Mejez6603/Jolly-Helmet/ESP32 Project/FLOWCHART_BOX3/BOX3_Flow_TFT.pdf

# JOLLY HELMET · BOX 3

# Customer screen flow: what the TFT shows, step by step

### Source: BOX 3 STEP corrected.txt (Box Cycle Designer export) file saved 2026-11-03 00:04 · 36 steps · preset “NEW FLOW”

Pictures are drawn from the screen data in that file (numbers on them are examples).

start / end screen | screen the customer sees | the machine is running | side screen (question or notice) | fault | arrow text = what moves the screen on | 1 | side screen shown at the bottom

Notes
Steps named CL … (Cleaning) and DR … (Drying) are two copies of the same screens in the Designer; the chart shows each picture once. All 48 connections in this chart were checked against the file: they all exist.
The time on the pictures, the progress bar, the coin count and the status line are examples; on the unit they count live.

Every step in the file is drawn.
SAFETY PAUSE (a door opens during a run) is built into the box and is not a step in this file, so it is not drawn.
Removed from the old flow: ratings, time picker, mist choice, free retry and the refill screens (the Refilling Station fills the containers by itself, the box only reads the level).

### START SCREEN

Resting screen. Any touch starts.
TAPS

### CHECKING MAIN CONTAINER

Please wait, 2 seconds. The level of the main container comes from the Refilling Station. Machine: everything off · 2 s fixed
CHECKING C

### WELCOME

Tap → SELECT MODE. If the Refilling Station is silent (15 s) or the container is EMPTY / LOW → the dry-only screen.
WELCOME

### SELECT MODE

The customer picks CLEANING or DRYING. Buttons: CLEANING / DRYING
SELECT MODE

### SELECT MODE · DRY ONLY

CLEANING is greyed out (the container is EMPTY or LOW, or the Refilling Station is not heard). Only DRYING can be pressed. Buttons: DRYING
SELECT DRY ONLY

### INSERT COIN 1

### 15 coins = 5 min. More coins add time, up

to 90 coins (30 min). CANCEL → ① Machine: coin slot ON
CL INSERT COIN / DR INSERT COIN

### OPEN THE DOOR

The door stays unlocked until it is opened. Machine: door lock released
CL OPEN A / DR OPEN A

### PLACE THE HELMET 3

Waits for the helmet. Door closed with no helmet → notice ③.
CL SENSORS A / DR SENSORS A

### CLOSE THE DOOR 3

Door closed + helmet inside → the run starts. No helmet → notice ③.
CL CLOSE DOOR A / DR CLOSE DOOR A

### CLEANING (UV + MIST) 2

Extra coins add time.
Machine: coin slot ON · 3 humidifiers (mist)
- UV 1 + UV 2 · time bought with the coins
CLEANING BAL

### DRYING AFTER CLEANING

Starts by itself when the cleaning time is up. Also reached by CANCEL → CONFIRM ②. Machine: UV 1 + UV 2 · heater (OFF for the last 30 s) · 3:00 min fixed
CL HEATING

### PLEASE WAIT

Short transition before the drying starts.
START HEATING

### DRYING (UV + HEAT) 2

Extra coins add time.
Machine: coin slot ON · UV 1 + UV 2 · heater · time bought with the coins
DR HEATING

### COOLING DOWN

Passive cool-down before the door unlocks. Machine: everything off · 1:00 min fixed
DR COOLDOWN

### OPEN THE DOOR

The door lock is released. Machine: door lock released
CL OPEN B / DR OPEN B

### TAKE THE HELMET 4

Waits until the helmet is out. Door closed with the helmet still inside → notice ④.
CL SENSORS B / DR SENSORS B

### CLOSE THE DOOR 4

Door closed + helmet out → Thank you.
CL CLOSE DOOR B / DR CLOSE DOOR B

### THANK YOU

Then back to the start screen. Machine: everything off · 5 s fixed
CL FINISH / DR FINISH

### ① CANCEL? (COIN STAGE)

Shown by the CANCEL button on INSERT COIN.
YES → back to the start screen
NO → back to the previous screen
CL CANCEL / DR CANCEL

### ② CANCEL? (DURING THE RUN)

Shown by the CANCEL button while cleaning or drying.
CONFIRM → Drying after cleaning
RESUME → back to the previous screen
CL ABORT / DR ABORT

### ③ NO HELMET DETECTED

Shown 2 s, then back to OPEN THE DOOR. after 2 s → Open the door
CL HELMET NOTICE A / DR HELMET NOTICE A

### ④ HELMET STILL INSIDE

Shown 2 s, then back to OPEN THE DOOR. after 2 s → Open the door
CL HELMET NOTICE B / DR HELMET NOTICE B

### MAINTENANCE

Technician only: switched on from the LocalServer page.
MAINTENANCE

### OUT OF ORDER

Shown when the sensor board (helmet, enclosure door) or the relay board stops answering: the box cannot run UV safely and takes no coins.
OUT OF ORDER

### CONTAINER EMPTY OR LOW?

The box offers DRYING only.

### The Refilling Station fills the container by itself: one valve at a

time, EMPTY boxes first, then LOW.

### Nobody has to do anything; the next customer gets CLEANING again as soon as the container reads MID or

more.

### If the station cannot fill it, the owner sees an alert on the Online web

page and the LocalServer.

IF CLEANING WAS CHOSEN | IF DRYING WAS CHOSEN

## SIDE SCREENS (numbers ① ② ③ ④ in the chart above)

tap | after 2 s

tap, container
MID or more

tap, but the container is
EMPTY or LOW, or the
Refilling Station is silent

CLEANING or DRYING button
(DRYING button only, in dry-only)
enough coins | door opened | helmet inside

CLEANING chosen:
door closed + helmet inside

DRYING chosen:
door closed + helmet inside
time is up | automatic | time is up

time is up
time is up
door opened | helmet taken out

door closed,
helmet out

after 5 s: back to the start screen
