Mejez6603/Jolly-Helmet/ESP32 Project/FLOWCHART_SYSTEM/DFD_LEVEL2_3/JollyHelmet_DFD_Level2_Level3.pdf

# JOLLY HELMET

### Data flow diagram (Level 2)

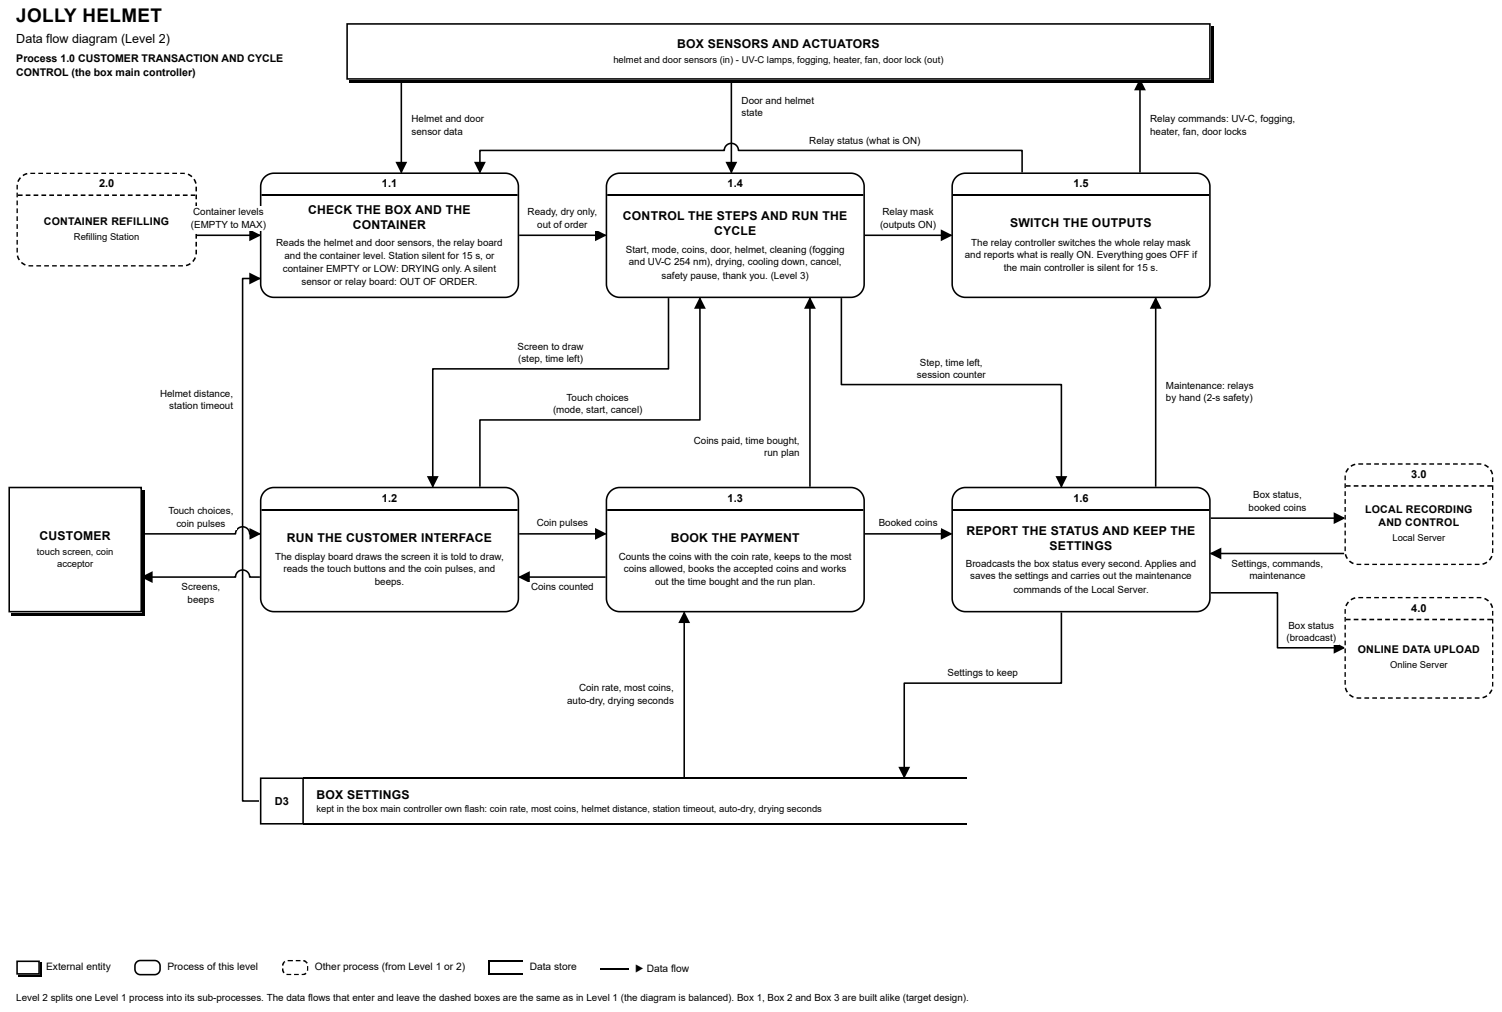
[picture p1: page 1]
External entity; Process of this level; Other process (from Level 1 or 2); Data store; ▶ Data flow; CONTAINER REFILLING; Refilling Station; LOCAL RECORDING AND CONTROL; Local Server; Online Server; CONTAINER; CYCLE; beeps.; SETTINGS; BOX SETTINGS; state; Relay commands: UV-C, fogging,; Touch choices, coin pulses; Screens, beeps; Relay mask (outputs ON); Coin pulses; Coins counted; run plan; Booked coins; Box status, booked coins; Settings, commands, maintenance; Box status (broadcast)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

BOX SENSORS AND ACTUATORS

Process 1.0 CUSTOMER TRANSACTION AND CYCLE
CONTROL (the box main controller)

helmet and door sensors (in) - UV-C lamps, fogging, heater, fan, door lock (out)

Door and helmet

Helmet and door
sensor data

heater, fan, door locks

Relay status (what is ON)

CHECK THE BOX AND THE

Container levels
(EMPTY to MAX)

Ready, dry only,
out of order

CONTROL THE STEPS AND RUN THE

SWITCH THE OUTPUTS

Reads the helmet and door sensors, the relay board
and the container level. Station silent for 15 s, or
container EMPTY or LOW: DRYING only. A silent
sensor or relay board: OUT OF ORDER.

The relay controller switches the whole relay mask
and reports what is really ON. Everything goes OFF if

Start, mode, coins, door, helmet, cleaning (fogging
and UV-C 254 nm), drying, cooling down, cancel,
safety pause, thank you. (Level 3)

the main controller is silent for 15 s.

Screen to draw
(step, time left)

Step, time left,
session counter

Maintenance: relays
by hand (2-s safety)

Touch choices
(mode, start, cancel)

Coins paid, time bought,

REPORT THE STATUS AND KEEP THE

CUSTOMER
touch screen, coin
acceptor

RUN THE CUSTOMER INTERFACE
The display board draws the screen it is told to draw,
reads the touch buttons and the coin pulses, and

BOOK THE PAYMENT

Counts the coins with the coin rate, keeps to the most
coins allowed, books the accepted coins and works
out the time bought and the run plan.

Broadcasts the box status every second. Applies and
saves the settings and carries out the maintenance

commands of the Local Server.

ONLINE DATA UPLOAD

Settings to keep

Coin rate, most coins,
auto-dry, drying seconds

kept in the box main controller own flash: coin rate, most coins, helmet distance, station timeout, auto-dry, drying seconds

Level 2 splits one Level 1 process into its sub-processes. The data flows that enter and leave the dashed boxes are the same as in Level 1 (the diagram is balanced). Box 1, Box 2 and Box 3 are built alike (target design).

Process 2.0 CONTAINER REFILLING (the Refilling Station)

### MAIN CONTAINERS AND WATER SUPPLY

3 water-level sensors (in) - 3 valves (out)

1.0

CUSTOMER
TRANSACTION AND
CYCLE CONTROL
box main controllers

4.0

ONLINE DATA UPLOAD
Online Server

3.0

LOCAL RECORDING
AND CONTROL
Local Server

2.1

### READ THE SENSORS AND WORK OUT THE LEVELS

5 times a second, a 1 s average of the 3 sensors: EMPTY, LOW, MID, HIGH or MAX from the level edges. A stuck or jumping sensor = SENSOR FAULT: level UNKNOWN, no refill.

2.2

### MANAGE THE REFILL QUEUE

A container that is EMPTY or LOW joins the queue. EMPTY ones first, then LOW; the one that waited longest, then Box 1, 2, 3. A refill that is running is never interrupted.

2.3

### CONTROL THE VALVES

Opens the valve of the next box (only ONE valve can be open), closes it at MAX or when the refill fails, waits 60 s before a retry, runs the manual valve test. (Level 3)

2.5

### BROADCAST THE LEVELS AND THE STATUS

Every second, and at once when something changes: levels and raw values of the 3 containers, the open valve, who is waiting, the failed refills. Listen only for the others.

2.4

### KEEP THE STATION SETTINGS

Receives the level edges, waiting times, retry time and the valve test from the Local Server and saves them in the station flash.

D4 STATION SETTINGS kept in the Refilling Station own flash: level edges, waiting times, retry time, test seconds

Water-level readings
(5 times a second)

Valve commands
(open, close)

Level edges,
sensor fault rule

Levels of the
3 containers

Next box
to refill

Refill worked
or failed

Levels (rise, MAX reached)

Levels and
raw values

Who is waiting
(the queue)

Valve open,
failed refill

Container levels (broadcast)

Container levels (broadcast)

Levels, valve state, failures

Station
settings,
Settings to keep | valve test

Saved settings

Stall times, retry,
valve test request

Process 3.0 LOCAL RECORDING AND CONTROL (the Local Server)

4.0

ONLINE DATA
UPLOAD
Online Server

### OWNER / TECHNICIAN

authorized administrator

### TEAM

ENTRY board (spare
ESP32)

1.0

CUSTOMER
TRANSACTION AND
CYCLE CONTROL
box main controllers

2.0

CONTAINER
REFILLING
Refilling Station

3.5

### SEND THE TOTALS

Every 10 s the totals, the coin value and the last 10 sessions go to the Online Server by radio (and a heartbeat every second).

3.2

### RECORD THE SESSIONS AND THE TOTALS

A finished or cancelled session is recorded: date, time, box, Finished or Cancelled, coins, minutes. Totals and revenue (booked coins) are updated.

3.1

### RECEIVE THE RADIO DATA

Listens on ESP-NOW channel 1: box status and booked coins of each box, sensor and relay status, Refilling Station levels, valves, queue and failures.

D1.2 SESSION LOG AND TOTALS kept in the log storage (FFat); a backup CSV can be downloaded and restored

3.3

### SERVE THE CONTROL CENTER

Wi-Fi JollyHelmet-Local: Dashboard every second, Box and Refilling Station pages, day viewer, settings, CSV download and restore, history file, crash reports.

3.4

### KEEP AND SEND THE SETTINGS

Rules, sensors, auto-dry, drying seconds, level edges, maintenance and valve test: saved in flash and sent to the box main controllers and the station.

### D1.3 HISTORY AND CRASHES

history.json, last 3 crash reports

### D1.1 SETTINGS

kept in flash

Totals, last
10 sessions
(every 10 s) | New session,
| booked coins

Live status of the boxes
and the station

Session record,
totals

Totals, last
10 sessions

Session log,
totals

Settings, rules,
maintenance,
valve test

History file,
restored backup

History rows,
crash reports | Settings to keep | Saved settings Settings
(to show)

Settings, rules, maintenance, backup to restore

Control Center pages,
session log, totals, CSV

Previous customers
(history.json)

Box status,
booked coins

Levels, valve state,
failures

Settings, commands,
maintenance

Station settings,
valve test

Process 4.0 ONLINE DATA UPLOAD (the Online Server)

1.0

CUSTOMER
TRANSACTION AND
CYCLE CONTROL
box main controllers

2.0

CONTAINER
REFILLING
Refilling Station

3.0

LOCAL RECORDING
AND CONTROL
Local Server

### OWNER / TECHNICIAN

authorized administrator

4.1

### LISTEN TO THE RADIO

Only listens, never sends. Hears the box status of every box board, the Refilling Station levels and the totals of the Local Server on ESP-NOW channel 1. Takes a snapshot every second.

4.2

### COUNT THE STATISTICS

Counts the sessions per box, per hour, per weekday and per day, and takes the totals and the revenue from the Local Server.

4.3

### WORK OUT THE ALERTS

Every second looks at the snapshot: out of order, Refilling Station offline, refill failed, board not heard.

D5 SNAPSHOT, STATISTICS AND ALERTS kept in the Online Server memory: the last 1 s snapshot, the sessions per box, hour, weekday and day, the alerts

4.5

### KEEP THE SETUP

Router-style setup page on the own Wi-Fi of the Online Server: Wi-Fi name, Blynk token, interval and time zone. The Wi-Fi is tested first, then Blynk.

4.4

### UPLOAD TO THE BLYNK CLOUD

Every interval (30 s to 1 h, default 1 min) a burst of 5 to 10 s: leaves the radio, joins the Wi-Fi, writes the live data, the box steps and any alert, returns to channel 1. (Level 3)

D6 | ONLINE SETUP kept in flash: Wi-Fi name and password, Blynk tokens, interval, time zone
D2.1 | PRIVATE DEVICE V0 live data (JSON)
D2.2 | PUBLIC DEVICE V0 box steps only
D2.3 | ALERT EVENT push to the Blynk app

Box status
(broadcast)

Container levels
(broadcast)

Totals, last 10
sessions (10 s)

Session counters,
totals

Snapshot
(every 1 s)
Statistics | Snapshot | Alerts

Snapshot, statistics,
alerts

Wi-Fi, Blynk token,
interval, time zone

Setup page,
Wi-Fi test result

Setup to keep

Wi-Fi, token, interval,
time zone

Live data
(HTTPS)

Box steps
(HTTPS)

Alert
event

Process 5.0 ONLINE MONITORING (the website)

### OWNER / TECHNICIAN

authorized administrator: Monitor, Alerts and Reports pages (the Blynk token is typed once and kept in that browser)

5.2

### SHOW THE MONITOR AND THE REPORTS

Live, delayed or old data, each box drawn as a machine, the three level dials of the Refilling Station, the network map and the reports.

5.1

### READ THE LIVE DATA

The Monitor page asks Blynk every 10 s, only while the tab is open and visible, with the token typed once and kept in that browser.

5.3

### SHOW THE ALERTS

Alerts in four levels (critical, warning, notice, info) with sounds and a log. The page also says when the data is not yet updated.

### D2.1 PRIVATE DEVICE V0 live data (JSON)

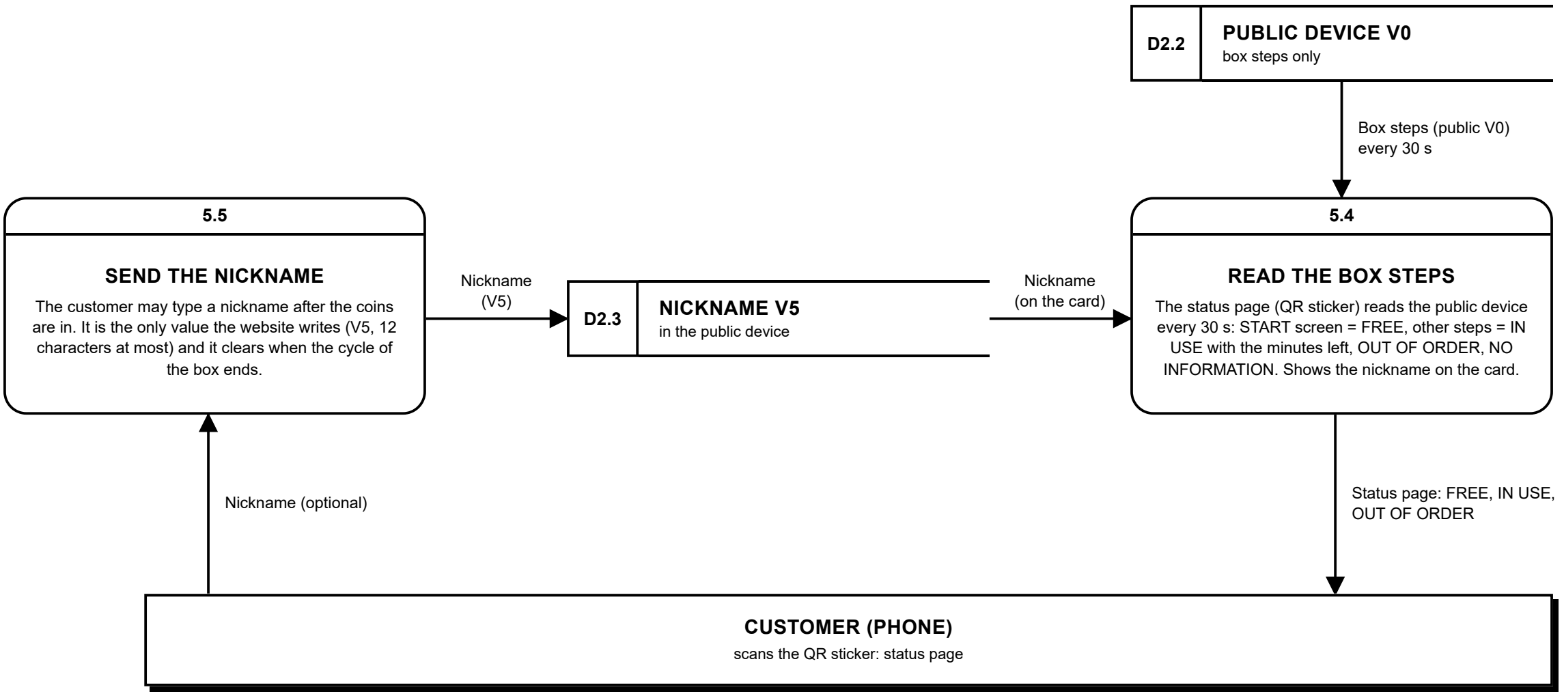
[picture p2: figure]
CUSTOMER (PHONE); scans the QR sticker: status page; PUBLIC DEVICE V0; box steps only; SEND THE NICKNAME; the box ends.; NICKNAME V5; in the public device; READ THE BOX STEPS; Box steps (public V0) every 30 s; Nickname (V5); Nickname (on the card); Status page: FREE, IN USE, OUT OF ORDER Nickname (optional)

The customer may type a nickname after the coins are in. It is the only value the website writes (V5, 12 characters at most) and it clears when the cycle of

The status page (QR sticker) reads the public device every 30 s: START screen = FREE, other steps = IN USE with the minutes left, OUT OF ORDER, NO INFORMATION. Shows the nickname on the card.

Monitor, reports | Alerts with sounds

Live data (private V0)
every 10 s
Live data | Live data

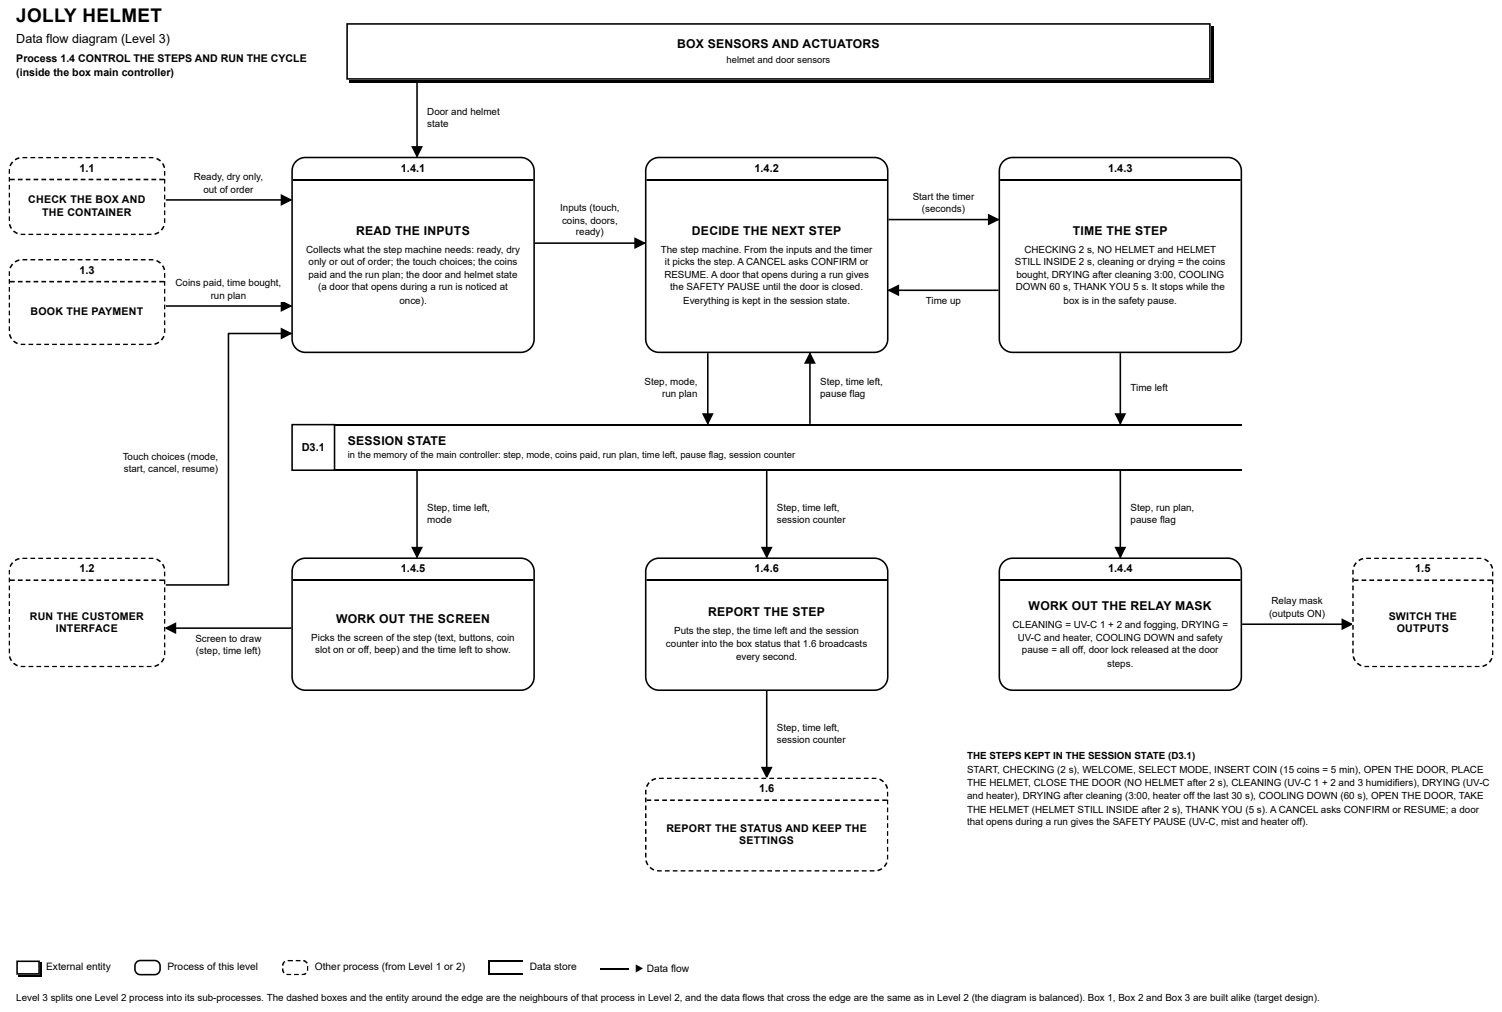
[picture p3: page 6]
SWITCH THE OUTPUTS; SETTINGS; once).; SESSION STATE; every second.; steps.; run plan; Inputs (touch, coins, doors, ready); Time up; Step, mode, run plan; Time left; Relay mask (outputs ON)

BOX SENSORS AND ACTUATORS

Process 1.4 CONTROL THE STEPS AND RUN THE CYCLE
(inside the box main controller)

helmet and door sensors

Door and helmet
state

Ready, dry only,
out of order

CHECK THE BOX AND
THE CONTAINER

Start the timer
(seconds)

READ THE INPUTS

DECIDE THE NEXT STEP
The step machine. From the inputs and the timer
it picks the step. A CANCEL asks CONFIRM or
RESUME. A door that opens during a run gives
the SAFETY PAUSE until the door is closed.
Everything is kept in the session state.

TIME THE STEP

Collects what the step machine needs: ready, dry
only or out of order; the touch choices; the coins
paid and the run plan; the door and helmet state
(a door that opens during a run is noticed at

CHECKING 2 s, NO HELMET and HELMET
STILL INSIDE 2 s, cleaning or drying = the coins
bought, DRYING after cleaning 3:00, COOLING
DOWN 60 s, THANK YOU 5 s. It stops while the

Coins paid, time bought,

box is in the safety pause.

BOOK THE PAYMENT

Step, time left,
pause flag

Touch choices (mode,
start, cancel, resume)

in the memory of the main controller: step, mode, coins paid, run plan, time left, pause flag, session counter

mode

session counter

Step, run plan,

WORK OUT THE RELAY MASK
CLEANING = UV-C 1 + 2 and fogging, DRYING =
UV-C and heater, COOLING DOWN and safety
pause = all off, door lock released at the door

REPORT THE STEP

RUN THE CUSTOMER
INTERFACE

WORK OUT THE SCREEN
Picks the screen of the step (text, buttons, coin
slot on or off, beep) and the time left to show.

Screen to draw
(step, time left)

Puts the step, the time left and the session
counter into the box status that 1.6 broadcasts

THE STEPS KEPT IN THE SESSION STATE (D3.1)
START, CHECKING (2 s), WELCOME, SELECT MODE, INSERT COIN (15 coins = 5 min), OPEN THE DOOR, PLACE
THE HELMET, CLOSE THE DOOR (NO HELMET after 2 s), CLEANING (UV-C 1 + 2 and 3 humidifiers), DRYING (UV-C
and heater), DRYING after cleaning (3:00, heater off the last 30 s), COOLING DOWN (60 s), OPEN THE DOOR, TAKE
THE HELMET (HELMET STILL INSIDE after 2 s), THANK YOU (5 s). A CANCEL asks CONFIRM or RESUME; a door
that opens during a run gives the SAFETY PAUSE (UV-C, mist and heater off).

REPORT THE STATUS AND KEEP THE

Level 3 splits one Level 2 process into its sub-processes. The dashed boxes and the entity around the edge are the neighbours of that process in Level 2, and the data flows that cross the edge are the same as in Level 2 (the diagram is balanced). Box 1, Box 2 and Box 3 are built alike (target design).

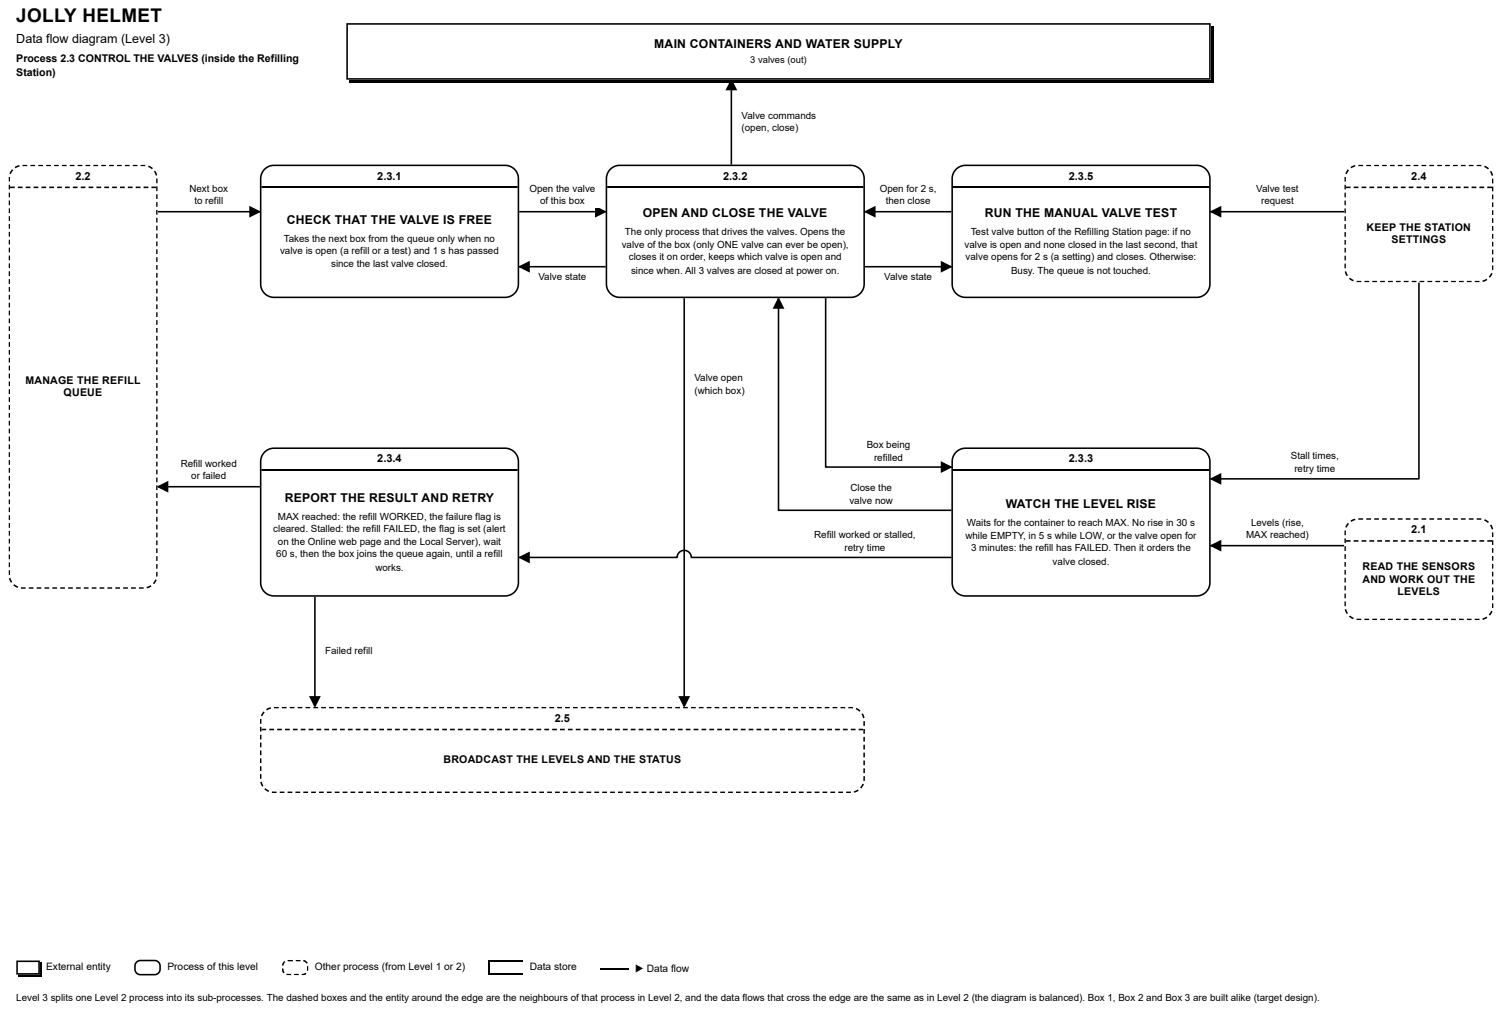
[picture p4: page 7]
3 valves (out); QUEUE; works.; valve closed.; Next box to refill; Valve state; Open for 2 s, then close; Valve test request; Valve commands (open, close); Box being refilled; Close the valve now; Levels (rise, MAX reached); Stall times, retry time; Refill worked or failed; Failed refill; Valve open (which box)

MAIN CONTAINERS AND WATER SUPPLY

Process 2.3 CONTROL THE VALVES (inside the Refilling
Station)

Open the valve
of this box

OPEN AND CLOSE THE VALVE
The only process that drives the valves. Opens the
valve of the box (only ONE valve can ever be open),
closes it on order, keeps which valve is open and
since when. All 3 valves are closed at power on.

RUN THE MANUAL VALVE TEST
Test valve button of the Refilling Station page: if no
valve is open and none closed in the last second, that
valve opens for 2 s (a setting) and closes. Otherwise:

CHECK THAT THE VALVE IS FREE
Takes the next box from the queue only when no
valve is open (a refill or a test) and 1 s has passed

KEEP THE STATION
SETTINGS

since the last valve closed.

Busy. The queue is not touched.

MANAGE THE REFILL

REPORT THE RESULT AND RETRY
MAX reached: the refill WORKED, the failure flag is
cleared. Stalled: the refill FAILED, the flag is set (alert
on the Online web page and the Local Server), wait
60 s, then the box joins the queue again, until a refill

WATCH THE LEVEL RISE

Waits for the container to reach MAX. No rise in 30 s
while EMPTY, in 5 s while LOW, or the valve open for
3 minutes: the refill has FAILED. Then it orders the

Refill worked or stalled,
retry time

READ THE SENSORS
AND WORK OUT THE
LEVELS

BROADCAST THE LEVELS AND THE STATUS

Level 3 splits one Level 2 process into its sub-processes. The dashed boxes and the entity around the edge are the neighbours of that process in Level 2, and the data flows that cross the edge are the same as in Level 2 (the diagram is balanced). Box 1, Box 2 and Box 3 are built alike (target design).
