Mejez6603/Jolly-Helmet/ESP32 Project/ARCHIVE_2026-11-12_BEFORE_BOX1_2_LIKE_BOX3/README.txt

Backup taken 2026-11-12 BEFORE Box 1 and Box 2 were rebuilt like Box 3 (and before the LocalServer / Online Server / Online Web / Refilling Station
were adjusted for it). Copies of the folders exactly as they were:
  ESP32_S3A ESP32_S3C ESP32_A1 ESP32_A2 ESP32_A3 ESP32_C1 ESP32_C2      (the OLD Box 1 / Box 2 firmware, the one that was flashed and tested at the school)
  ESP32_S3B ESP32_B1 ESP32_B2 ESP32_B3                                    (Box 3, the template)
  ESP32_LOCALSRV ESP32_ONLINESRV ESP32_REFILL ESP32_REFILL_FAKE ONLINE_WEB
To go back: copy the folder you need over the one in ESP32 Project (keep the folder name), then compile and flash it again.
