Mejez6603/Jolly-Helmet/ESP32 Project/Chart.png

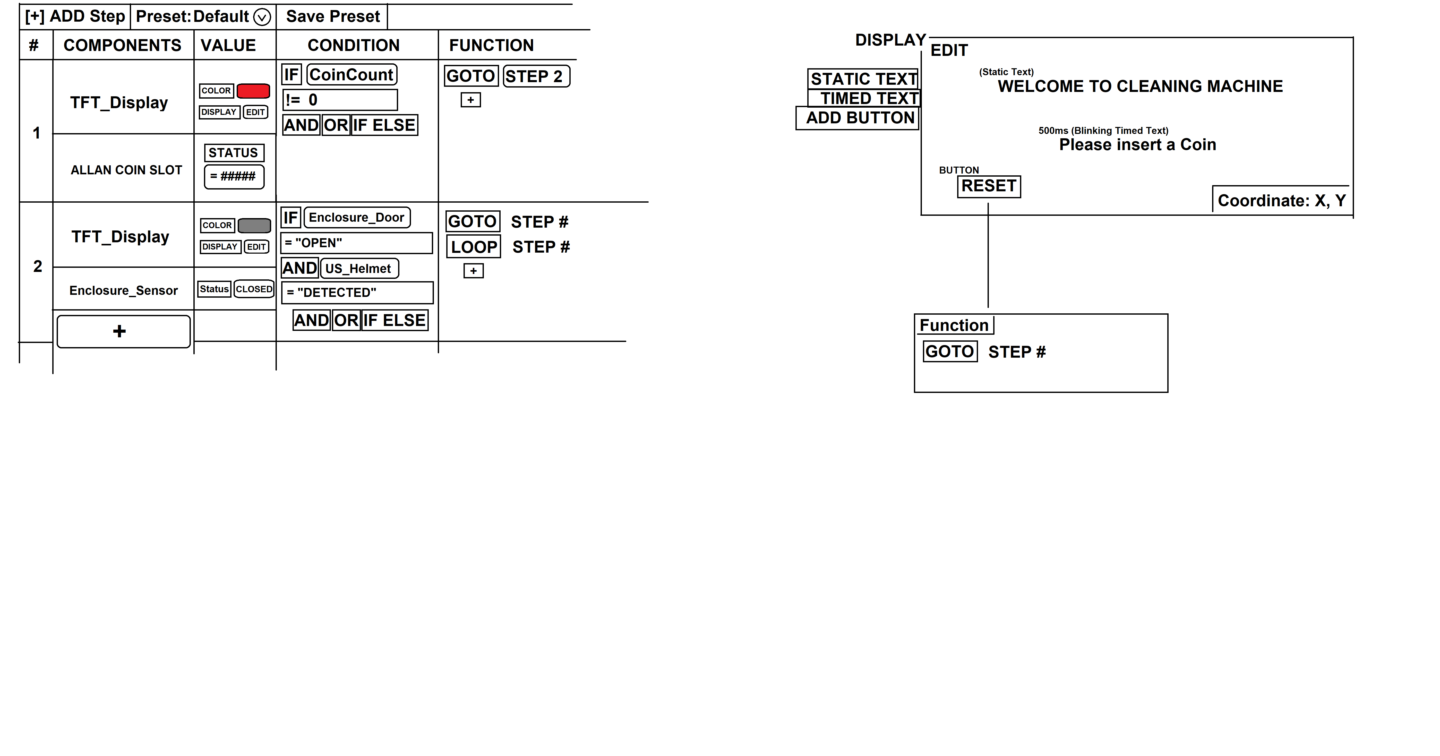
ESP32 Project/Chart.png
