Mejez6603/Jolly-Helmet/ESP32 Project/CONCEPTUAL_FRAMEWORK/Jolly_Helmet_Conceptual_Framework.png

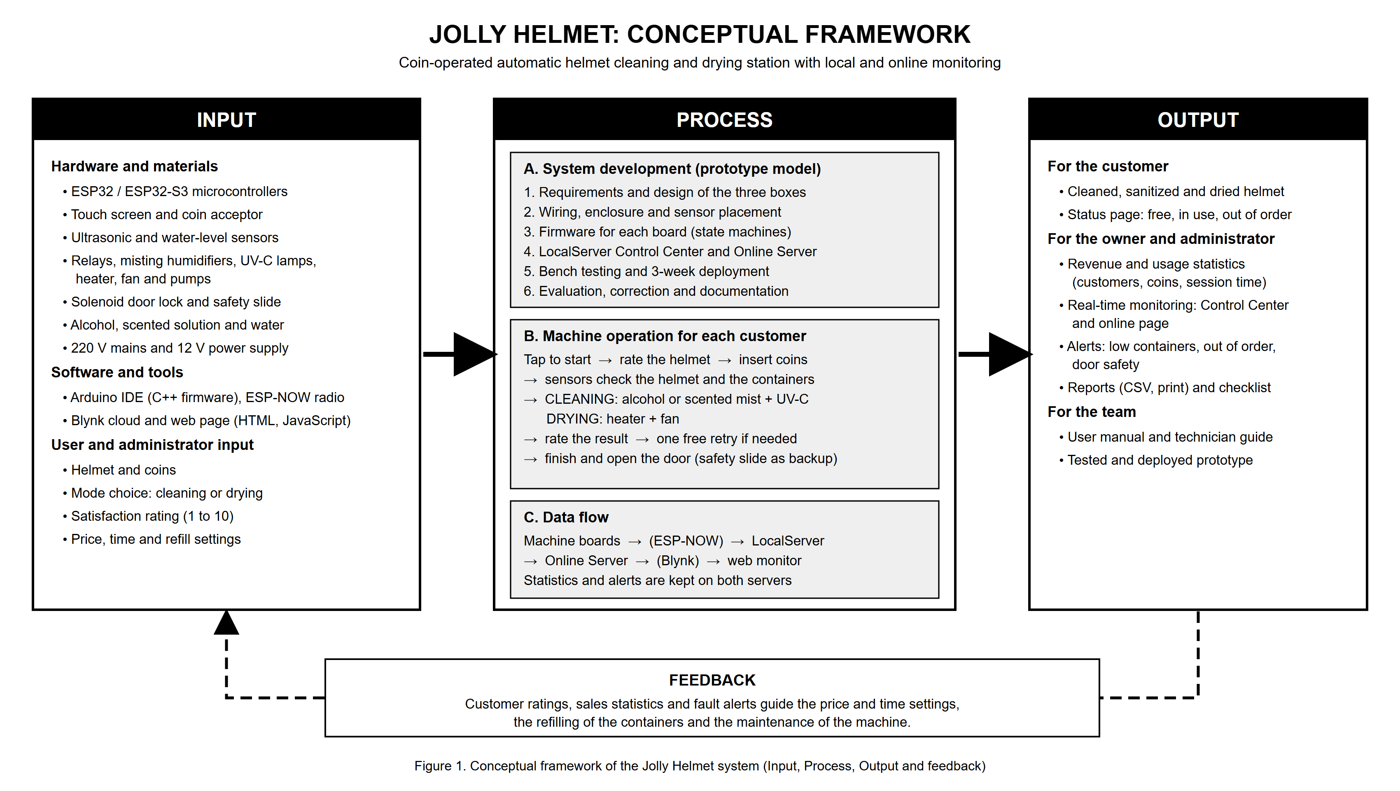
ESP32 Project/CONCEPTUAL_FRAMEWORK/Jolly_Helmet_Conceptual_Framework.png
