Mejez6603/Jolly-Helmet/ESP32 Project/CONCEPTUAL_FRAMEWORK/Jolly_Helmet_Overall_Flowchart.png

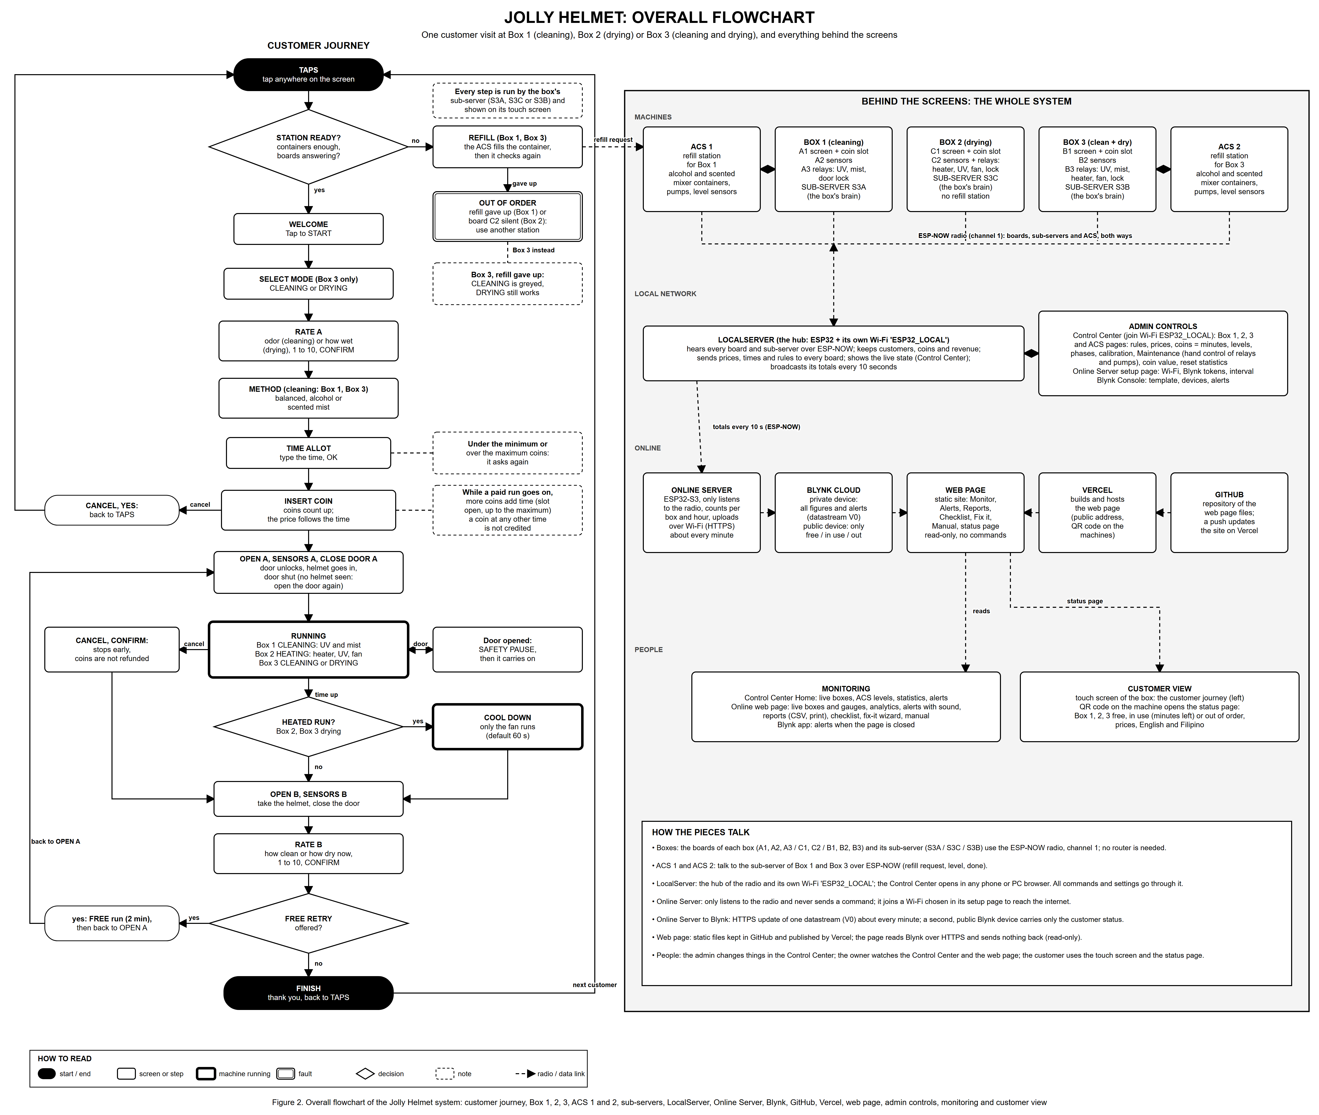
ESP32 Project/CONCEPTUAL_FRAMEWORK/Jolly_Helmet_Overall_Flowchart.png
