Mejez6603/Jolly-Helmet/ESP32 Project/CONCEPTUAL_FRAMEWORK/Jolly_Helmet_System_Flowchart_Dense.png

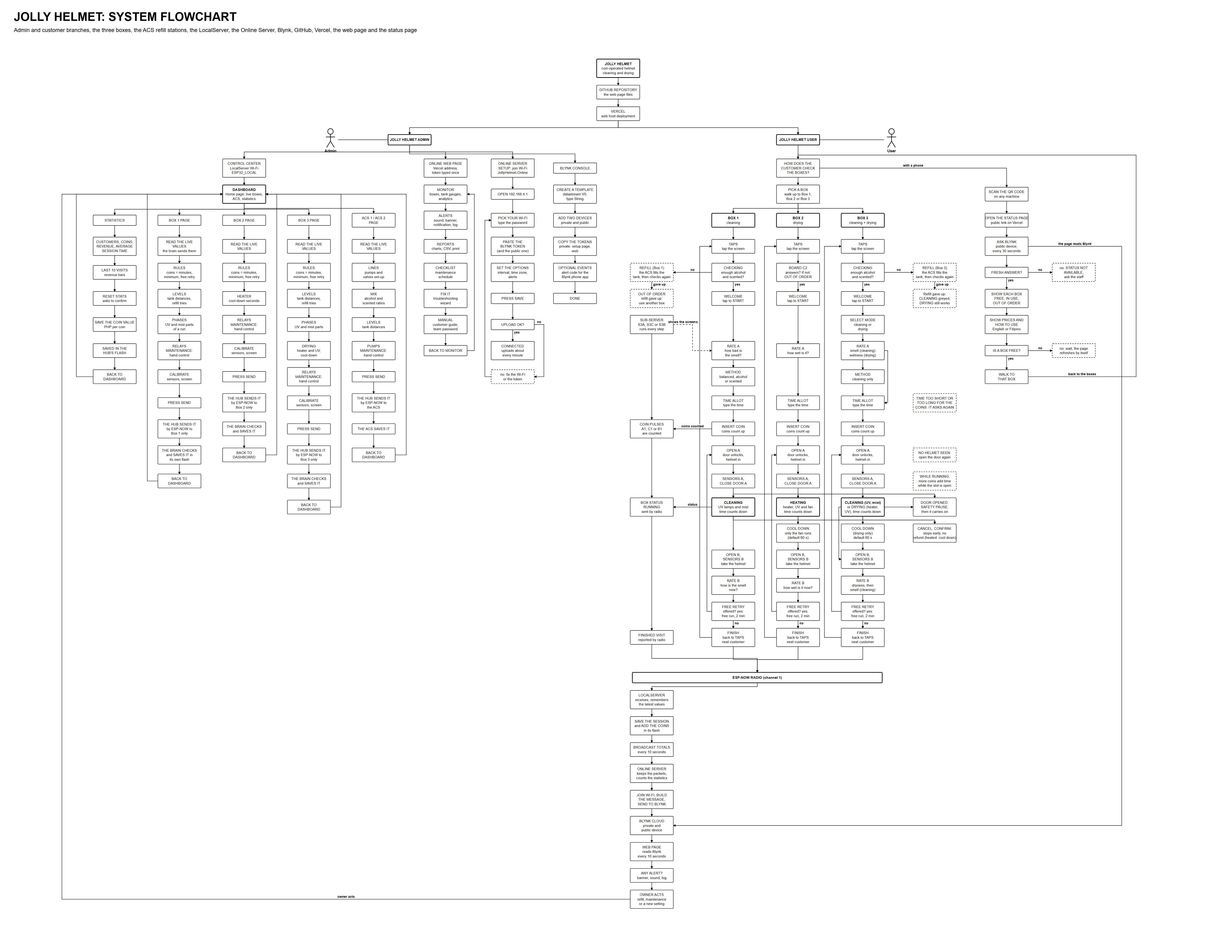
ESP32 Project/CONCEPTUAL_FRAMEWORK/Jolly_Helmet_System_Flowchart_Dense.png
