Mejez6603/Jolly-Helmet/ESP32 Project/CONCEPTUAL_FRAMEWORK/Jolly_Helmet_Whole_System_Chart.png

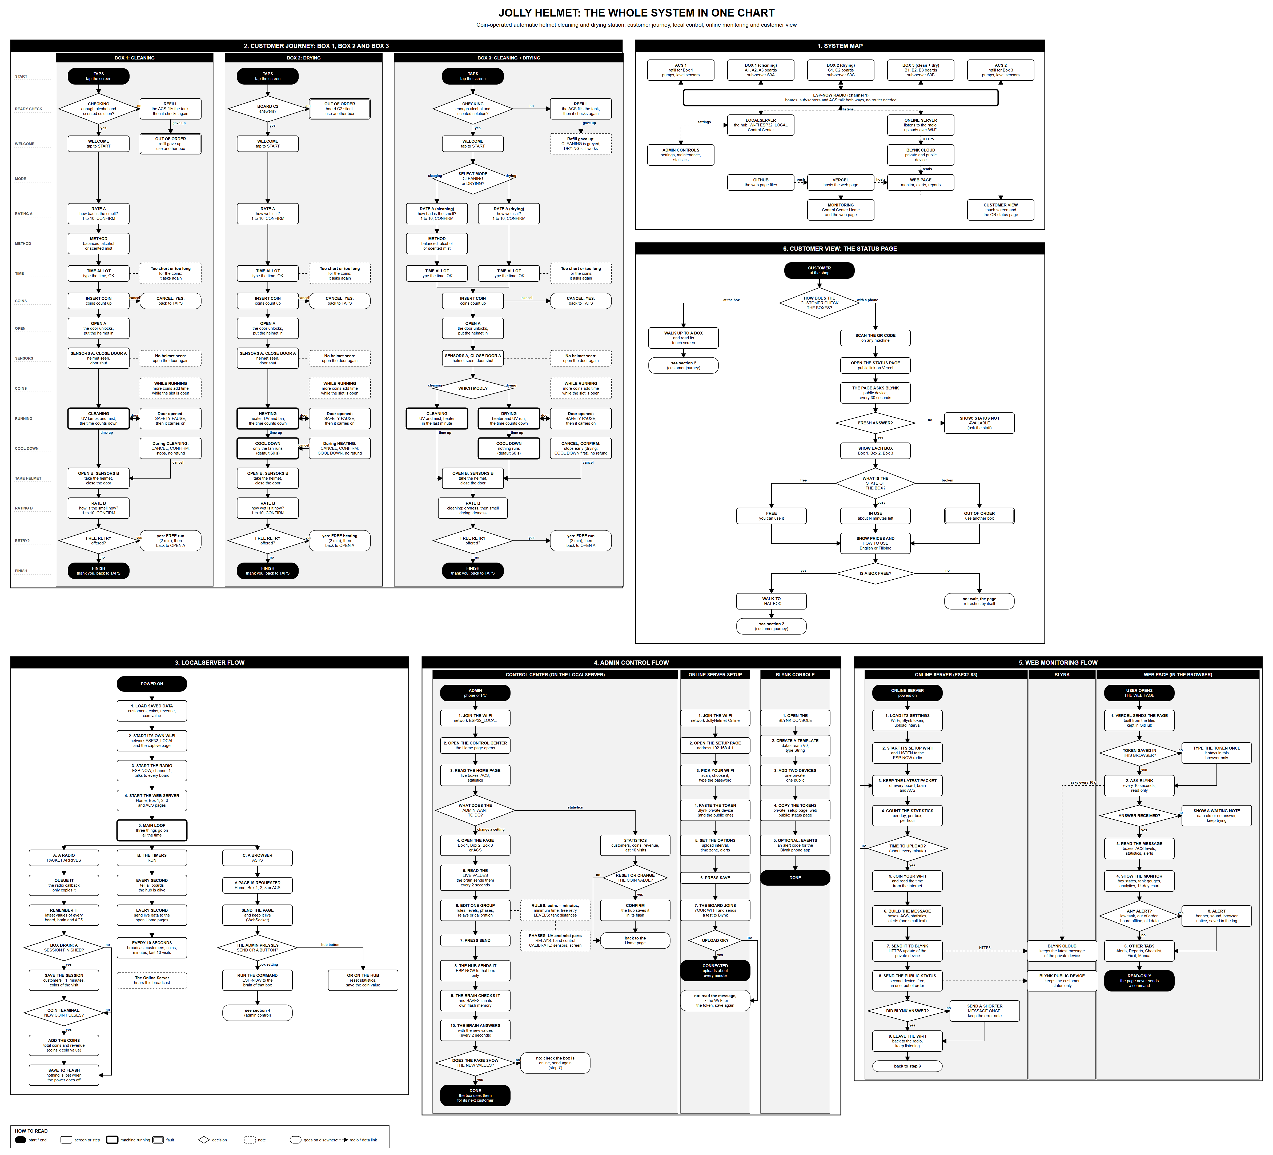
ESP32 Project/CONCEPTUAL_FRAMEWORK/Jolly_Helmet_Whole_System_Chart.png
