Mejez6603/Jolly-Helmet/ESP32 Project/FLOWCHART_BOX3/BOX3_Flow_TFT.png

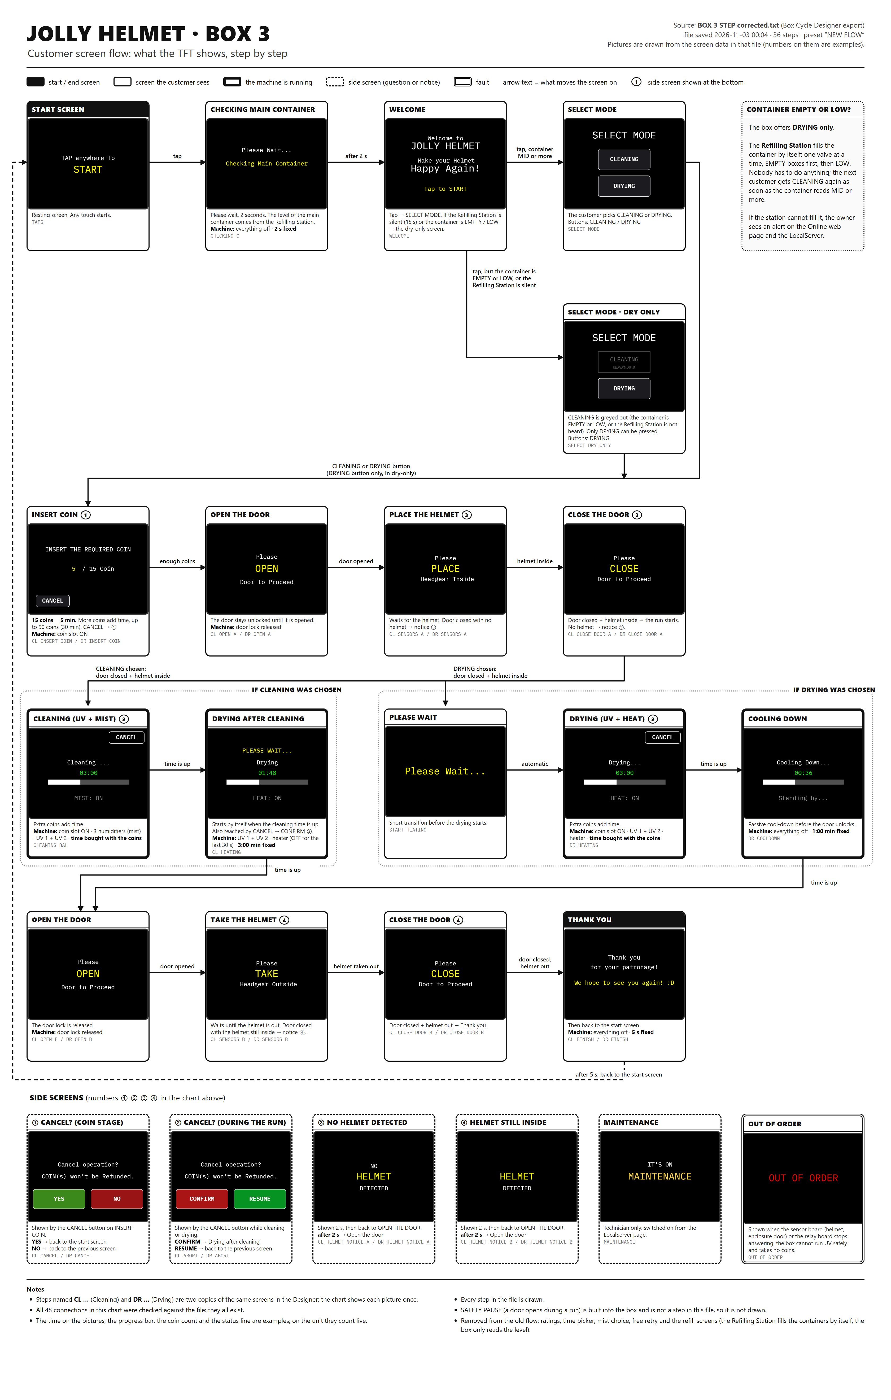
ESP32 Project/FLOWCHART_BOX3/BOX3_Flow_TFT.png
