Mejez6603/Jolly-Helmet/ESP32 Project/FLOWCHART_BOX3/screens/01_TAPS.png

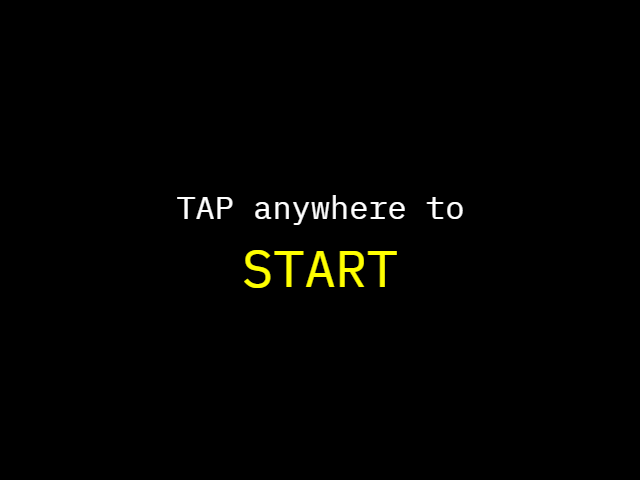
ESP32 Project/FLOWCHART_BOX3/screens/01_TAPS.png
