Mejez6603/Jolly-Helmet/ESP32 Project/FLOWCHART_BOX3/screens/02_CHECKING_C.png

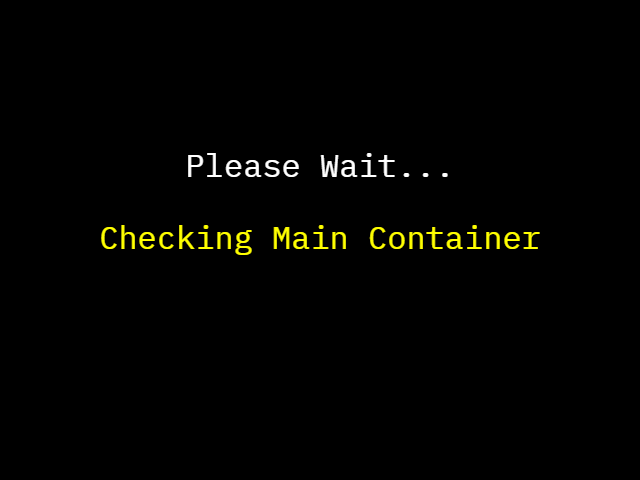
ESP32 Project/FLOWCHART_BOX3/screens/02_CHECKING_C.png
