Mejez6603/Jolly-Helmet/ESP32 Project/FLOWCHART_BOX3/screens/03_WELCOME.png

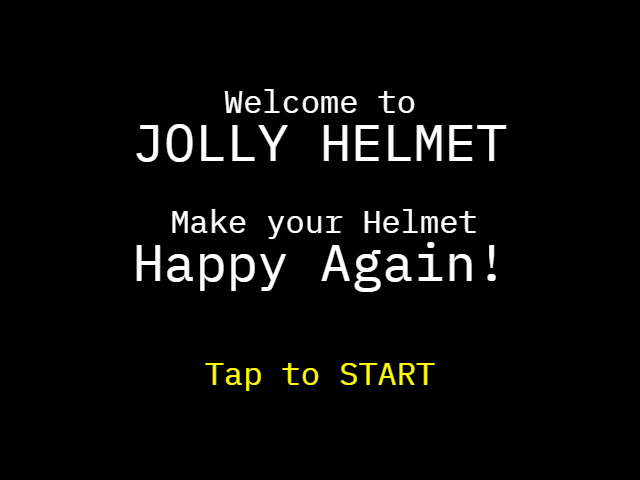
ESP32 Project/FLOWCHART_BOX3/screens/03_WELCOME.png
