Mejez6603/Jolly-Helmet/ESP32 Project/FLOWCHART_BOX3/screens/09_CL_CLOSE_DOOR_A.png

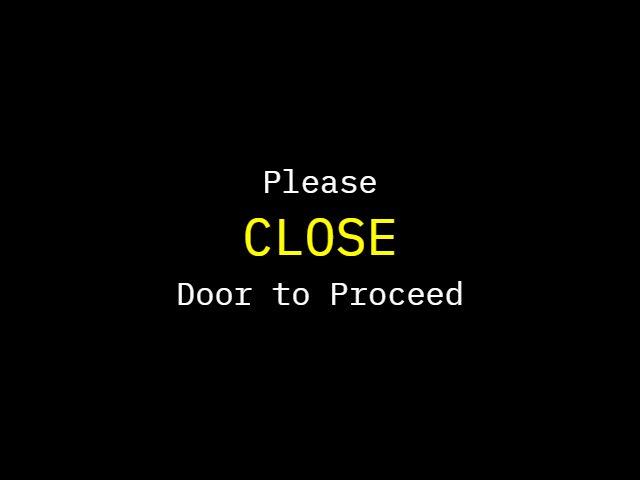
ESP32 Project/FLOWCHART_BOX3/screens/09_CL_CLOSE_DOOR_A.png
