Mejez6603/Jolly-Helmet/ESP32 Project/FLOWCHART_BOX3/screens/17_CL_CANCEL.png

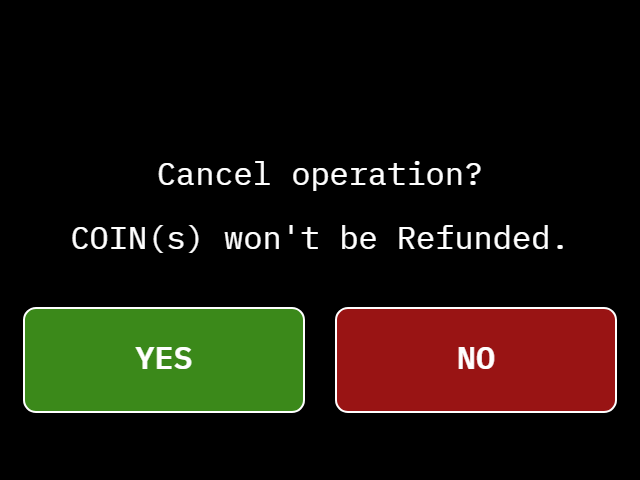
ESP32 Project/FLOWCHART_BOX3/screens/17_CL_CANCEL.png
