Mejez6603/Jolly-Helmet/ESP32 Project/FLOWCHART_BOX3/screens/19_CL_HELMET_NOTICE_B.png

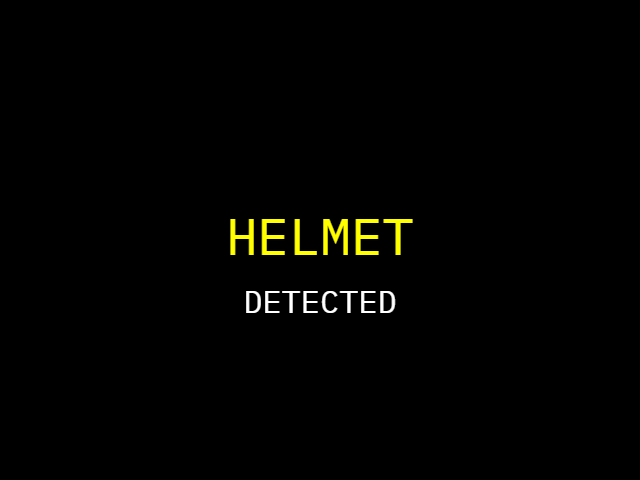
ESP32 Project/FLOWCHART_BOX3/screens/19_CL_HELMET_NOTICE_B.png
