Mejez6603/Jolly-Helmet/ESP32 Project/FLOWCHART_BOX3/screens/25_DR_HEATING.png

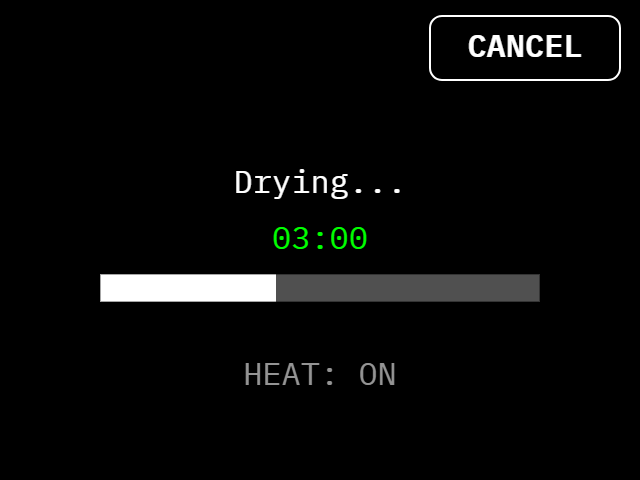
ESP32 Project/FLOWCHART_BOX3/screens/25_DR_HEATING.png
