Mejez6603/Jolly-Helmet/ESP32 Project/FLOWCHART_BOX3/screens/30_DR_FINISH.png

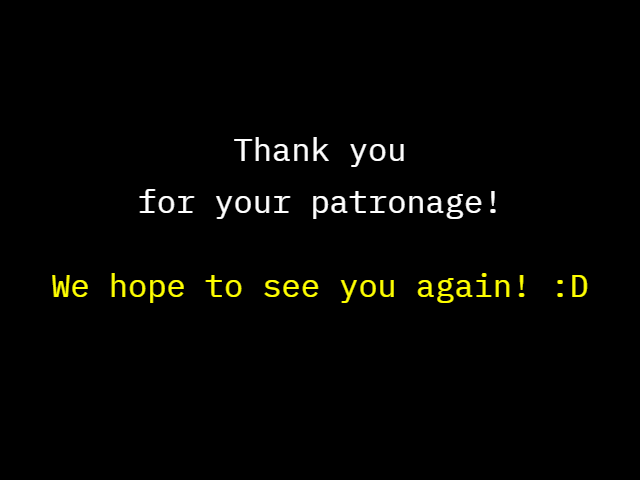
ESP32 Project/FLOWCHART_BOX3/screens/30_DR_FINISH.png
