Mejez6603/Jolly-Helmet/ESP32 Project/FLOWCHART_SYSTEM/CLEANING_CYCLE_PART2/Customer_Cleaning_Cycle_Part2.png

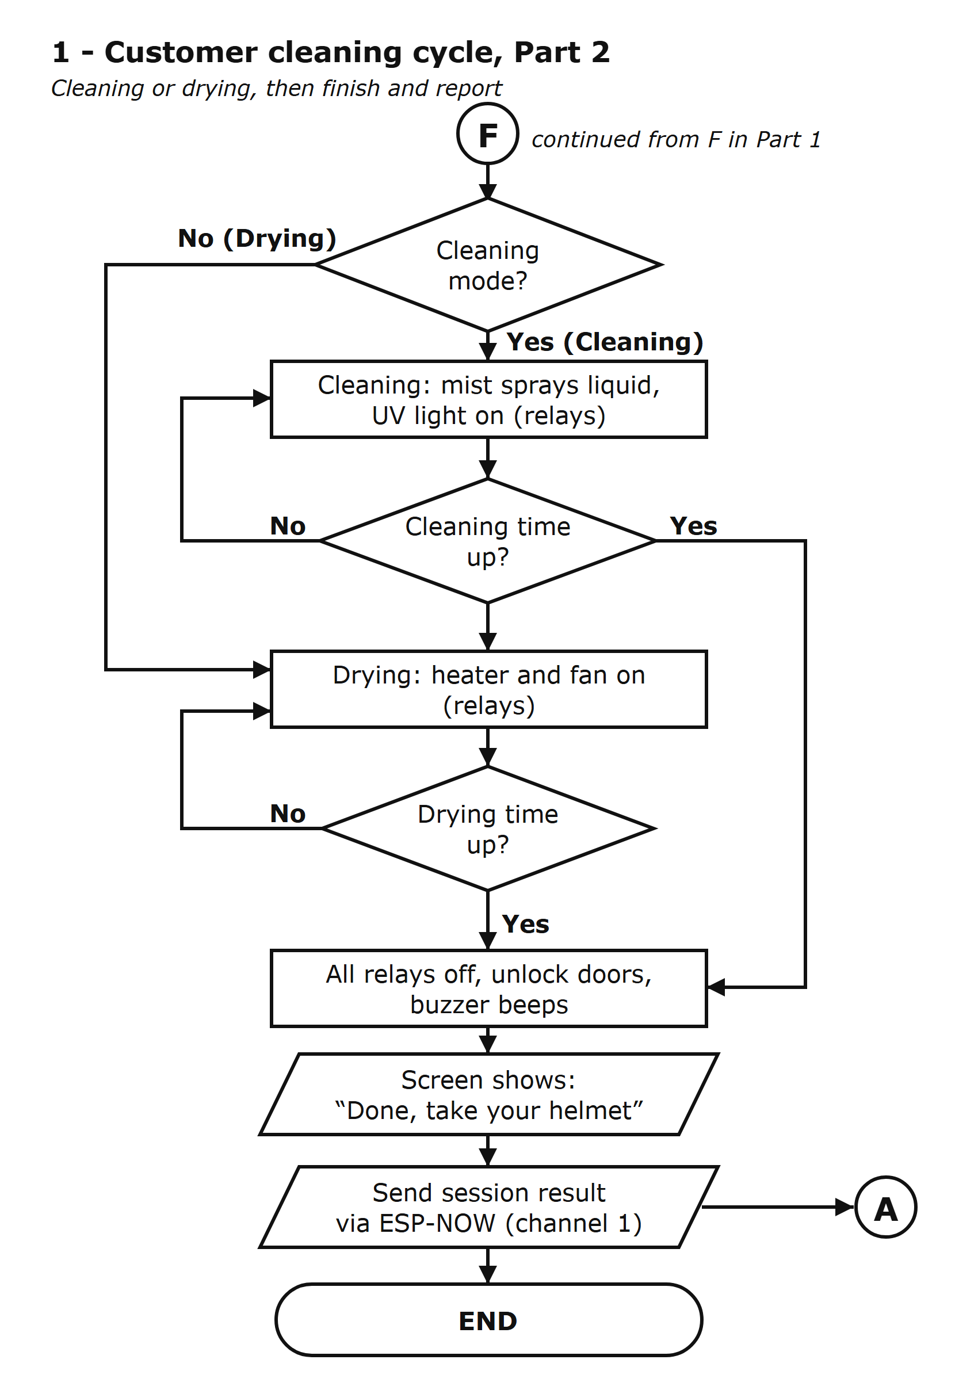
ESP32 Project/FLOWCHART_SYSTEM/CLEANING_CYCLE_PART2/Customer_Cleaning_Cycle_Part2.png
