Mejez6603/Jolly-Helmet/ESP32 Project/FLOWCHART_SYSTEM/DATA_FLOW/JollyHelmet_DataFlow.png

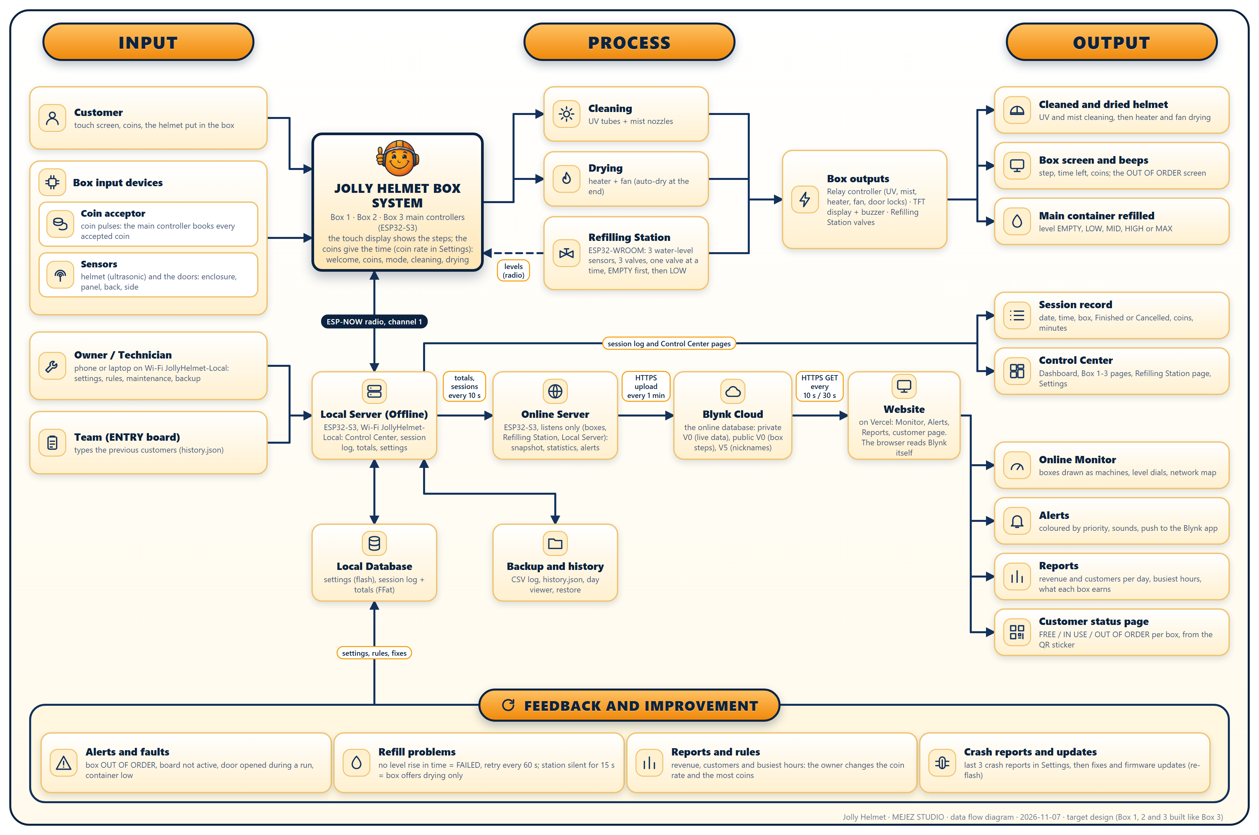
ESP32 Project/FLOWCHART_SYSTEM/DATA_FLOW/JollyHelmet_DataFlow.png
