Mejez6603/Jolly-Helmet/ESP32 Project/FLOWCHART_SYSTEM/DFD_LEVEL1/JollyHelmet_DFD_Level1.png

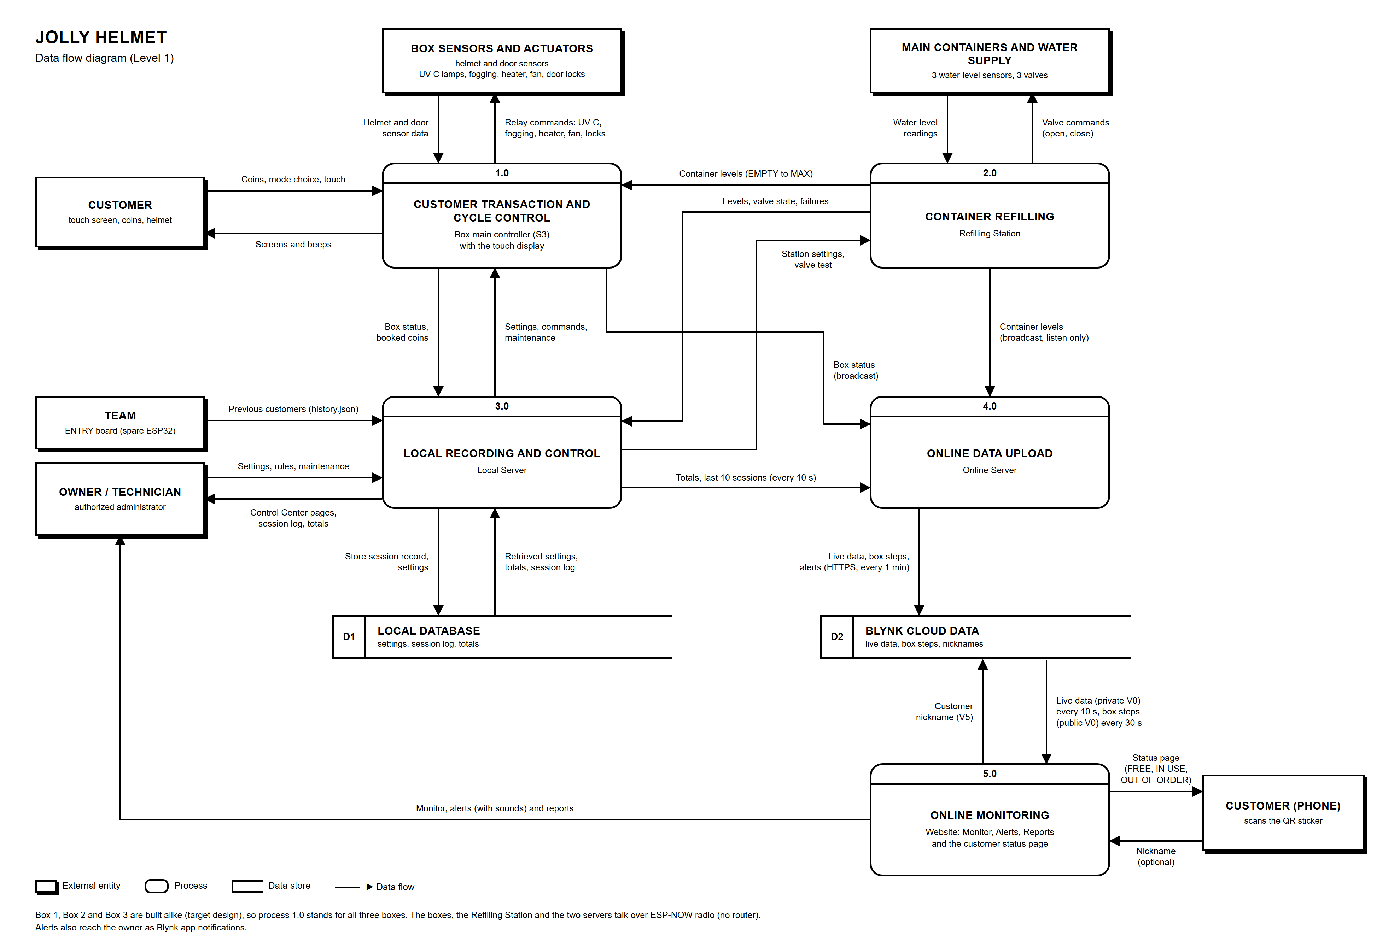
ESP32 Project/FLOWCHART_SYSTEM/DFD_LEVEL1/JollyHelmet_DFD_Level1.png
