Mejez6603/Jolly-Helmet/ESP32 Project/FLOWCHART_SYSTEM/DFD_LEVEL2_3/png/DFD_L2_2_Refilling_Station.png

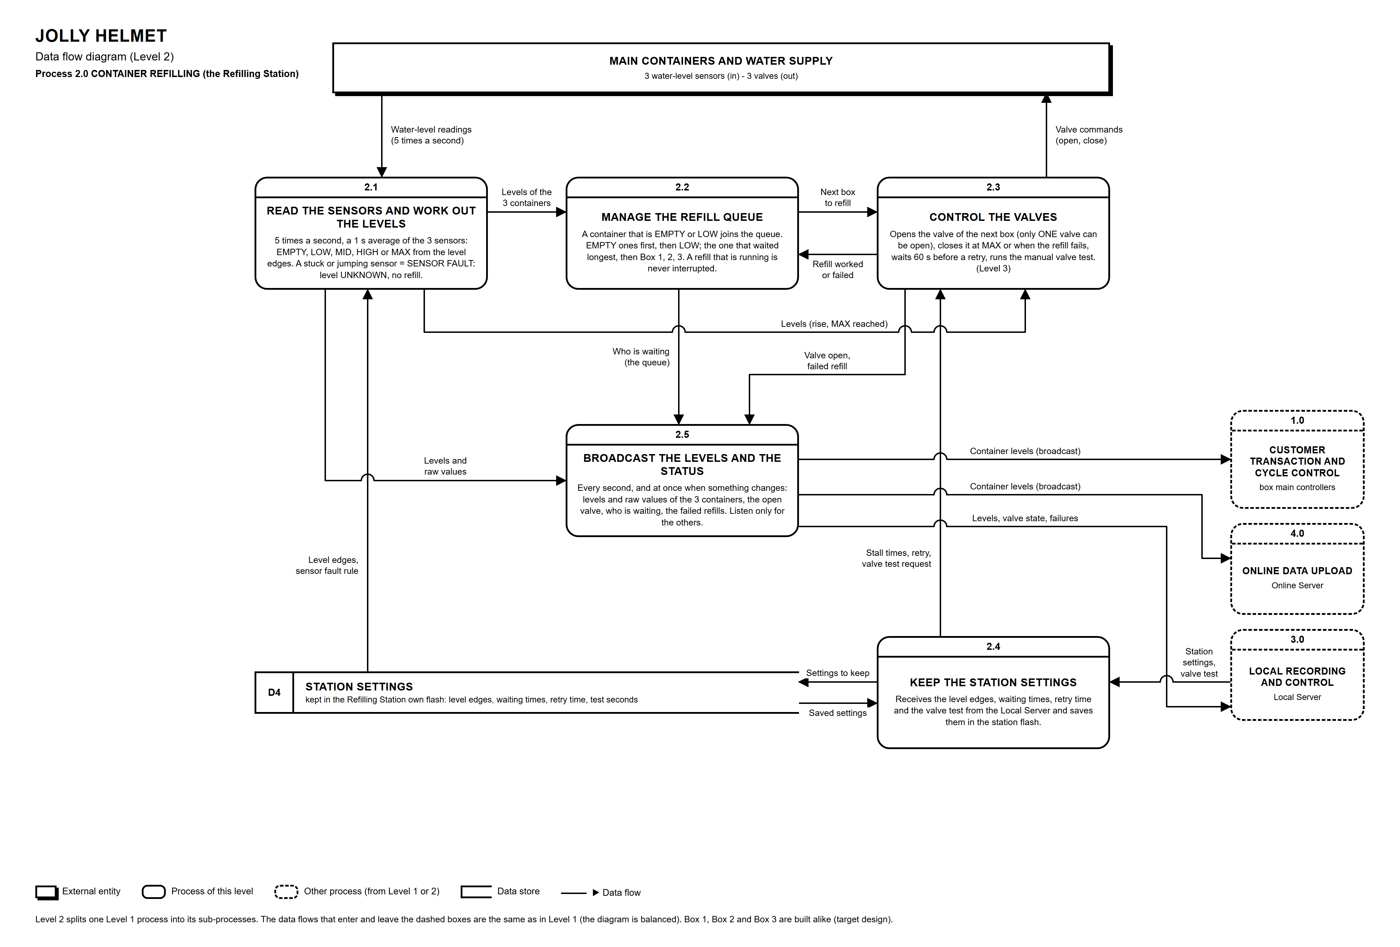
ESP32 Project/FLOWCHART_SYSTEM/DFD_LEVEL2_3/png/DFD_L2_2_Refilling_Station.png
