Mejez6603/Jolly-Helmet/ESP32 Project/FLOWCHART_SYSTEM/DFD_LEVEL2_3/png/DFD_L2_4_Online_Server.png

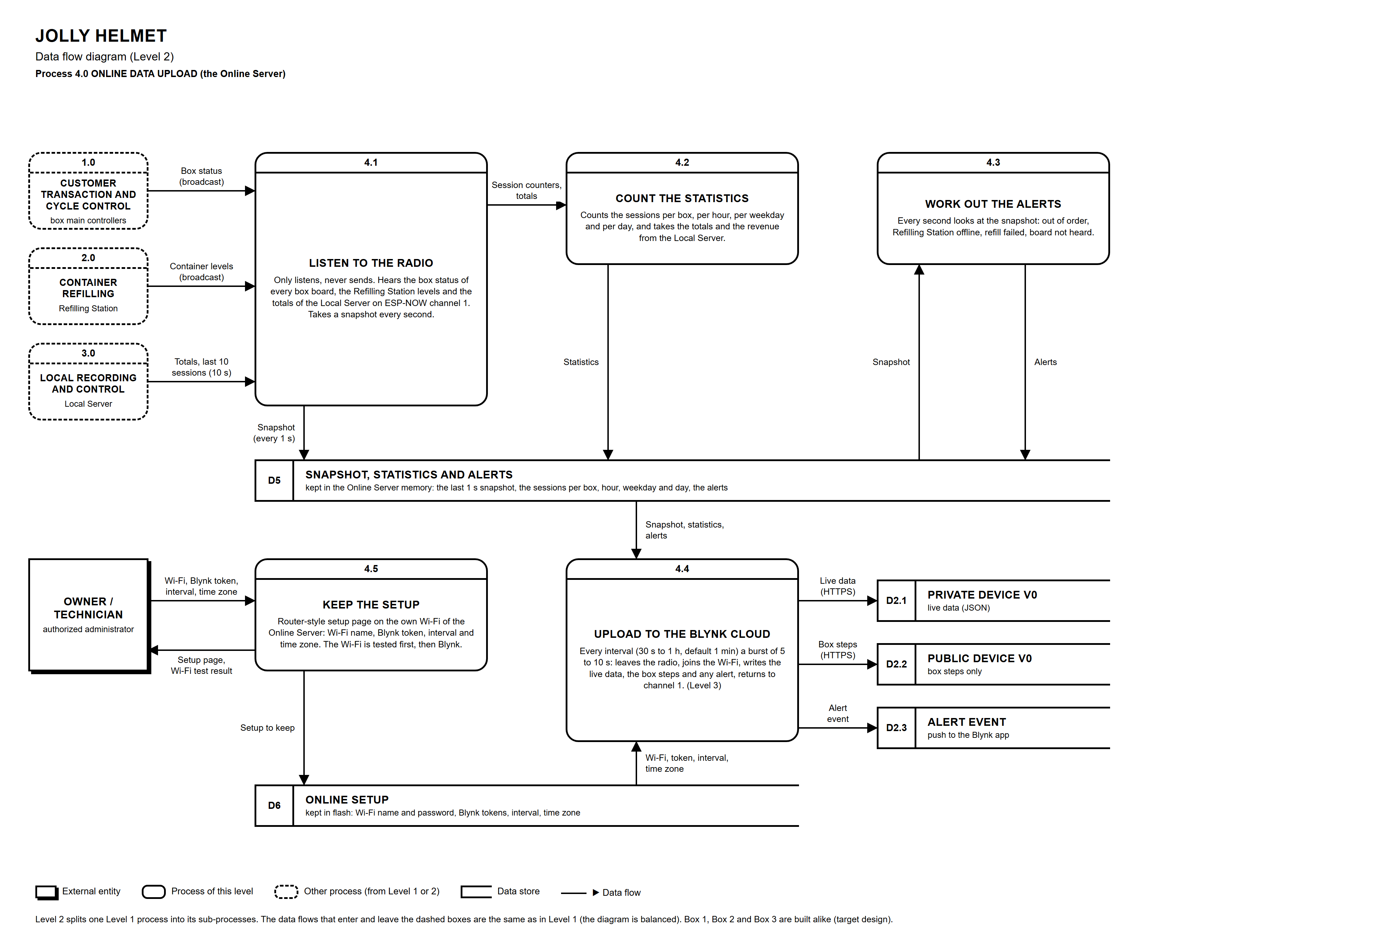
ESP32 Project/FLOWCHART_SYSTEM/DFD_LEVEL2_3/png/DFD_L2_4_Online_Server.png
