Mejez6603/Jolly-Helmet/ESP32 Project/FLOWCHART_SYSTEM/DFD_LEVEL2_3/png/DFD_L2_5_Website.png

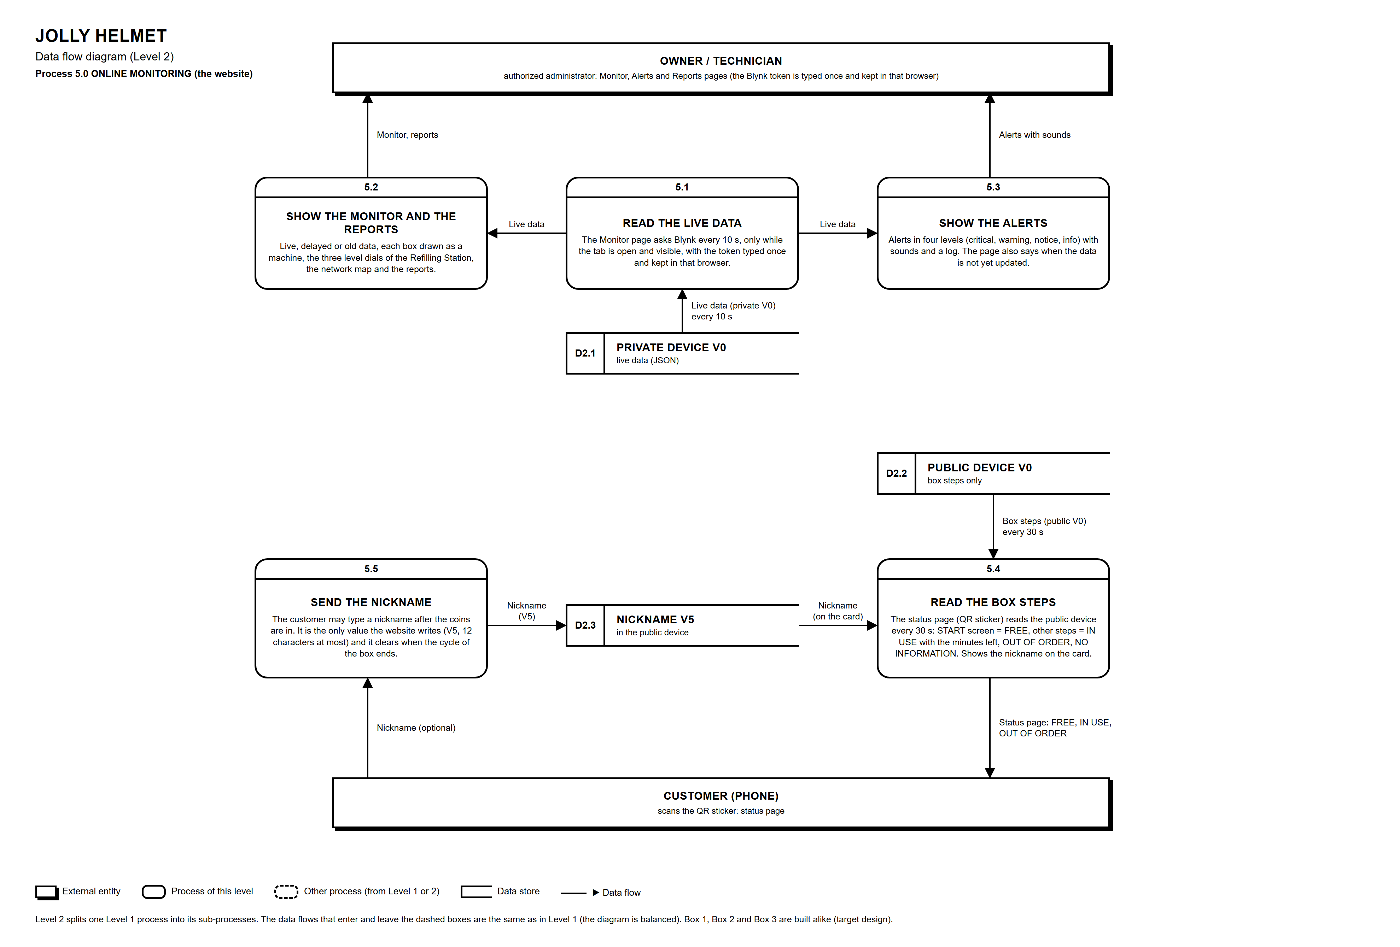
ESP32 Project/FLOWCHART_SYSTEM/DFD_LEVEL2_3/png/DFD_L2_5_Website.png
