Mejez6603/Jolly-Helmet/ESP32 Project/FLOWCHART_SYSTEM/DFD_LEVEL2_3/png/DFD_L3_1_Run_the_cycle_1.4.png

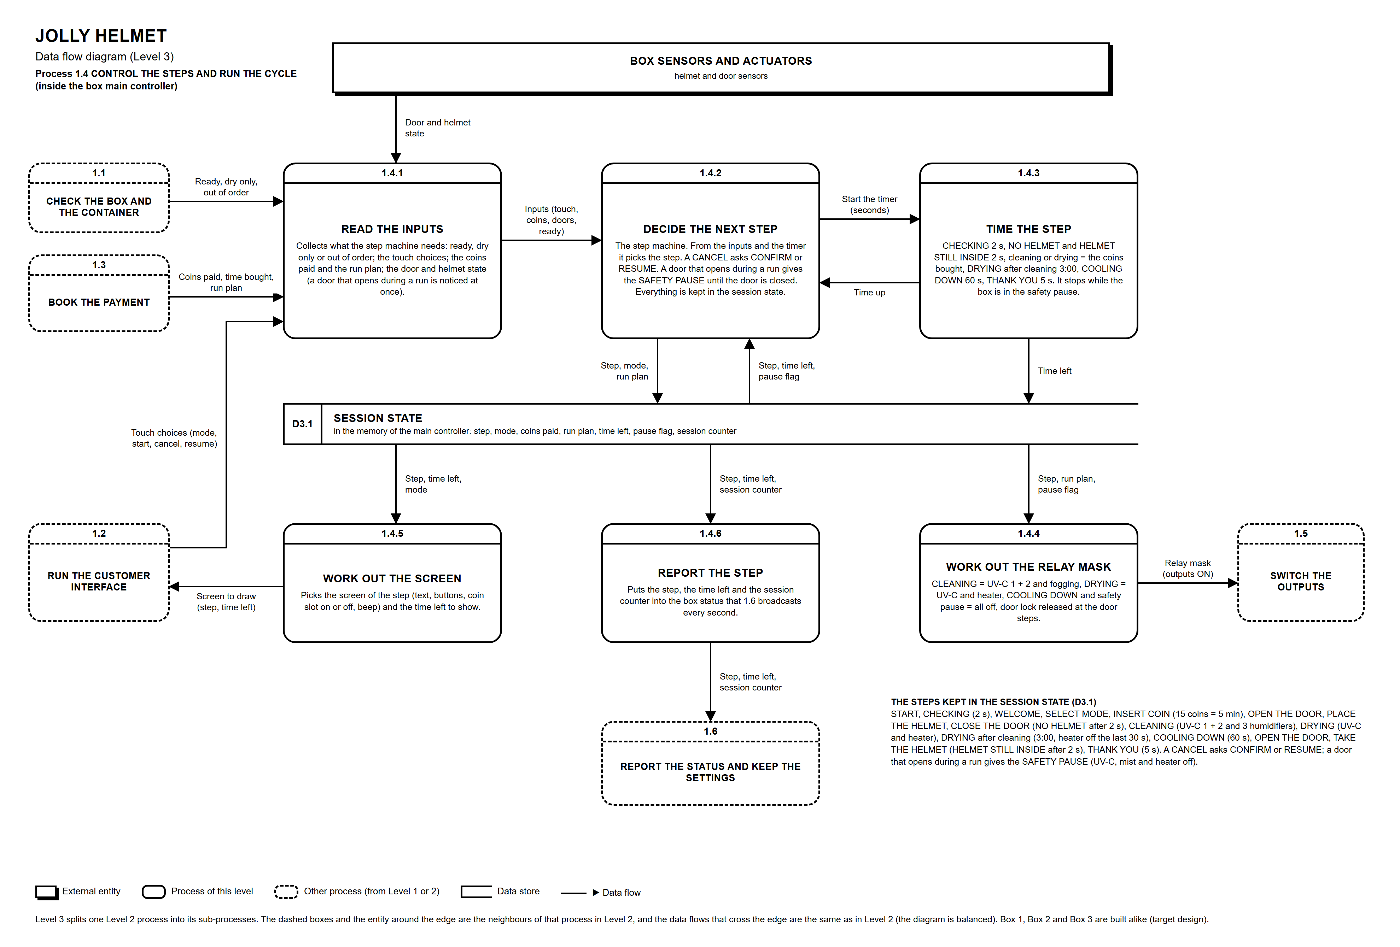
ESP32 Project/FLOWCHART_SYSTEM/DFD_LEVEL2_3/png/DFD_L3_1_Run_the_cycle_1.4.png
