Mejez6603/Jolly-Helmet/ESP32 Project/FLOWCHART_SYSTEM/IPO_FRAMEWORK/JollyHelmet_IPO_Framework.png

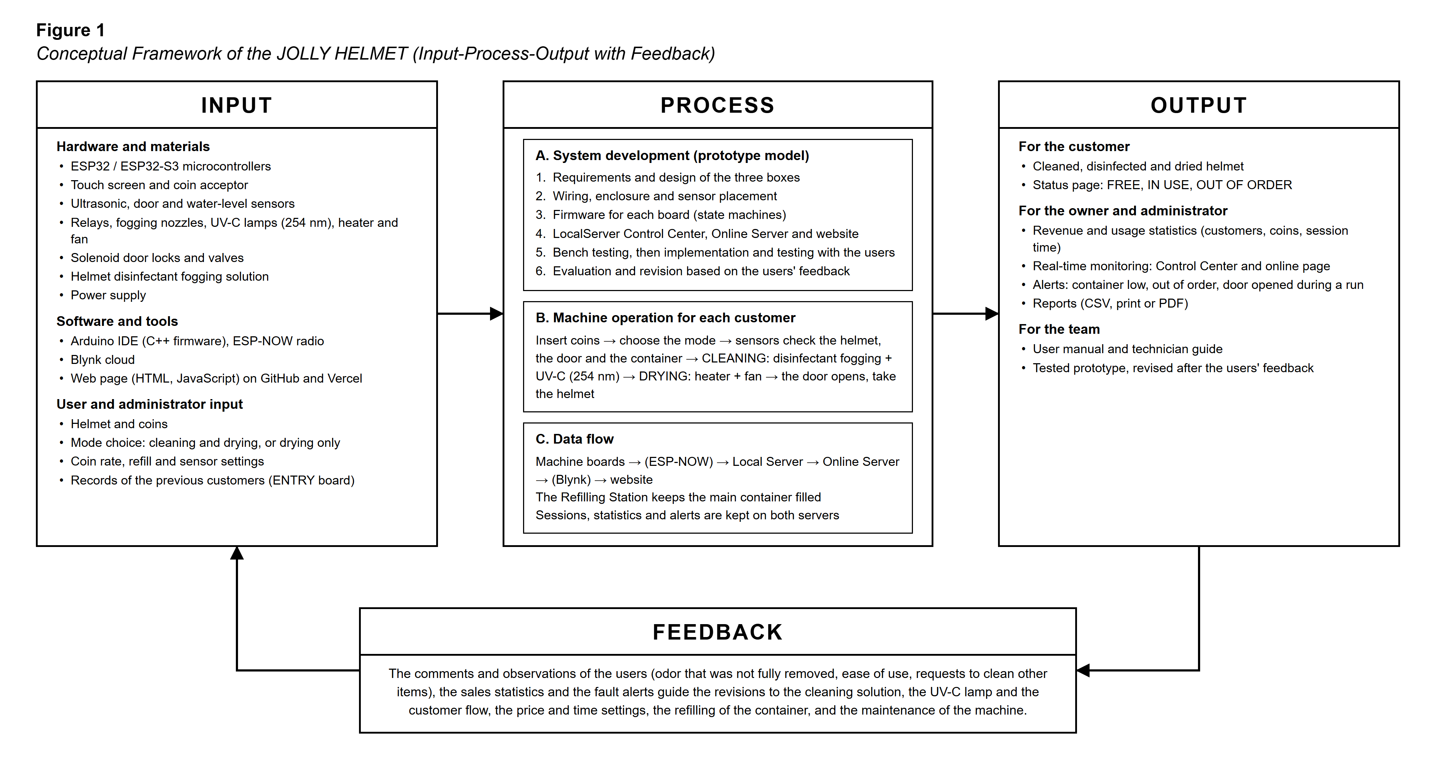
ESP32 Project/FLOWCHART_SYSTEM/IPO_FRAMEWORK/JollyHelmet_IPO_Framework.png
