Mejez6603/Jolly-Helmet/ESP32 Project/FLOWCHART_SYSTEM/png/01_system.png

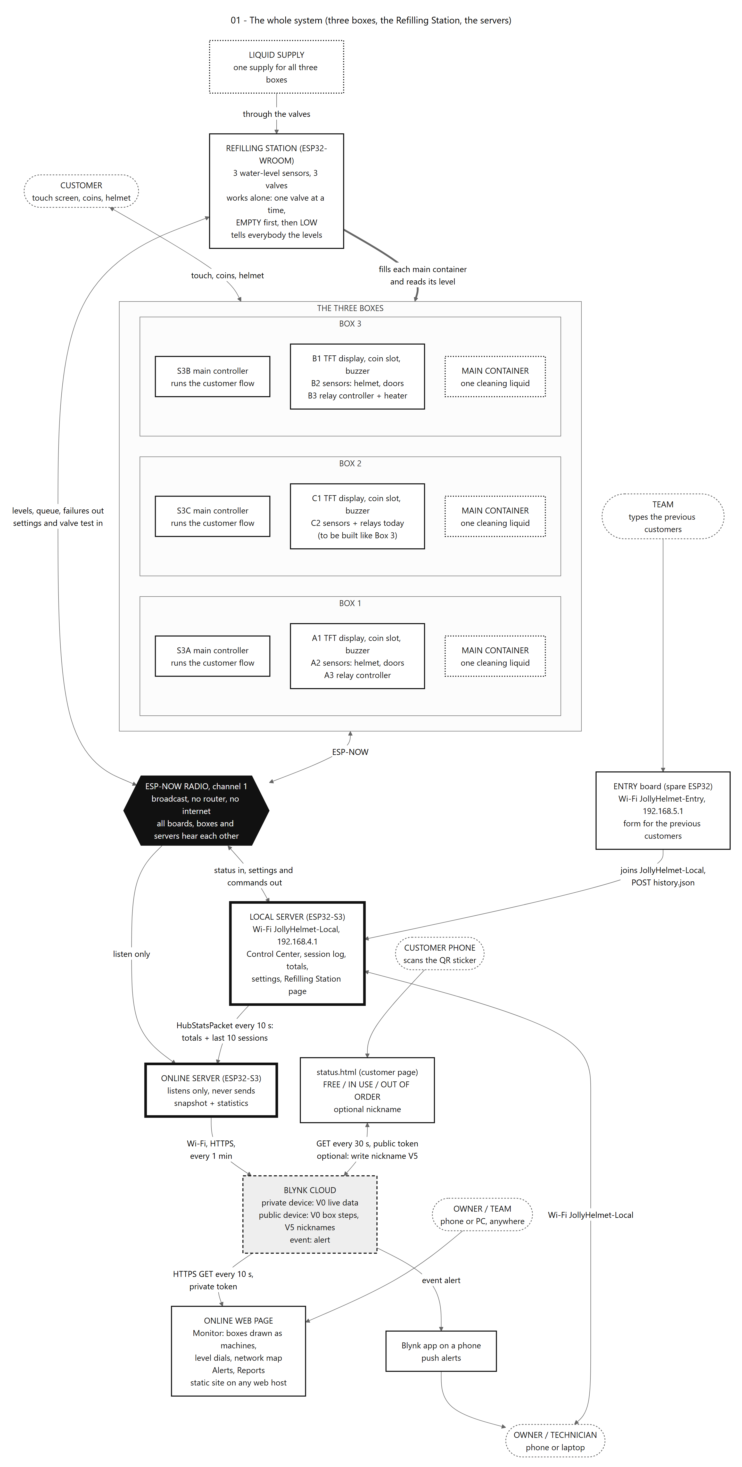
ESP32 Project/FLOWCHART_SYSTEM/png/01_system.png
