Mejez6603/Jolly-Helmet/ESP32 Project/FLOWCHART_SYSTEM/png/02_customer_flow_part1.png

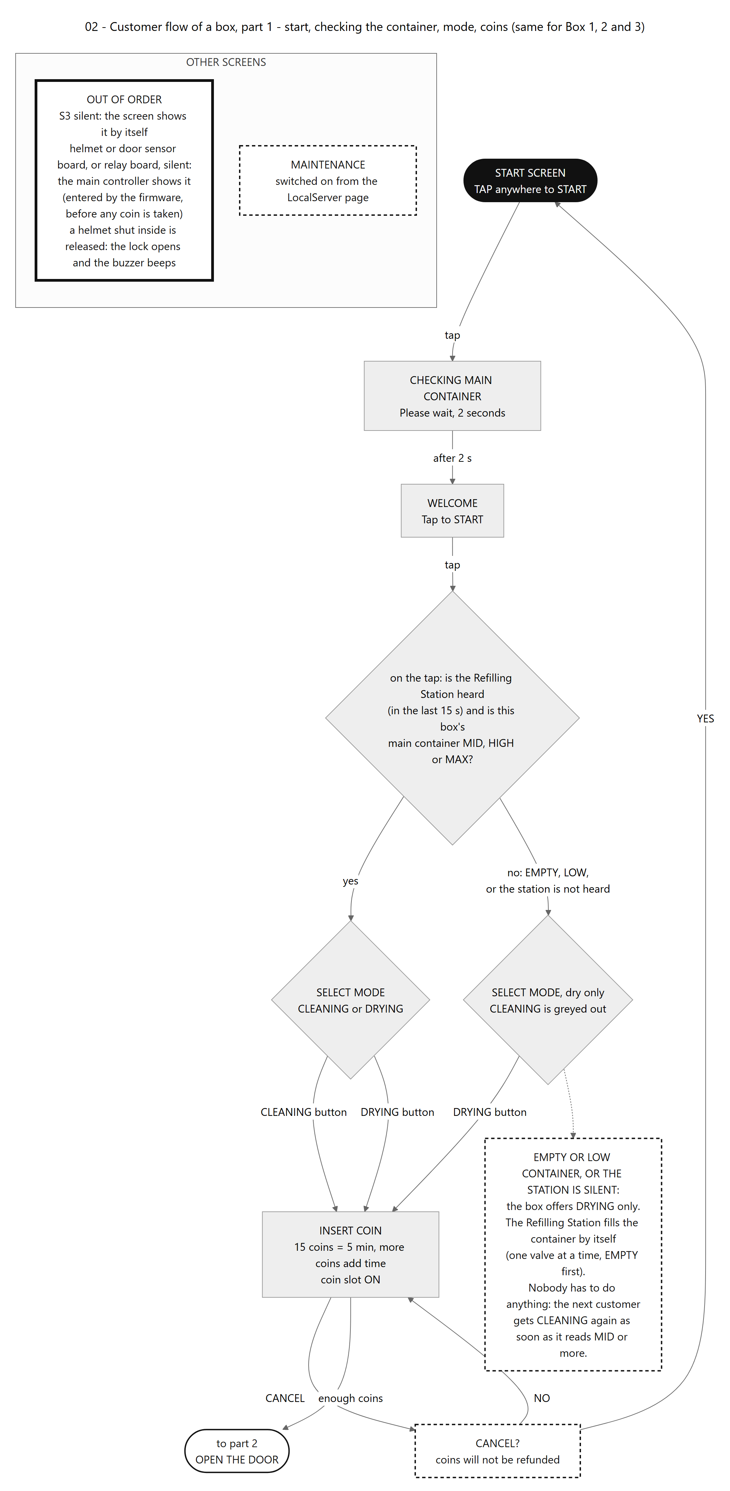
ESP32 Project/FLOWCHART_SYSTEM/png/02_customer_flow_part1.png
