Mejez6603/Jolly-Helmet/ESP32 Project/FLOWCHART_SYSTEM/png/03_customer_flow_part2.png

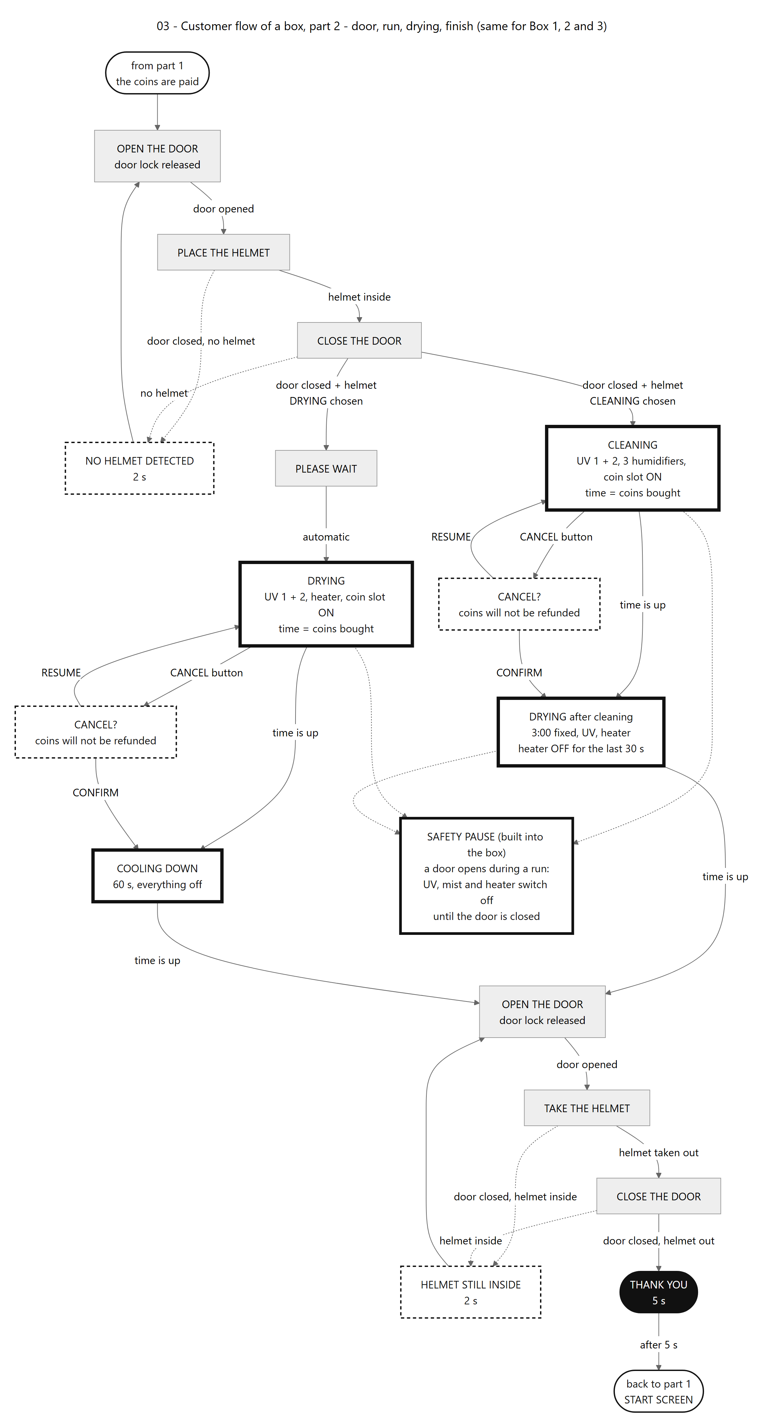
ESP32 Project/FLOWCHART_SYSTEM/png/03_customer_flow_part2.png
