Mejez6603/Jolly-Helmet/ESP32 Project/FLOWCHART_SYSTEM/png/04_inside_one_box.png

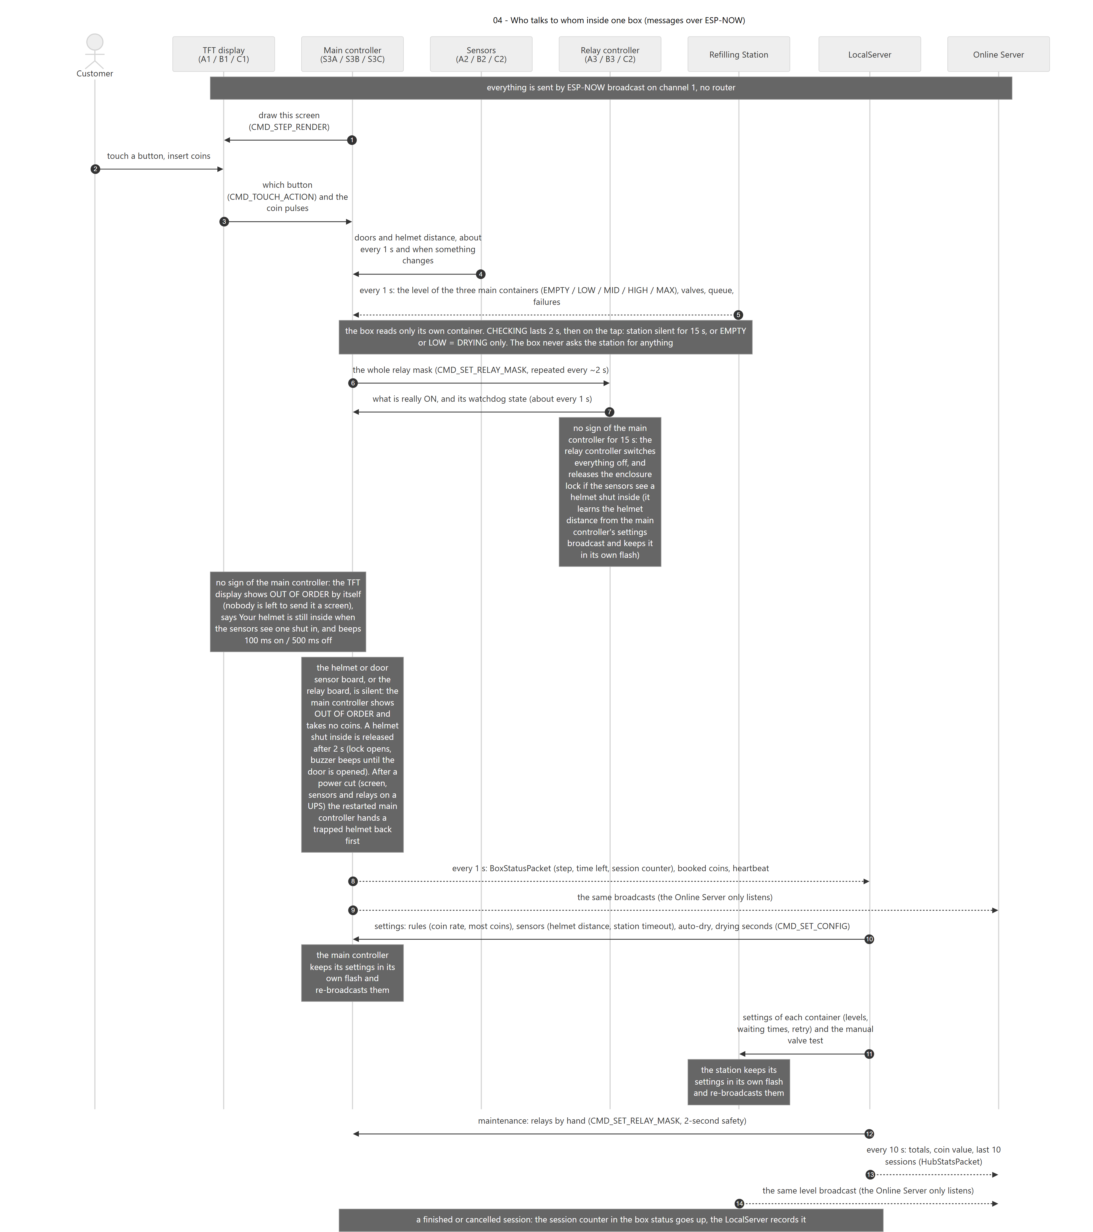
ESP32 Project/FLOWCHART_SYSTEM/png/04_inside_one_box.png
