Mejez6603/Jolly-Helmet/ESP32 Project/FLOWCHART_SYSTEM/png/05_refilling_station.png

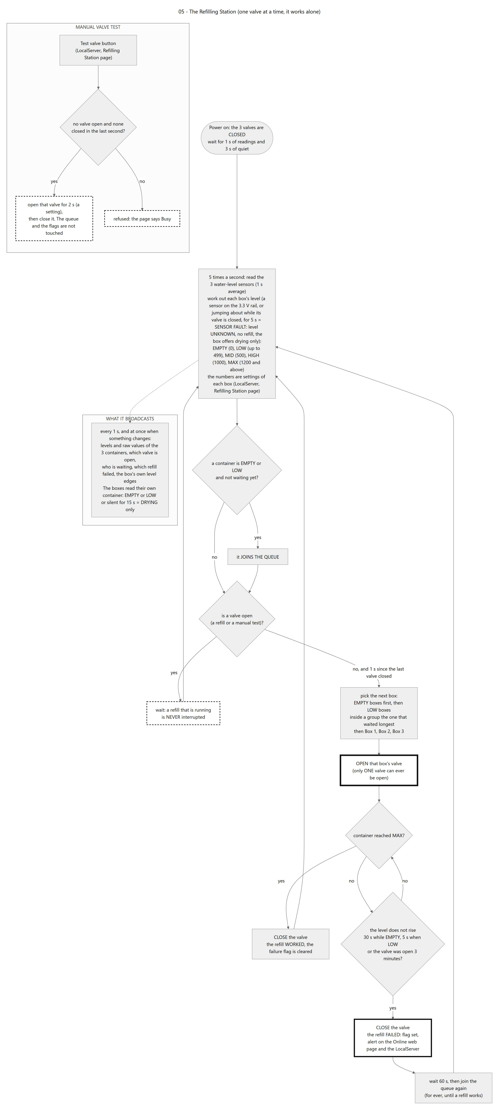
ESP32 Project/FLOWCHART_SYSTEM/png/05_refilling_station.png
