Mejez6603/Jolly-Helmet/ESP32 Project/FLOWCHART_SYSTEM/png/06_localserver.png

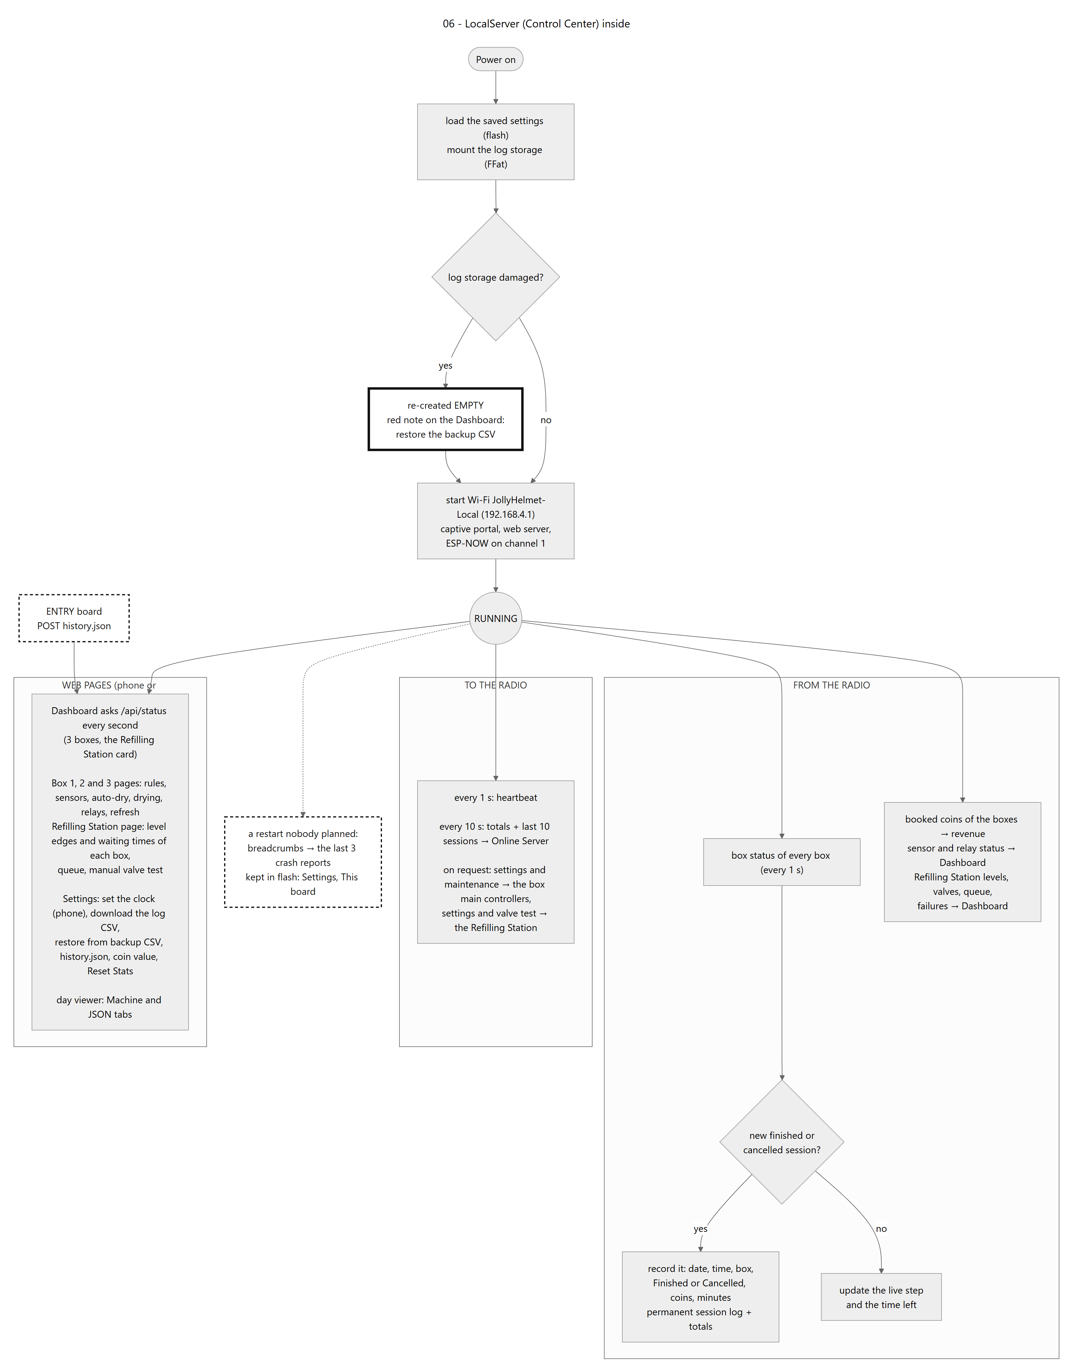
ESP32 Project/FLOWCHART_SYSTEM/png/06_localserver.png
