Mejez6603/Jolly-Helmet/ESP32 Project/FLOWCHART_SYSTEM/png/07_online_server.png

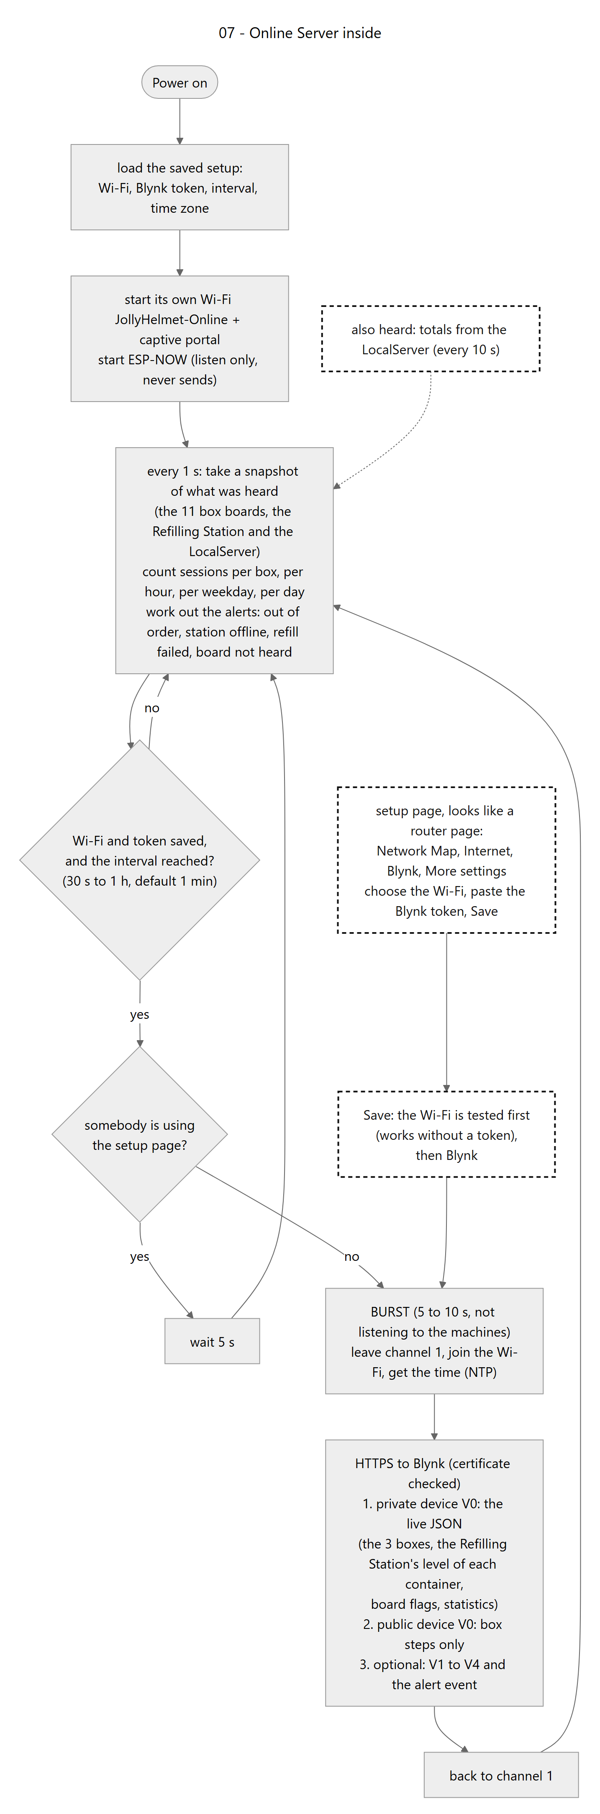
ESP32 Project/FLOWCHART_SYSTEM/png/07_online_server.png
