Mejez6603/Jolly-Helmet/ESP32 Project/FLOWCHART_SYSTEM/png/08_blynk_and_web.png

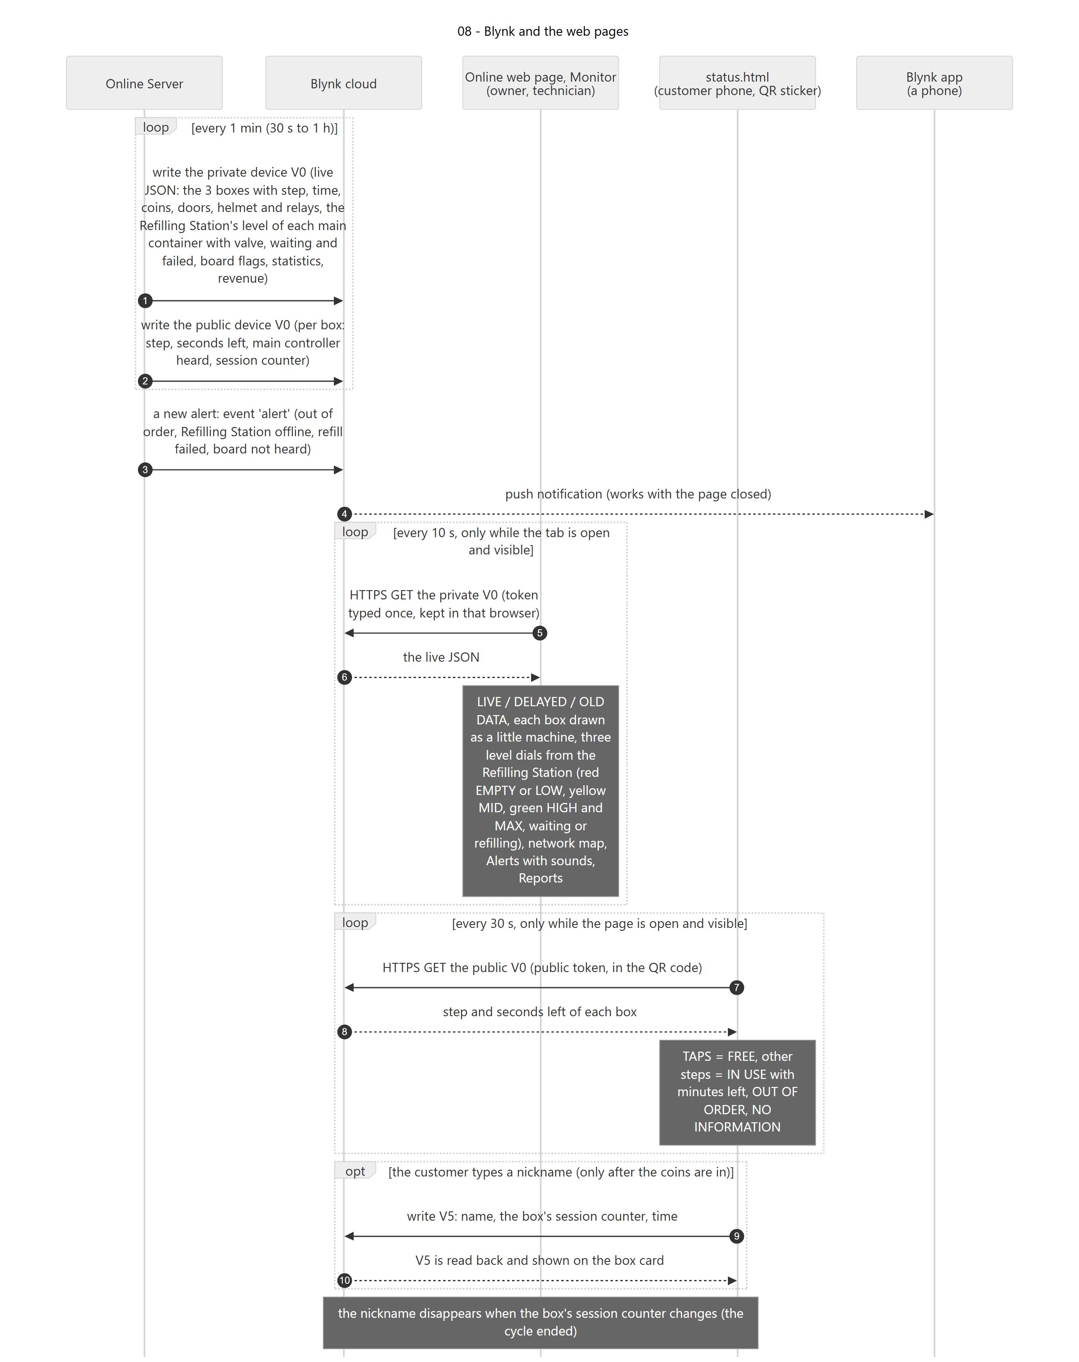
ESP32 Project/FLOWCHART_SYSTEM/png/08_blynk_and_web.png
