Mejez6603/Jolly-Helmet/ESP32 Project/FLOWCHART_SYSTEM/png/10_website_monitor.png

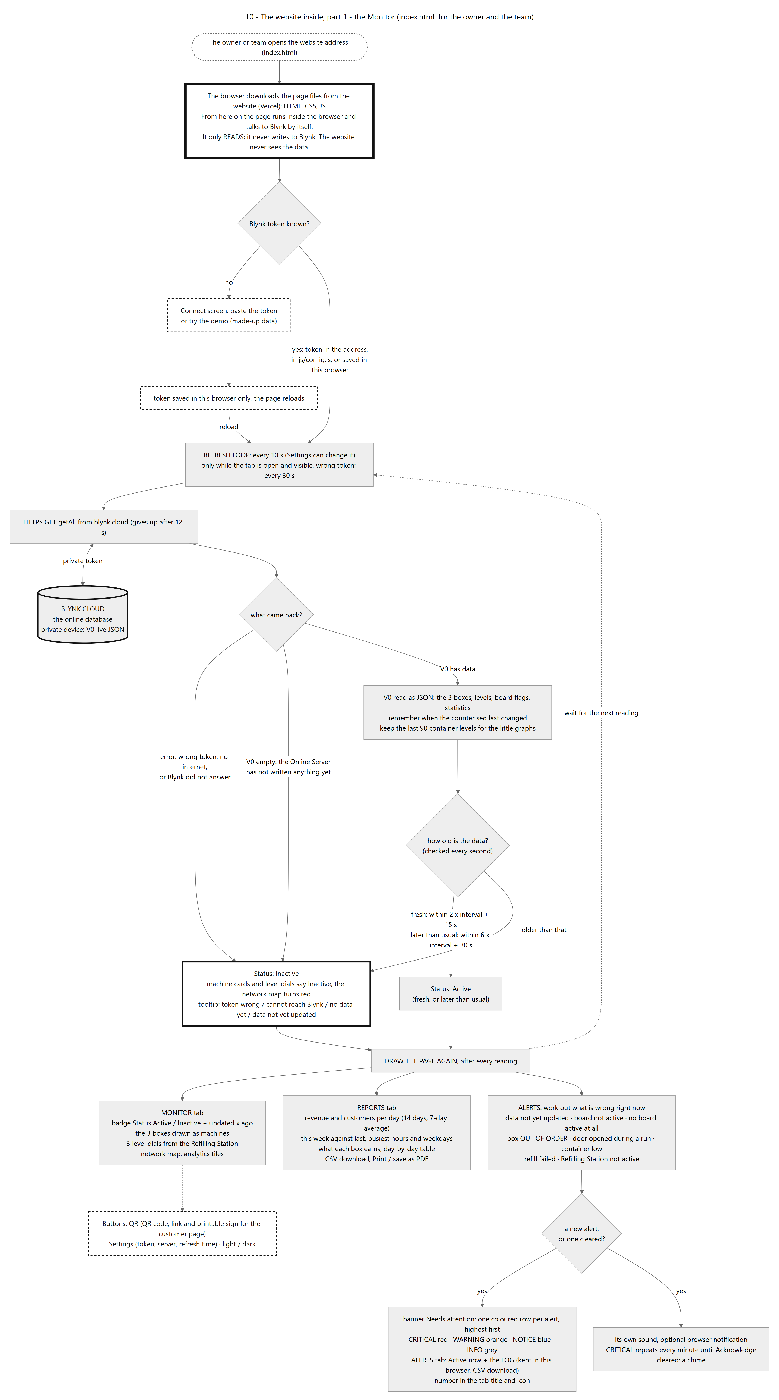
ESP32 Project/FLOWCHART_SYSTEM/png/10_website_monitor.png
