Mejez6603/Jolly-Helmet/ESP32 Project/FLOWCHART_SYSTEM/png/11_website_customer.png

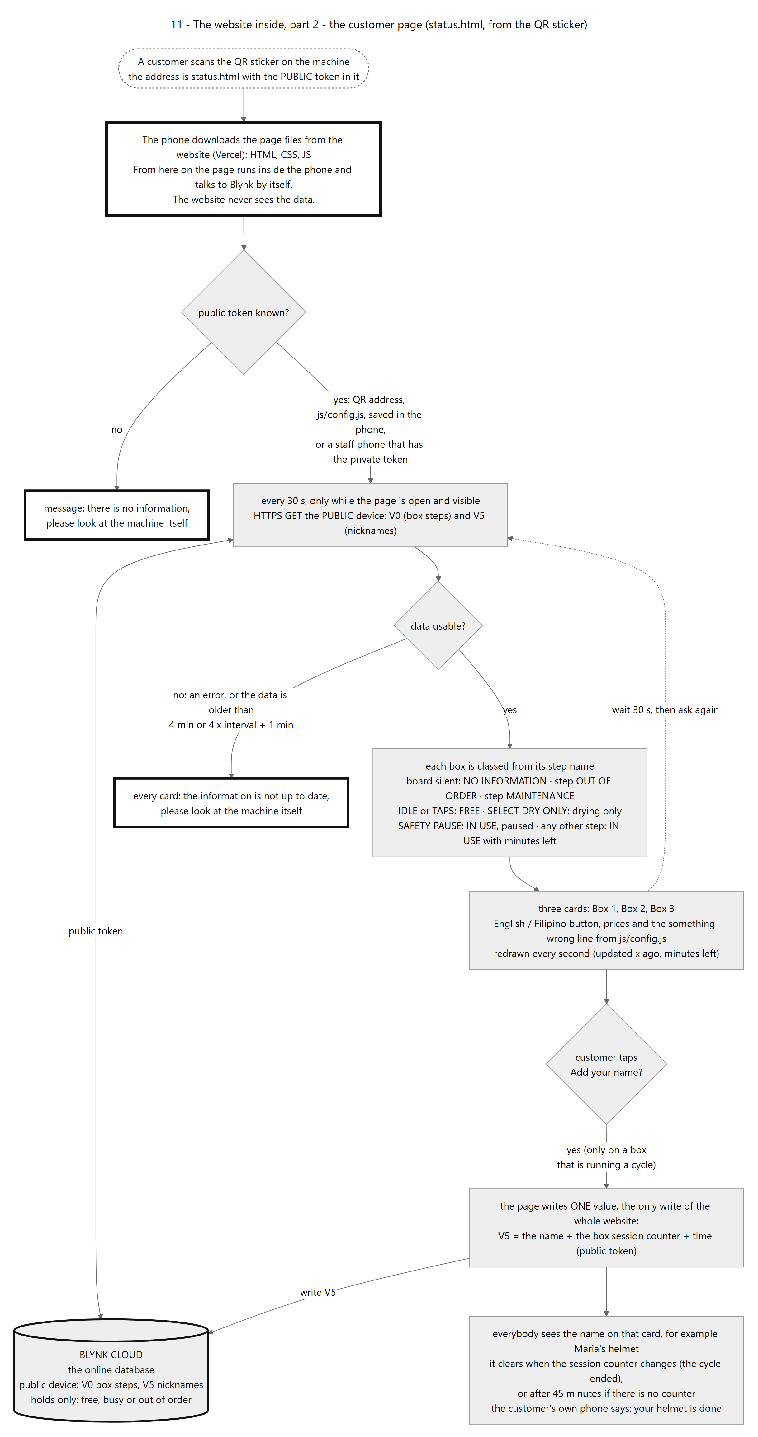
ESP32 Project/FLOWCHART_SYSTEM/png/11_website_customer.png
