Mejez6603/Jolly-Helmet/ESP32 Project/FLOWCHART_SYSTEM/REFILLING_STATION_CHART/Refilling_Station_Chart.png

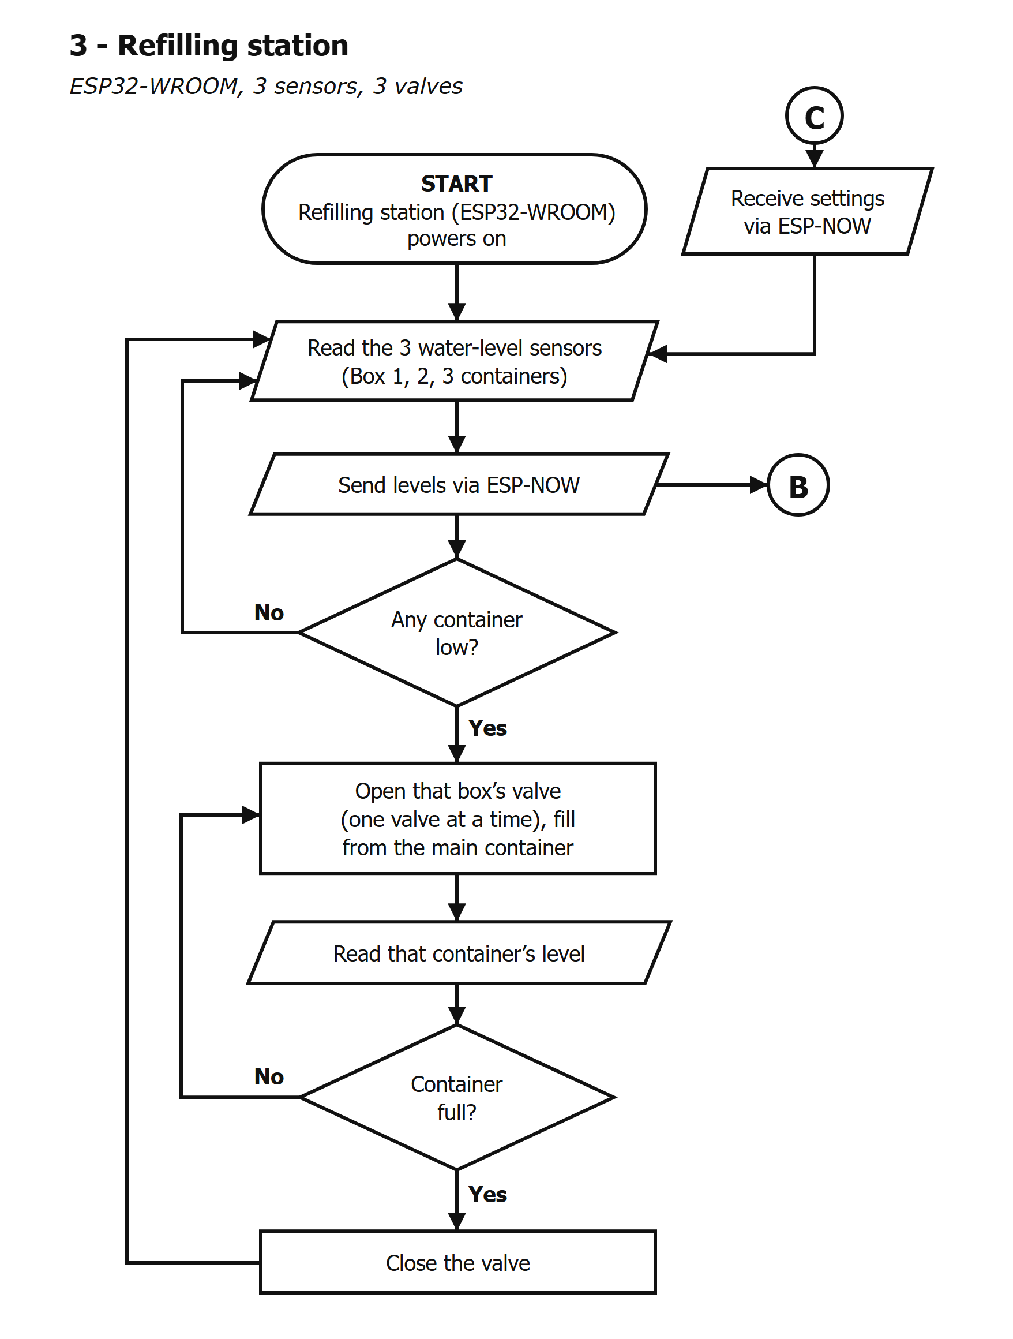
ESP32 Project/FLOWCHART_SYSTEM/REFILLING_STATION_CHART/Refilling_Station_Chart.png
