Mejez6603/Jolly-Helmet/ESP32 Project/FullProgression.png

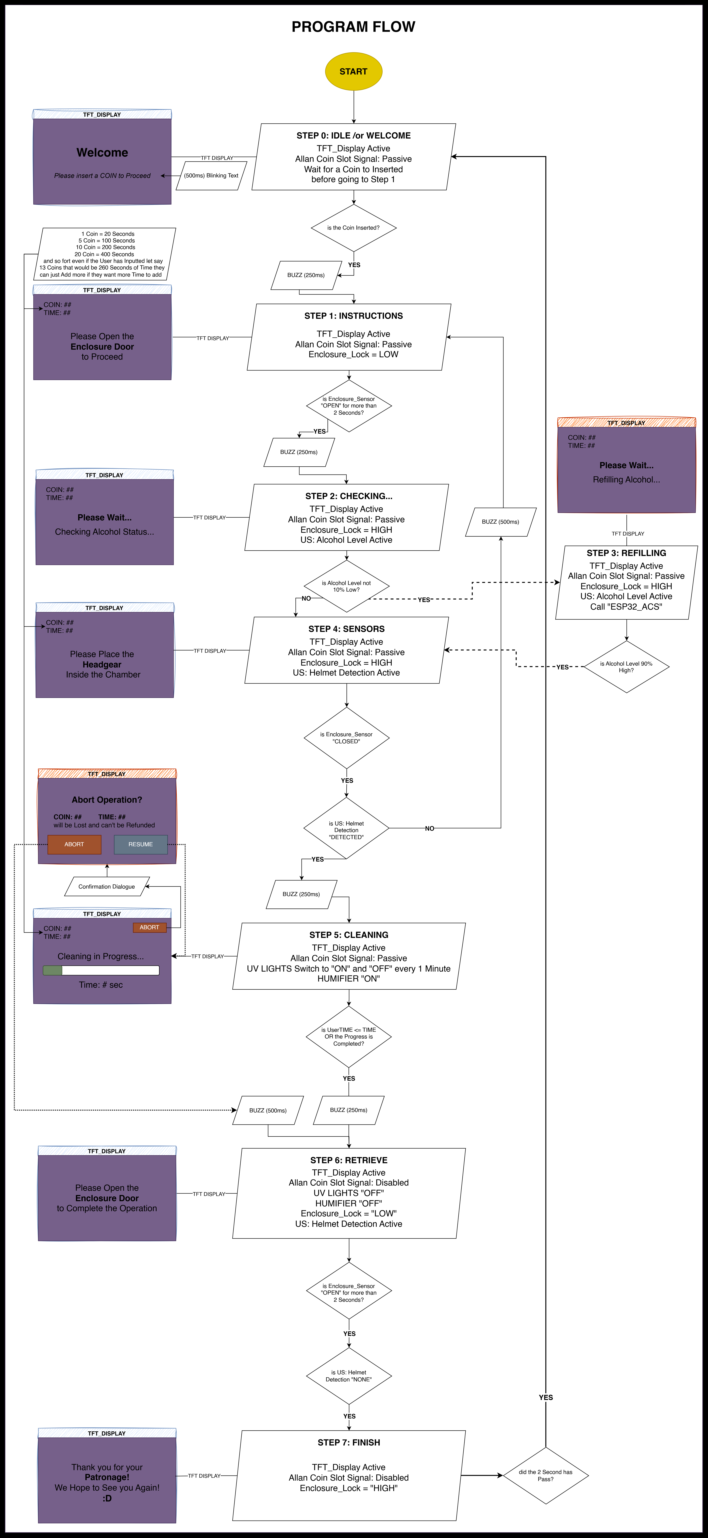
ESP32 Project/FullProgression.png
