Mejez6603/Jolly-Helmet/ESP32 Project/MANUAL/images/v11/web_reports.png

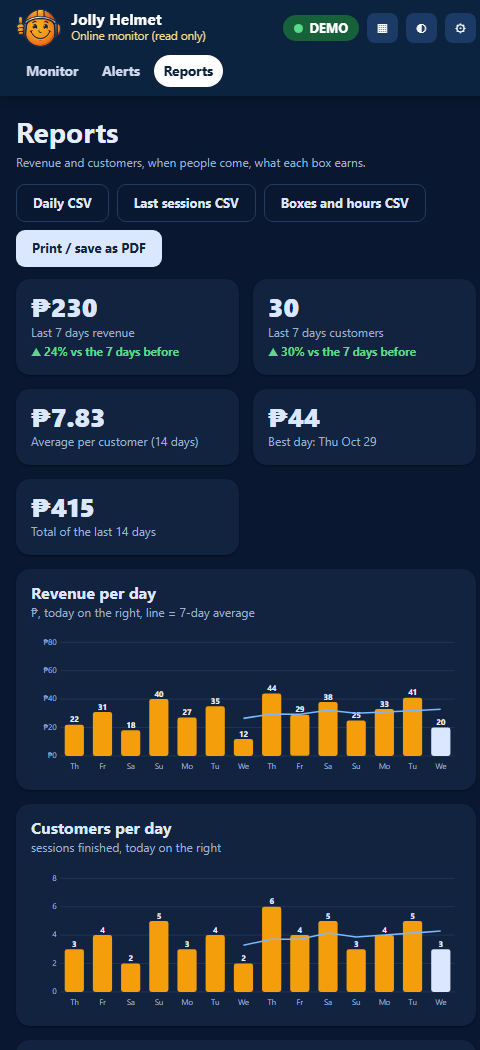
ESP32 Project/MANUAL/images/v11/web_reports.png
