Mejez6603/Jolly-Helmet/ESP32 Project/MANUAL/images/web/web_reports_c.png

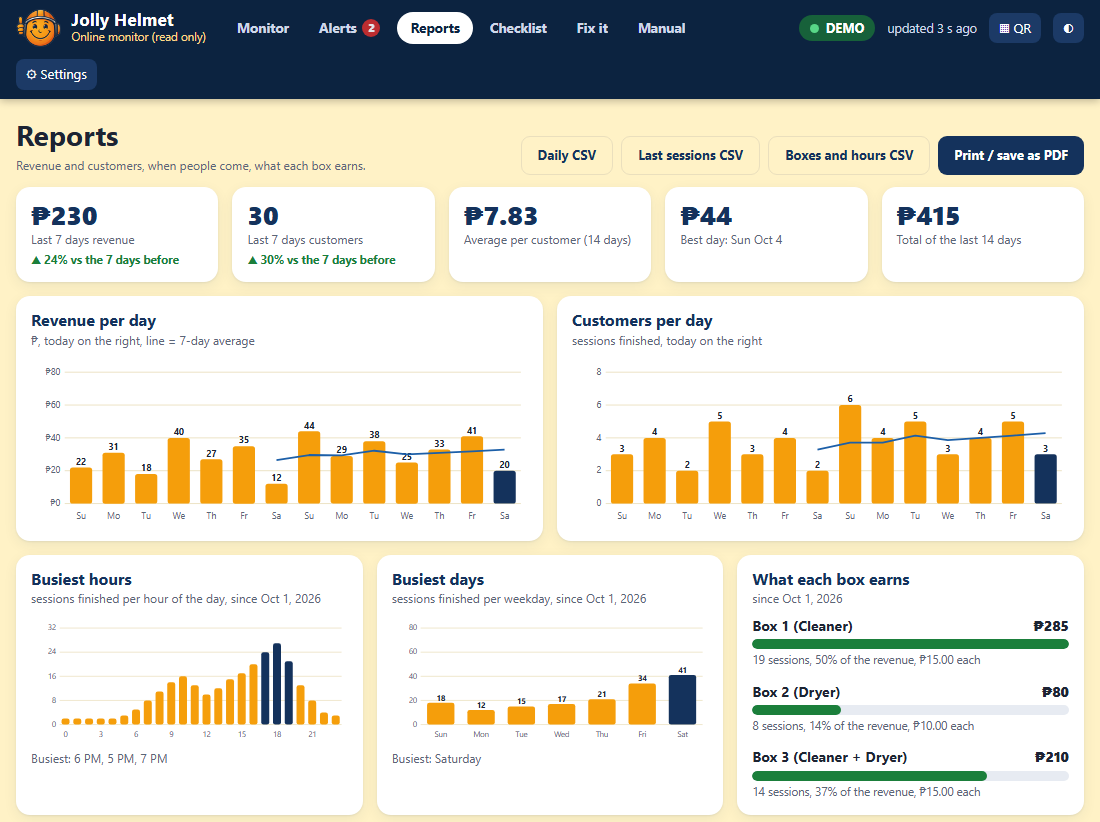
ESP32 Project/MANUAL/images/web/web_reports_c.png
