Mejez6603/Jolly-Helmet/ESP32 Project/OverAllFlowHelmet.jpg

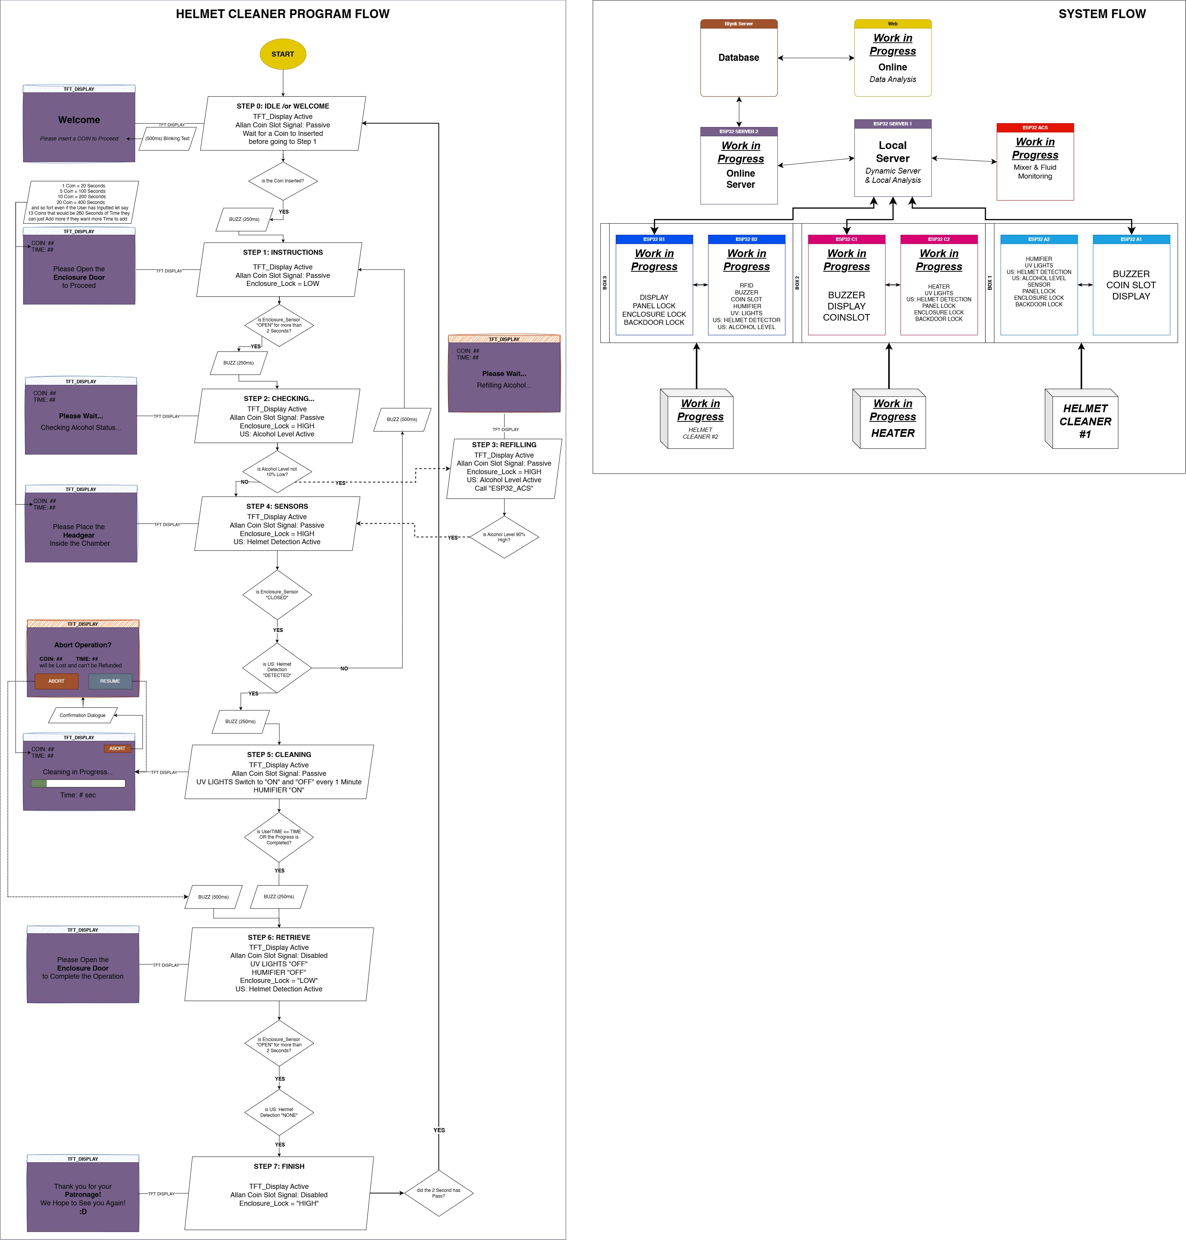
ESP32 Project/OverAllFlowHelmet.jpg
