Mejez6603/Jolly-Helmet/ESP32 Project/Untitled.png324234324.png

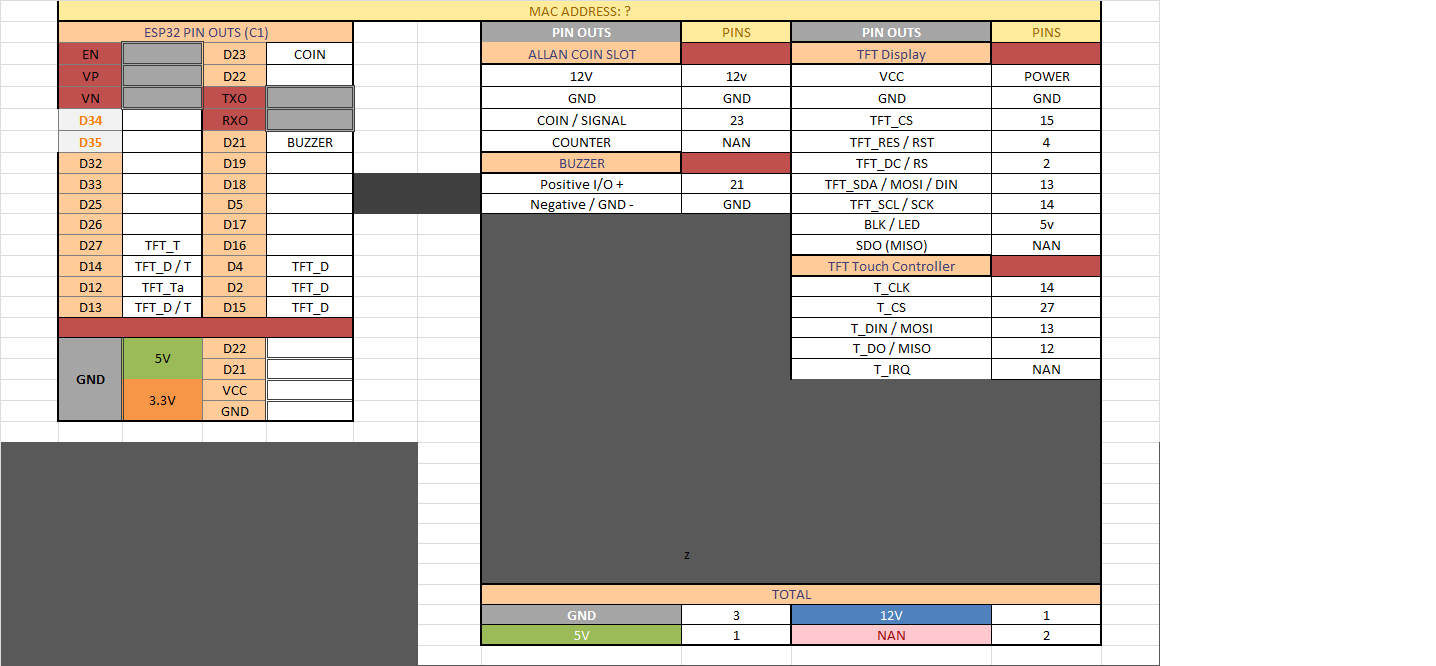
ESP32 Project/Untitled.png324234324.png
