Mejez6603/Jolly-Helmet/ESP32 Project/RevisedJollyHelmet_Checked.xlsx

Sheet: Sheet1
MAC ADDRESS: ? |  |  |  |  |  |  |  | MAC ADDRESS: ? |  |  |  |  |  |  |  | MAC ADDRESS: ?
ESP32 PIN OUTS (A1) |  |  |  | PIN OUTS | PINS | PIN OUTS | PINS | ESP32 PIN OUTS (A2) |  |  |  | PIN OUTS | PINS | PIN OUTS | PINS | ESP32 PIN OUTS (A3) |  |  |  | PIN OUTS | PINS | PIN OUTS | PINS
EN |  | D23 | COIN | ALLAN COIN SLOT |  | TFT Display |  | EN |  | D23 | US: MC SLS | US: Helmet Sensor |  | Sensor |  | EN |  | D23 | ACS DOOR | RELAYS
VP |  | D22 |  | 12V | 12v | VCC | POWER | VP |  | D22 | US: MC SLS | ECHO | 25 | Enclosure Sensor | 27 | VP |  | D22 | COIN_PWR | ACS Side Door | 23
VN |  | TXO |  | GND | GND | GND | GND | VN |  | TXO |  | TRIGGER | 26 | Panel Sensor | 14 | VN |  | TXO |  | COIN_PWR | 22
D34 |  | RXO |  | COIN / SIGNAL | 23 | TFT_CS | 15 | D34 | WS: ALS | RXO |  | US: MC ALS |  | Backdoor Sensor | 19 | D34 |  | RXO |  | UV 1 | 27
D35 |  | D21 | BUZZER | COUNTER | NAN | TFT_RES / RST | 4 | D35 | WS: SLS | D21 |  | ECHO | 33 | ACS Sensor | 18 | D35 |  | D21 | UV 2 | UV 2 | 21
D32 |  | D19 |  | BUZZER |  | TFT_DC / RS | 2 | D32 | US: MC ALS | D19 | B_Sensor | TRIGGER | 32 |  |  | D32 | PUMP 2 | D19 | HUMID 2 | DRAIN PUMP 1 ( ALCOHOL) | 33
D33 |  | D18 |  | Positive I/O + | 21 | TFT_SDA / MOSI / DIN | 13 | D33 | US: MC ALS | D18 | ACS_Sen | US: MC SLS |  |  |  | D33 | PUMP 1 | D18 | HUMID 1 | DRAIN PUMP 2 ( SCENTED) | 32
D25 |  | D5 |  | Negative / GND - | GND | TFT_SCL / SCK | 14 | D25 | US: HELMET | D5 |  | ECHO | 22 |  |  | D25 | HUMID 3 | D5 |  | HUMIDIFIER 1 (ALCOHOL) | 18
D26 |  | D17 |  |  |  | BLK / LED | 5v | D26 | US: HELMET | D17 |  | TRIGGER | 23 |  |  | D26 |  | D17 | B_LOCK | HUMIDIFIER 2 (SCENTED) | 19
D27 | TFT_T | D16 |  |  |  | SDO (MISO) | NAN | D27 | E_Sensor | D16 |  | WS: ALS |  |  |  | D27 | UV 1 | D16 | P_LOCK | HUMIDIFIER 3 (BOTH) | 25
D14 | TFT_D / T | D4 | TFT_D |  |  | TFT Touch Controller |  | D14 | P_Sensor | D4 |  | SIGNAL | 34 |  |  | D14 |  | D4 | E_LOCK | ENCLOSURE LOCK | 4
D12 | TFT_Ta | D2 | TFT_D |  |  | T_CLK | 14 | D12 |  | D2 |  | WS: SLS |  |  |  | D12 |  | D2 |  | PANEL LOCK | 16
D13 | TFT_D / T | D15 | TFT_D |  |  | T_CS | 27 | D13 |  | D15 |  | SIGNAL | 35 |  |  | D13 |  | D15 |  | BACKDOOR LOCK | 17
 |  |  |  |  |  | T_DIN / MOSI | 13
GND | 5V | D22 |  |  |  | T_DO / MISO | 12 | GND | 5V | D22 |  |  |  |  |  | GND | 5V | D22
 |  | D21 |  |  |  | T_IRQ | NAN |  |  | D21 |  |  |  |  |  |  |  | D21
 | 3.3V | VCC |  |  |  |  |  |  | 3.3V | VCC |  |  |  |  |  |  | 3.3V | VCC
 |  | GND |  |  |  |  |  |  |  | GND |  |  |  |  |  |  |  | GND
 |  |  |  | TOTAL |  |  |  |  |  |  |  | TOTAL |  |  |  |  |  |  |  | TOTAL
 |  |  |  | GND | 3 | 12V | 1 |  |  |  |  | GND | 4 | 12V | 0 |  |  |  |  | GND | 0 | 12V | 7
 |  |  |  | 5V | 1 | NAN | 3 |  |  |  |  | 5V | 6 | NAN | 0 |  |  |  |  | 5V | 5 | NAN | 0
MAC ADDRESS: ? |  |  |  |  |  |  |  | MAC ADDRESS: ?
ESP32 PIN OUTS (D1) |  |  |  | PIN OUTS | PINS | PIN OUTS | PINS | ESP32 PIN OUTS (D2) |  |  |  | PIN OUTS | PINS | PIN OUTS | PINS
EN |  | D23 |  | RELAYS |  | SENSORS |  | EN |  | D23 |  | RELAYS |  | SENSORS
VP |  | D22 |  |  |  |  |  | VP |  | D22
VN |  | TXO |  |  |  |  |  | VN |  | TXO
D34 |  | RXO |  |  |  |  |  | D34 |  | RXO
D35 |  | D21 |  |  |  |  |  | D35 |  | D21
D32 |  | D19 |  |  |  |  |  | D32 |  | D19
D33 |  | D18 |  |  |  |  |  | D33 |  | D18
D25 |  | D5 |  |  |  |  |  | D25 |  | D5
D26 |  | D17 |  |  |  |  |  | D26 |  | D17
D27 |  | D16 |  |  |  |  |  | D27 |  | D16
D14 |  | D4 |  |  |  |  |  | D14 |  | D4
D12 |  | D2 |  |  |  |  |  | D12 |  | D2
D13 |  | D15 |  |  |  |  |  | D13 |  | D15
GND | 5V | D22 |  |  |  |  |  | GND | 5V | D22
 |  | D21 |  |  |  |  |  |  |  | D21
 | 3.3V | VCC |  |  |  |  |  |  | 3.3V | VCC
 |  | GND |  |  |  |  |  |  |  | GND
 |  |  |  | TOTAL |  |  |  |  |  |  |  | TOTAL
 |  |  |  | GND | 4 | 12V | 0 |  |  |  |  | GND | 0 | 12V | 0
 |  |  |  | 5V | 4 | NAN | 0 |  |  |  |  | 5V | 0 | NAN | 0
MAC ADDRESS: ? |  |  |  |  |  |  |  | MAC ADDRESS: ?
ESP32 PIN OUTS (C1) |  |  |  | PIN OUTS | PINS | PIN OUTS | PINS | ESP32 PIN OUTS (C2) |  |  |  | PIN OUTS | PINS | PIN OUTS | PINS
EN |  | D23 |  | ALLAN COIN SLOT |  | TFT Display |  | EN |  | D23 | FAN | US: Helmet Sensor |  | Magnetic Door Sensor
VP |  | D22 |  | 12V | 12v | VCC | POWER | VP |  | D22 |  | ECHO | 25 | Enclosure Sensor | 27
VN |  | TXO |  | GND | GND | GND | GND | VN |  | TXO |  | TRIGGER | 26 | Panel Sensor | 14
D34 |  | RXO |  | COIN / SIGNAL | 23 | TFT_CS | 15 | D34 |  | RXO |  | VCC 5V | 5v | Backdoor Sensor | 19
D35 |  | D21 | BUZZER | COUNTER | NAN | TFT_RES / RST | 4 | D35 |  | D21 |  | GND | GND | 12V Solenoid Locks
D32 | COIN | D19 |  | BUZZER |  | TFT_DC / RS | 2 | D32 |  | D19 | B_Sensor | UV Strip Light (RELAY) |  | Enclosure Lock Signal | 4
D33 |  | D18 |  | Positive I/O + | 21 | TFT_SDA / MOSI / DIN | 13 | D33 |  | D18 | HEATER | SIGNAL | 5 | Panel Lock Signal | 16
D25 |  | D5 |  | Negative / GND - | GND | TFT_SCL / SCK | 14 | D25 | US: HELMET | D5 | UV Lights | VCC 12v | 12v | Backdoor Lock Signal | 17
D26 |  | D17 |  |  |  | BLK / LED | 5v | D26 | US: HELMET | D17 | B_Lock | GND | GND
D27 | TFT_T | D16 |  |  |  | SDO (MISO) | NAN | D27 | E_Sensor | D16 | P_Lock | HEATER (RELAY)
D14 | TFT_D / T | D4 | TFT_D |  |  | TFT Touch Controller |  | D14 | P_Sensor | D4 | E_Lock | SIGNAL | 18
D12 | TFT_Ta | D2 | TFT_D |  |  | T_CLK | 14 | D12 |  | D2 |  | FAN
D13 | TFT_D / T | D15 | TFT_D |  |  | T_CS | 27 | D13 |  | D15 |  | SIGNAL | 23
 |  |  |  |  |  | T_DIN / MOSI | 13
GND | 5V | D22 |  |  |  | T_DO / MISO | 12 | GND | 5V | D22
 |  | D21 |  |  |  | T_IRQ | NAN |  |  | D21
 | 3.3V | VCC |  |  |  |  |  |  | 3.3V | VCC
 |  | GND |  |  |  |  |  |  |  | GND
 |  |  |  | TOTAL |  |  |  |  |  |  |  | TOTAL
 |  |  |  | GND | 3 | 12V | 1 |  |  |  |  | GND | 4 | 12V | 1
 |  |  |  | 5V | 1 | NAN | 3 |  |  |  |  | 5V | 4 | NAN | 0
MAC ADDRESS: ? |  |  |  |  |  |  |  | MAC ADDRESS: ? |  |  |  |  |  |  |  | MAC ADDRESS: ?
ESP32 PIN OUTS (B1) |  |  |  | PIN OUTS | PINS | PIN OUTS | PINS | ESP32 PIN OUTS (B2) |  |  |  | PIN OUTS | PINS | PIN OUTS | PINS | ESP32 PIN OUTS (B3) |  |  |  | PIN OUTS | PINS | PIN OUTS | PINS
EN |  | D23 | COIN | ALLAN COIN SLOT |  | TFT Display |  | EN |  | D23 | US: MC SLS | US: Helmet Sensor |  | Sensor |  | EN |  | D23 | ACS DOOR | RELAYS
VP |  | D22 |  | 12V | 12v | VCC | POWER | VP |  | D22 | US: MC SLS | ECHO | 25 | Enclosure Sensor | 27 | VP |  | D22 | COIN_PWR | ACS Side Door | 23
VN |  | TXO |  | GND | GND | GND | GND | VN |  | TXO |  | TRIGGER | 26 | Panel Sensor | 14 | VN |  | TXO |  | COIN_PWR | 22
D34 |  | RXO |  | COIN / SIGNAL | 23 | TFT_CS | 15 | D34 | WS: ALS | RXO |  | US: MC ALS |  | Backdoor Sensor | 19 | D34 |  | RXO |  | UV 1 | 27
D35 |  | D21 | BUZZER | COUNTER | NAN | TFT_RES / RST | 4 | D35 | WS: SLS | D21 |  | ECHO | 33 | ACS Sensor | 18 | D35 |  | D21 | UV 2 | UV 2 | 21
D32 |  | D19 |  | BUZZER |  | TFT_DC / RS | 2 | D32 | US: MC ALS | D19 | B_Sensor | TRIGGER | 32 |  |  | D32 | PUMP 2 | D19 | HUMID 2 | DRAIN PUMP 1 ( ALCOHOL) | 33
D33 |  | D18 |  | Positive I/O + | 21 | TFT_SDA / MOSI / DIN | 13 | D33 | US: MC ALS | D18 | ACS_Sen | US: MC SLS |  |  |  | D33 | PUMP 1 | D18 | HUMID 1 | DRAIN PUMP 2 ( SCENTED) | 32
D25 |  | D5 |  | Negative / GND - | GND | TFT_SCL / SCK | 14 | D25 | US: HELMET | D5 |  | ECHO | 22 |  |  | D25 | HUMID 3 | D5 |  | HUMIDIFIER 1 (ALCOHOL) | 18
D26 |  | D17 |  |  |  | BLK / LED | 5v | D26 | US: HELMET | D17 |  | TRIGGER | 23 |  |  | D26 | HEATER | D17 | B_LOCK | HUMIDIFIER 2 (SCENTED) | 19
D27 | TFT_T | D16 |  |  |  | SDO (MISO) | NAN | D27 | E_Sensor | D16 |  | WS: ALS |  |  |  | D27 | UV 1 | D16 | P_LOCK | HUMIDIFIER 3 (BOTH) | 25
D14 | TFT_D / T | D4 | TFT_D |  |  | TFT Touch Controller |  | D14 | P_Sensor | D4 |  | SIGNAL | 34 |  |  | D14 |  | D4 | E_LOCK | ENCLOSURE LOCK | 4
D12 | TFT_Ta | D2 | TFT_D |  |  | T_CLK | 14 | D12 |  | D2 |  | WS: SLS |  |  |  | D12 |  | D2 |  | PANEL LOCK | 16
D13 | TFT_D / T | D15 | TFT_D |  |  | T_CS | 27 | D13 |  | D15 |  | SIGNAL | 35 |  |  | D13 |  | D15 |  | BACKDOOR LOCK | 17
 |  |  |  |  |  | T_DIN / MOSI | 13 |  |  |  |  |  |  |  |  |  |  |  |  | HEATER | 26
GND | 5V | D22 |  |  |  | T_DO / MISO | 12 | GND | 5V | D22 |  |  |  |  |  | GND | 5V | D22
 |  | D21 |  |  |  | T_IRQ | NAN |  |  | D21 |  |  |  |  |  |  |  | D21
 | 3.3V | VCC |  |  |  |  |  |  | 3.3V | VCC |  |  |  |  |  |  | 3.3V | VCC
 |  | GND |  |  |  |  |  |  |  | GND |  |  |  |  |  |  |  | GND
 |  |  |  | TOTAL |  |  |  |  |  |  |  | TOTAL |  |  |  |  |  |  |  | TOTAL
 |  |  |  | GND | 3 | 12V | 1 |  |  |  |  | GND | 4 | 12V | 0 |  |  |  |  | GND | 0 | 12V+ | 8
 |  |  |  | 5V | 1 | NAN | 3 |  |  |  |  | 5V | 6 | NAN | 0 |  |  |  |  | 5V | 5 | NAN | 0
MAC ADDRESS: ? |  |  |  |  |  |  |  | MAC ADDRESS: ?
ESP32 PIN OUTS (E1) |  |  |  | PIN OUTS | PINS | PIN OUTS | PINS | ESP32 PIN OUTS (E2) |  |  |  | PIN OUTS | PINS | PIN OUTS | PINS
EN |  | D23 | WATER P SCN | RELAYS |  | US: MIXER ALCOHOL |  | EN |  | D23
VP |  | D22 | MIX ALC PUMP | ALCOHOL PUMP | 18 | ECHO | 14 | VP |  | D22
VN |  | TXO |  | WATER PUMP ALC | 21 | TRIGGER | 4 | VN |  | TXO
D34 | WL MIX ALC | RXO |  | WATER PUMP SCN | 23 | US: MIXER SCENTED |  | D34 |  | RXO
D35 | WL MIX SCN | D21 | WATER P ALC | SCENTED PUMP | 19 | ECHO | 33 | D35 |  | D21
D32 |  | D19 | SCENTED P | MIXER ALCOHOL PUMP | 22 | TRIGGER | 26 | D32 |  | D19
D33 | MIX SCN ECHO | D18 | ALCOHOL P | MIXER SCENTED PUMP | 25 | WL: MIXER ALCOHOL |  | D33 |  | D18
D25 | MIX SCN PUMP | D5 |  |  |  | SIGNAL | 34 | D25 |  | D5
D26 | MIX SCN TRIG | D17 |  |  |  | WL: MIXER SCENTED |  | D26 |  | D17
D27 |  | D16 |  |  |  | SIGNAL | 35 | D27 |  | D16
D14 | MIX ALC ECHO | D4 | MIX ALC TRIG |  |  |  |  | D14 |  | D4
D12 |  | D2 |  |  |  |  |  | D12 |  | D2
D13 |  | D15 |  |  |  |  |  | D13 |  | D15
GND | 5V | D22 |  |  |  |  |  | GND | 5V | D22
 |  | D21 |  |  |  |  |  |  |  | D21
 | 3.3V | VCC |  |  |  |  |  |  | 3.3V | VCC
 |  | GND |  |  |  |  |  |  |  | GND
 |  |  |  | TOTAL |  |  |  |  |  |  |  | TOTAL
 |  |  |  | GND | 4 | 12V | 0 |  |  |  |  | GND | 0 | 12V | 0
 |  |  |  | 5V | 4 | NAN | 0 |  |  |  |  | 5V | 0 | NAN | 0
MAC ADDRESS: ?
ESP32 PIN OUTS (F1 REFILLING STATION) |  |  |  | PIN OUTS | PINS | PIN OUTS | PINS
EN |  | D23 |  | RELAYS |  | WL: BOX 1 CONTAINER
VP |  | D22 |  | VALVE BOX 1 | 21 | SIGNAL | 34
VN |  | TXO |  | VALVE BOX 2 | 19 | WL: BOX 2 CONTAINER
D34 | WL BOX 1 | RXO |  | VALVE BOX 3 | 18 | SIGNAL | 35
D35 | WL BOX 2 | D21 | VALVE 1 |  |  | WL: BOX 3 CONTAINER
D32 | WL BOX 3 | D19 | VALVE 2 |  |  | SIGNAL | 32
D33 |  | D18 | VALVE 3
D25 |  | D5
D26 |  | D17
D27 |  | D16
D14 |  | D4
D12 |  | D2
D13 |  | D15
GND | 5V | D22
 |  | D21
 | 3.3V | VCC
 |  | GND
 |  |  |  | TOTAL
 |  |  |  | GND | 3 | 12V | ?
 |  |  |  | 5V | 0 | NAN | 0

Sheet: Change Log
Yellow cells on Sheet1 were added or changed in this copy. Cleared cells are not highlighted.
Cell | Board | Was | Now | Why
I27 | A1 | z | (cleared) | Stray "z" below the table, not part of any pin-out
I95 | C1 | z | (cleared) | Stray "z" below the table, not part of any pin-out
I129 | B1 | z | (cleared) | Stray "z" below the table, not part of any pin-out
AF123 | B3 | 0 | (cleared) | Stray "0" inside the B3 print area
K31 | A1 | 2 | 3 | NAN total: 3 unconnected entries are listed (COUNTER, SDO/MISO, T_IRQ)
K99 | C1 | 2 | 3 | NAN total: 3 unconnected entries are listed (COUNTER, SDO/MISO, T_IRQ)
K133 | B1 | 2 | 3 | NAN total: 3 unconnected entries are listed (COUNTER, SDO/MISO, T_IRQ)
W30 | A2 | 1 | 0 | 12V total: nothing on A2 uses 12V now (locks moved to A3)
W132 | B2 | 1 | 0 | 12V total: nothing on B2 uses 12V now (locks moved to B3)
AG6 | A3 | 5 | 27 | GPIO5 pulses at boot (can click the relay) - moved to GPIO27, free and boot-quiet
AG9 | A3 | 14 | 32 | GPIO14 pulses at boot (can click the relay) - moved to GPIO32, free and boot-quiet
AC10 | A3 | UV 1 | (cleared) | Diagram label for UV 1 removed from D5
AA13 | A3 | PUMP 2 | (cleared) | Diagram label for PUMP 2 removed from D14
AA12 | A3 |  | UV 1 | Diagram label for UV 1 on D27
AA8 | A3 |  | PUMP 2 | Diagram label for PUMP 2 on D32
AG108 | B3 | 5 | 27 | GPIO5 pulses at boot (can click the relay) - moved to GPIO27, free and boot-quiet
AG111 | B3 | 14 | 32 | GPIO14 pulses at boot (can click the relay) - moved to GPIO32, free and boot-quiet
AC112 | B3 | UV 1 | (cleared) | Diagram label for UV 1 removed from D5
AA115 | B3 | PUMP 2 | (cleared) | Diagram label for PUMP 2 removed from D14
AA114 | B3 |  | UV 1 | Diagram label for UV 1 on D27
AA110 | B3 |  | PUMP 2 | Diagram label for PUMP 2 on D32
I140 | E1 |  | 18 | ALCOHOL PUMP relay - same pin as the ACS firmware alcohol pump
I141 | E1 |  | 21 | WATER PUMP ALC relay - same pin as the ACS firmware water pump
I142 | E1 |  | 23 | WATER PUMP SCN relay - reuses the old side-lock pin
I143 | E1 |  | 19 | SCENTED PUMP relay - same pin as the ACS firmware scented pump
I144 | E1 |  | 22 | MIXER ALCOHOL PUMP relay - GPIO22 (free, boot-quiet); GPIO5 would pulse at boot
I145 | E1 |  | 25 | MIXER SCENTED PUMP relay - same pin as the ACS firmware mixing machine
K140 | E1 |  | 14 | US WATER ECHO - same as ACS firmware (an input, so the boot pulse on GPIO14 does not matter)
K141 | E1 |  | 4 | US WATER TRIGGER - same as ACS firmware
K143 | E1 |  | 33 | US SCENTED ECHO - same as ACS firmware
K144 | E1 |  | 26 | US SCENTED TRIGGER - same as ACS firmware
K146 | E1 |  | 34 | WL ALCOHOL SIGNAL - input-only ADC1 pin, safe while Wi-Fi/ESP-NOW is on
K148 | E1 |  | 35 | WL MIXER SIGNAL - input-only ADC1 pin, safe while Wi-Fi/ESP-NOW is on
E139 | E1 |  | WATER P SCN | Label for D23 - Water Pump SCN (re-added after the sensor rename)
E140 | E1 |  | MIX ALC PUMP | Label for D22 - Mixer Alcohol Pump (re-added after the sensor rename)
E143 | E1 |  | WATER P ALC | Label for D21 - Water Pump ALC (re-added after the sensor rename)
E144 | E1 |  | SCENTED P | Label for D19 - Scented Pump (re-added after the sensor rename)
E145 | E1 |  | ALCOHOL P | Label for D18 - Alcohol Pump (re-added after the sensor rename)
C146 | E1 |  | MIX SCN PUMP | Label for D25 - Mixer Scented Pump (re-added after the sensor rename)
E149 | E1 |  | MIX ALC TRIG | Label for D4 - US: Mixer Alcohol trigger (re-added after the sensor rename)
C149 | E1 |  | MIX ALC ECHO | Label for D14 - US: Mixer Alcohol echo (re-added after the sensor rename)
C147 | E1 |  | MIX SCN TRIG | Label for D26 - US: Mixer Scented trigger (re-added after the sensor rename)
C145 | E1 |  | MIX SCN ECHO | Label for D33 - US: Mixer Scented echo (re-added after the sensor rename)
C142 | E1 |  | WL MIX ALC | Label for D34 - WL: Mixer Alcohol signal (re-added after the sensor rename)
C143 | E1 |  | WL MIX SCN | Label for D35 - WL: Mixer Scented signal (re-added after the sensor rename)
O6 | A2 |  | WS: ALS | Label for D34 - analog water sensor, alcohol container (moved here from a pin with no ADC)
O7 | A2 |  | WS: SLS | Label for D35 - analog water sensor, scented container (moved here from a pin with no ADC)
Q10 | A2 | WS: ALS | (cleared) | Old label beside D5 - that GPIO has no ADC and the water sensor is analog
Q11 | A2 | WS: SLS | (cleared) | Old label beside D17 - that GPIO has no ADC and the water sensor is analog
U13 | A2 | 5 | 34 | WS: ALS signal -> GPIO34 (input-only ADC1 pin; ADC2 pins stop working while Wi-Fi/ESP-NOW is on). Power the sensor from 3.3 V.
U15 | A2 | 17 | 35 | WS: SLS signal -> GPIO35 (input-only ADC1 pin; ADC2 pins stop working while Wi-Fi/ESP-NOW is on). Power the sensor from 3.3 V.
O108 | B2 |  | WS: ALS | Label for D34 - analog water sensor, alcohol container (moved here from a pin with no ADC)
O109 | B2 |  | WS: SLS | Label for D35 - analog water sensor, scented container (moved here from a pin with no ADC)
Q112 | B2 | WS: ALS | (cleared) | Old label beside D5 - that GPIO has no ADC and the water sensor is analog
Q113 | B2 | WS: SLS | (cleared) | Old label beside D17 - that GPIO has no ADC and the water sensor is analog
U115 | B2 | 5 | 34 | WS: ALS signal -> GPIO34 (input-only ADC1 pin; ADC2 pins stop working while Wi-Fi/ESP-NOW is on). Power the sensor from 3.3 V.
U117 | B2 | 17 | 35 | WS: SLS signal -> GPIO35 (input-only ADC1 pin; ADC2 pins stop working while Wi-Fi/ESP-NOW is on). Power the sensor from 3.3 V.
AG8 | A3 | 13 | 33 | DRAIN PUMP 1 (ALCOHOL) signal moved GPIO13 -> GPIO33: the relay on 13 stayed ON with no command (user report 2026-10-02). 33 was free on this board.
AA9 | A3 |  | PUMP 1 | Label for D33 - Drain Pump 1 (alcohol) now here
AA15 | A3 | PUMP 1 | (cleared) | Old label beside D13
AG110 | B3 | 13 | 33 | DRAIN PUMP 1 (ALCOHOL) signal moved GPIO13 -> GPIO33: the relay on 13 stayed ON with no command (user report 2026-10-02). 33 was free on this board.
AA111 | B3 |  | PUMP 1 | Label for D33 - Drain Pump 1 (alcohol) now here
AA117 | B3 | PUMP 1 | (cleared) | Old label beside D13
B171:K201 | F1 | (none) | Refilling Station block | NEW board block F1 = the REFILLING STATION (ESP32-WROOM; replaces ACS 1 and ACS 2, decided 2026-11-03). Copied from the E1 block and relabelled; yellow = new content. Water-level sensors (signal only; power + GND from the board): Box 1 GPIO34, Box 2 GPIO35, Box 3 GPIO32 - all ADC1 pins, powered from 3.3 V. Valve relay inputs: Box 1 GPIO21, Box 2 GPIO19, Box 3 GPIO18 (relay IN1/IN2/IN3, active-LOW modules like the other relay boards). Same pins as ESP32_REFILL.ino.
I200:K201 | F1 | (copied) | GND 3, 5V 0, 12V ? | Totals: 3 sensors = 3 GND, 5 V 0 (sensors on 3.3 V). The valve coil voltage (12 V DC or 220 V AC) is not decided yet - fill the 12V cell when it is.
D1:E2 blocks | D1,D2,E1,E2 | (info) | not changed | ACS 1 and ACS 2 were removed from the design on 2026-11-03 (the Refilling Station replaces both). Their blocks are left as they were, for reference only.
B3 / B2 blocks | B3,B2 | (info) | not changed | Box 3 changes of 2026-11-03 that these blocks do not show yet: the two drain pumps (B3 relays 8 and 9) are never driven; B2 now reads only the helmet ultrasonic and the door switches (the two container ultrasonics and the two water sensors are not used by Box 3).
