Mejez6603/Jolly-Helmet/ESP32 Project/RevisedJollyHelmet.xlsx

MAC ADDRESS: ? |  |  |  |  |  |  |  | MAC ADDRESS: ? |  |  |  |  |  |  |  | MAC ADDRESS: ?
ESP32 PIN OUTS (A1) |  |  |  | PIN OUTS | PINS | PIN OUTS | PINS | ESP32 PIN OUTS (A2) |  |  |  | PIN OUTS | PINS | PIN OUTS | PINS | ESP32 PIN OUTS (A3) |  |  |  | PIN OUTS | PINS | PIN OUTS | PINS
EN |  | D23 | COIN | ALLAN COIN SLOT |  | TFT Display |  | EN |  | D23 | US: MC SLS | US: Helmet Sensor |  | Sensor |  | EN |  | D23 | ACS DOOR | RELAYS
VP |  | D22 |  | 12V | 12v | VCC | POWER | VP |  | D22 | US: MC SLS | ECHO | 25 | Enclosure Sensor | 27 | VP |  | D22 | COIN_PWR | ACS Side Door | 23
VN |  | TXO |  | GND | GND | GND | GND | VN |  | TXO |  | TRIGGER | 26 | Panel Sensor | 14 | VN |  | TXO |  | COIN_PWR | 22
D34 |  | RXO |  | COIN / SIGNAL | 23 | TFT_CS | 15 | D34 |  | RXO |  | US: MC ALS |  | Backdoor Sensor | 19 | D34 |  | RXO |  | UV 1 | 5
D35 |  | D21 | BUZZER | COUNTER | NAN | TFT_RES / RST | 4 | D35 |  | D21 |  | ECHO | 33 | ACS Sensor | 18 | D35 |  | D21 | UV 2 | UV 2 | 21
D32 |  | D19 |  | BUZZER |  | TFT_DC / RS | 2 | D32 | US: MC ALS | D19 | B_Sensor | TRIGGER | 32 |  |  | D32 |  | D19 | HUMID 2 | DRAIN PUMP 1 ( ALCOHOL) | 13
D33 |  | D18 |  | Positive I/O + | 21 | TFT_SDA / MOSI / DIN | 13 | D33 | US: MC ALS | D18 | ACS_Sen | US: MC SLS |  |  |  | D33 |  | D18 | HUMID 1 | DRAIN PUMP 2 ( SCENTED) | 14
D25 |  | D5 |  | Negative / GND - | GND | TFT_SCL / SCK | 14 | D25 | US: HELMET | D5 | WS: ALS | ECHO | 22 |  |  | D25 | HUMID 3 | D5 | UV 1 | HUMIDIFIER 1 (ALCOHOL) | 18
D26 |  | D17 |  |  |  | BLK / LED | 5v | D26 | US: HELMET | D17 | WS: SLS | TRIGGER | 23 |  |  | D26 |  | D17 | B_LOCK | HUMIDIFIER 2 (SCENTED) | 19
D27 | TFT_T | D16 |  |  |  | SDO (MISO) | NAN | D27 | E_Sensor | D16 |  | WS: ALS |  |  |  | D27 |  | D16 | P_LOCK | HUMIDIFIER 3 (BOTH) | 25
D14 | TFT_D / T | D4 | TFT_D |  |  | TFT Touch Controller |  | D14 | P_Sensor | D4 |  | SIGNAL | 5 |  |  | D14 | PUMP 2 | D4 | E_LOCK | ENCLOSURE LOCK | 4
D12 | TFT_Ta | D2 | TFT_D |  |  | T_CLK | 14 | D12 |  | D2 |  | WS: SLS |  |  |  | D12 |  | D2 |  | PANEL LOCK | 16
D13 | TFT_D / T | D15 | TFT_D |  |  | T_CS | 27 | D13 |  | D15 |  | SIGNAL | 17 |  |  | D13 | PUMP 1 | D15 |  | BACKDOOR LOCK | 17
 |  |  |  |  |  | T_DIN / MOSI | 13
GND | 5V | D22 |  |  |  | T_DO / MISO | 12 | GND | 5V | D22 |  |  |  |  |  | GND | 5V | D22
 |  | D21 |  |  |  | T_IRQ | NAN |  |  | D21 |  |  |  |  |  |  |  | D21
 | 3.3V | VCC |  |  |  |  |  |  | 3.3V | VCC |  |  |  |  |  |  | 3.3V | VCC
 |  | GND |  |  |  |  |  |  |  | GND |  |  |  |  |  |  |  | GND
 |  |  |  |  | z
 |  |  |  | TOTAL |  |  |  |  |  |  |  | TOTAL |  |  |  |  |  |  |  | TOTAL
 |  |  |  | GND | 3 | 12V | 1 |  |  |  |  | GND | 4 | 12V | 1 |  |  |  |  | GND | 0 | 12V | 7
 |  |  |  | 5V | 1 | NAN | 2 |  |  |  |  | 5V | 6 | NAN | 0 |  |  |  |  | 5V | 5 | NAN | 0
MAC ADDRESS: ? |  |  |  |  |  |  |  | MAC ADDRESS: ?
ESP32 PIN OUTS (D1) |  |  |  | PIN OUTS | PINS | PIN OUTS | PINS | ESP32 PIN OUTS (D2) |  |  |  | PIN OUTS | PINS | PIN OUTS | PINS
EN |  | D23 |  | RELAYS |  | SENSORS |  | EN |  | D23 |  | RELAYS |  | SENSORS
VP |  | D22 |  |  |  |  |  | VP |  | D22
VN |  | TXO |  |  |  |  |  | VN |  | TXO
D34 |  | RXO |  |  |  |  |  | D34 |  | RXO
D35 |  | D21 |  |  |  |  |  | D35 |  | D21
D32 |  | D19 |  |  |  |  |  | D32 |  | D19
D33 |  | D18 |  |  |  |  |  | D33 |  | D18
D25 |  | D5 |  |  |  |  |  | D25 |  | D5
D26 |  | D17 |  |  |  |  |  | D26 |  | D17
D27 |  | D16 |  |  |  |  |  | D27 |  | D16
D14 |  | D4 |  |  |  |  |  | D14 |  | D4
D12 |  | D2 |  |  |  |  |  | D12 |  | D2
D13 |  | D15 |  |  |  |  |  | D13 |  | D15
GND | 5V | D22 |  |  |  |  |  | GND | 5V | D22
 |  | D21 |  |  |  |  |  |  |  | D21
 | 3.3V | VCC |  |  |  |  |  |  | 3.3V | VCC
 |  | GND |  |  |  |  |  |  |  | GND
 |  |  |  | TOTAL |  |  |  |  |  |  |  | TOTAL
 |  |  |  | GND | 4 | 12V | 0 |  |  |  |  | GND | 0 | 12V | 0
 |  |  |  | 5V | 4 | NAN | 0 |  |  |  |  | 5V | 0 | NAN | 0
MAC ADDRESS: ? |  |  |  |  |  |  |  | MAC ADDRESS: ?
ESP32 PIN OUTS (C1) |  |  |  | PIN OUTS | PINS | PIN OUTS | PINS | ESP32 PIN OUTS (C2) |  |  |  | PIN OUTS | PINS | PIN OUTS | PINS
EN |  | D23 | COIN | ALLAN COIN SLOT |  | TFT Display |  | EN |  | D23 | FAN | US: Helmet Sensor |  | Magnetic Door Sensor
VP |  | D22 |  | 12V | 12v | VCC | POWER | VP |  | D22 |  | ECHO | 25 | Enclosure Sensor | 27
VN |  | TXO |  | GND | GND | GND | GND | VN |  | TXO |  | TRIGGER | 26 | Panel Sensor | 14
D34 |  | RXO |  | COIN / SIGNAL | 23 | TFT_CS | 15 | D34 |  | RXO |  | VCC 5V | 5v | Backdoor Sensor | 19
D35 |  | D21 | BUZZER | COUNTER | NAN | TFT_RES / RST | 4 | D35 |  | D21 |  | GND | GND | 12V Solenoid Locks
D32 |  | D19 |  | BUZZER |  | TFT_DC / RS | 2 | D32 |  | D19 | B_Sensor | UV Strip Light (RELAY) |  | Enclosure Lock Signal | 4
D33 |  | D18 |  | Positive I/O + | 21 | TFT_SDA / MOSI / DIN | 13 | D33 |  | D18 | HEATER | SIGNAL | 5 | Panel Lock Signal | 16
D25 |  | D5 |  | Negative / GND - | GND | TFT_SCL / SCK | 14 | D25 | US: HELMET | D5 | UV Lights | VCC 12v | 12v | Backdoor Lock Signal | 17
D26 |  | D17 |  |  |  | BLK / LED | 5v | D26 | US: HELMET | D17 | B_Lock | GND | GND
D27 | TFT_T | D16 |  |  |  | SDO (MISO) | NAN | D27 | E_Sensor | D16 | P_Lock | HEATER (RELAY)
D14 | TFT_D / T | D4 | TFT_D |  |  | TFT Touch Controller |  | D14 | P_Sensor | D4 | E_Lock | SIGNAL | 18
D12 | TFT_Ta | D2 | TFT_D |  |  | T_CLK | 14 | D12 |  | D2 |  | FAN
D13 | TFT_D / T | D15 | TFT_D |  |  | T_CS | 27 | D13 |  | D15 |  | SIGNAL | 23
 |  |  |  |  |  | T_DIN / MOSI | 13
GND | 5V | D22 |  |  |  | T_DO / MISO | 12 | GND | 5V | D22
 |  | D21 |  |  |  | T_IRQ | NAN |  |  | D21
 | 3.3V | VCC |  |  |  |  |  |  | 3.3V | VCC
 |  | GND |  |  |  |  |  |  |  | GND
 |  |  |  |  | z
 |  |  |  | TOTAL |  |  |  |  |  |  |  | TOTAL
 |  |  |  | GND | 3 | 12V | 1 |  |  |  |  | GND | 4 | 12V | 1
 |  |  |  | 5V | 1 | NAN | 2 |  |  |  |  | 5V | 4 | NAN | 0
MAC ADDRESS: ? |  |  |  |  |  |  |  | MAC ADDRESS: ? |  |  |  |  |  |  |  | MAC ADDRESS: ?
ESP32 PIN OUTS (B1) |  |  |  | PIN OUTS | PINS | PIN OUTS | PINS | ESP32 PIN OUTS (B2) |  |  |  | PIN OUTS | PINS | PIN OUTS | PINS | ESP32 PIN OUTS (B3) |  |  |  | PIN OUTS | PINS | PIN OUTS | PINS
EN |  | D23 | COIN | ALLAN COIN SLOT |  | TFT Display |  | EN |  | D23 | US: MC SLS | US: Helmet Sensor |  | Sensor |  | EN |  | D23 | ACS DOOR | RELAYS
VP |  | D22 |  | 12V | 12v | VCC | POWER | VP |  | D22 | US: MC SLS | ECHO | 25 | Enclosure Sensor | 27 | VP |  | D22 | COIN_PWR | ACS Side Door | 23
VN |  | TXO |  | GND | GND | GND | GND | VN |  | TXO |  | TRIGGER | 26 | Panel Sensor | 14 | VN |  | TXO |  | COIN_PWR | 22
D34 |  | RXO |  | COIN / SIGNAL | 23 | TFT_CS | 15 | D34 |  | RXO |  | US: MC ALS |  | Backdoor Sensor | 19 | D34 |  | RXO |  | UV 1 | 5
D35 |  | D21 | BUZZER | COUNTER | NAN | TFT_RES / RST | 4 | D35 |  | D21 |  | ECHO | 33 | ACS Sensor | 18 | D35 |  | D21 | UV 2 | UV 2 | 21
D32 |  | D19 |  | BUZZER |  | TFT_DC / RS | 2 | D32 | US: MC ALS | D19 | B_Sensor | TRIGGER | 32 |  |  | D32 |  | D19 | HUMID 2 | DRAIN PUMP 1 ( ALCOHOL) | 13
D33 |  | D18 |  | Positive I/O + | 21 | TFT_SDA / MOSI / DIN | 13 | D33 | US: MC ALS | D18 | ACS_Sen | US: MC SLS |  |  |  | D33 |  | D18 | HUMID 1 | DRAIN PUMP 2 ( SCENTED) | 14
D25 |  | D5 |  | Negative / GND - | GND | TFT_SCL / SCK | 14 | D25 | US: HELMET | D5 | WS: ALS | ECHO | 22 |  |  | D25 | HUMID 3 | D5 | UV 1 | HUMIDIFIER 1 (ALCOHOL) | 18
D26 |  | D17 |  |  |  | BLK / LED | 5v | D26 | US: HELMET | D17 | WS: SLS | TRIGGER | 23 |  |  | D26 | HEATER | D17 | B_LOCK | HUMIDIFIER 2 (SCENTED) | 19
D27 | TFT_T | D16 |  |  |  | SDO (MISO) | NAN | D27 | E_Sensor | D16 |  | WS: ALS |  |  |  | D27 |  | D16 | P_LOCK | HUMIDIFIER 3 (BOTH) | 25
D14 | TFT_D / T | D4 | TFT_D |  |  | TFT Touch Controller |  | D14 | P_Sensor | D4 |  | SIGNAL | 5 |  |  | D14 | PUMP 2 | D4 | E_LOCK | ENCLOSURE LOCK | 4
D12 | TFT_Ta | D2 | TFT_D |  |  | T_CLK | 14 | D12 |  | D2 |  | WS: SLS |  |  |  | D12 |  | D2 |  | PANEL LOCK | 16
D13 | TFT_D / T | D15 | TFT_D |  |  | T_CS | 27 | D13 |  | D15 |  | SIGNAL | 17 |  |  | D13 | PUMP 1 | D15 |  | BACKDOOR LOCK | 17
 |  |  |  |  |  | T_DIN / MOSI | 13 |  |  |  |  |  |  |  |  |  |  |  |  | HEATER | 26
GND | 5V | D22 |  |  |  | T_DO / MISO | 12 | GND | 5V | D22 |  |  |  |  |  | GND | 5V | D22
 |  | D21 |  |  |  | T_IRQ | NAN |  |  | D21 |  |  |  |  |  |  |  | D21
 | 3.3V | VCC |  |  |  |  |  |  | 3.3V | VCC |  |  |  |  |  |  | 3.3V | VCC
 |  | GND |  |  |  |  |  |  |  | GND |  |  |  |  |  |  |  | GND
 |  |  |  |  |  |  |  |  |  |  |  |  |  |  |  |  |  |  |  | 0
 |  |  |  |  | z
 |  |  |  | TOTAL |  |  |  |  |  |  |  | TOTAL |  |  |  |  |  |  |  | TOTAL
 |  |  |  | GND | 3 | 12V | 1 |  |  |  |  | GND | 4 | 12V | 1 |  |  |  |  | GND | 0 | 12V+ | 8
 |  |  |  | 5V | 1 | NAN | 2 |  |  |  |  | 5V | 6 | NAN | 0 |  |  |  |  | 5V | 5 | NAN | 0
MAC ADDRESS: ? |  |  |  |  |  |  |  | MAC ADDRESS: ?
ESP32 PIN OUTS (E1) |  |  |  | PIN OUTS | PINS | PIN OUTS | PINS | ESP32 PIN OUTS (E2) |  |  |  | PIN OUTS | PINS | PIN OUTS | PINS
EN |  | D23 |  | RELAYS |  | US: WATER SENSOR |  | EN |  | D23
VP |  | D22 |  | ALCOHOL PUMP |  | ECHO |  | VP |  | D22
VN |  | TXO |  | WATER PUMP ALC |  | TRIGGER |  | VN |  | TXO
D34 |  | RXO |  | WATER PUMP SCN |  | US: SCENTED LIQUID SENSOR |  | D34 |  | RXO
D35 |  | D21 |  | SCENTED PUMP |  | ECHO |  | D35 |  | D21
D32 |  | D19 |  | MIXER ALCOHOL PUMP |  | TRIGGER |  | D32 |  | D19
D33 |  | D18 |  | MIXER SCENTED PUMP |  | WL: ALCOHOL SENSOR |  | D33 |  | D18
D25 |  | D5 |  |  |  | SIGNAL |  | D25 |  | D5
D26 |  | D17 |  |  |  | WL: MIXER SENSOR |  | D26 |  | D17
D27 |  | D16 |  |  |  | SIGNAL |  | D27 |  | D16
D14 |  | D4 |  |  |  |  |  | D14 |  | D4
D12 |  | D2 |  |  |  |  |  | D12 |  | D2
D13 |  | D15 |  |  |  |  |  | D13 |  | D15
GND | 5V | D22 |  |  |  |  |  | GND | 5V | D22
 |  | D21 |  |  |  |  |  |  |  | D21
 | 3.3V | VCC |  |  |  |  |  |  | 3.3V | VCC
 |  | GND |  |  |  |  |  |  |  | GND
 |  |  |  | TOTAL |  |  |  |  |  |  |  | TOTAL
 |  |  |  | GND | 4 | 12V | 0 |  |  |  |  | GND | 0 | 12V | 0
 |  |  |  | 5V | 4 | NAN | 0 |  |  |  |  | 5V | 0 | NAN | 0
