Mejez6603/Jolly-Helmet/ESP32 Project/MANUAL/images/screens/OUT_OF_ORDER.png

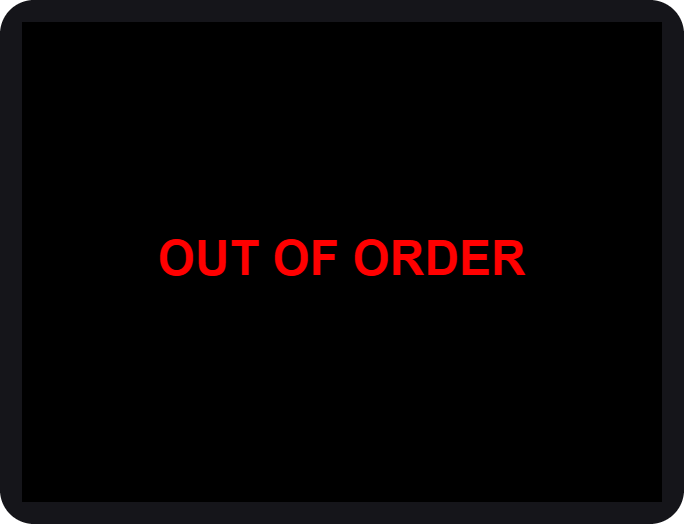
ESP32 Project/MANUAL/images/screens/OUT_OF_ORDER.png
