Mejez6603/Jolly-Helmet/ESP32 Project/BOX 2 STEP.txt

{
  "box": "box2",
  "preset": "Preset 2",
  "isDefault": false,
  "rules": {
    "bands": [
      {
        "from": 1,
        "to": 3,
        "minutes": 3
      },
      {
        "from": 4,
        "to": 6,
        "minutes": 5
      },
      {
        "from": 7,
        "to": 8,
        "minutes": 8
      },
      {
        "from": 9,
        "to": 10,
        "minutes": 10
      }
    ],
    "minMinutes": 3,
    "coins": 10,
    "timeValue": 3,
    "timeUnit": "min",
    "maxCoins": 100,
    "freeRetry": {
      "enabled": true,
      "minRating": 1,
      "minutes": 2
    },
    "maxMinutes": 30
  },
  "steps": [
    {
      "name": "TAPS",
      "durationSec": 0,
      "durationMode": "fixed",
      "relayBitmask": 0,
      "intervalBitmask": 0,
      "intervalOnSec": 60,
      "intervalOffSec": 60,
      "sensorBitmask": 0,
      "phaseBitmask": 0,
      "branches": [
        {
          "conditions": [
            {
              "key": "touchPressed",
              "negate": false
            }
          ],
          "isElse": false,
          "remember": [],
          "goto": "__next__"
        }
      ],
      "displayTokens": "#000000|ST,165,105,#FFFFFF,TAP anywhere to ,MC,2|TT,160,136,#FFFF00,START,500,MC,4"
    },
    {
      "name": "WELCOME",
      "durationSec": 0,
      "durationMode": "fixed",
      "relayBitmask": 0,
      "intervalBitmask": 0,
      "intervalOnSec": 60,
      "intervalOffSec": 60,
      "sensorBitmask": 0,
      "phaseBitmask": 0,
      "branches": [
        {
          "conditions": [
            {
              "key": "touchPressed",
              "negate": false
            }
          ],
          "isElse": false,
          "remember": [],
          "goto": "RATE YOUR HELMET A"
        }
      ],
      "displayTokens": "#000000|ST,160,60,#FFFFFF,Welcome to,BC,2|ST,160,60,#FFFFFF,JOLLY HELMET,TC,4|ST,162,120,#FFFFFF,Make your Helmet,BC,2|ST,160,120,#FFFFFF,Happy Again!,TC,4|TT,160,180,#FFFF00,Tap to START,500,TC,2"
    },
    {
      "name": "RATE YOUR HELMET A",
      "durationSec": 0,
      "durationMode": "fixed",
      "relayBitmask": 0,
      "intervalBitmask": 0,
      "intervalOnSec": 60,
      "intervalOffSec": 60,
      "sensorBitmask": 0,
      "phaseBitmask": 0,
      "branches": [
        {
          "conditions": [
            {
              "key": "btn:ACTION",
              "negate": false
            }
          ],
          "isElse": false,
          "remember": [],
          "goto": "TIME ALLOT"
        }
      ],
      "displayTokens": "#000000|BTN,19,192,282,36,#1C1C20,CONFIRM,ACTION|ST,160,60,#FFFFFF,DRY O' METER,BC,4|ST,28,20,#FFFFFF,Before,MC,1|NR2,24,70,272,100,1,#FFFFFF,#22c55e,DRY;WET"
    },
    {
      "name": "TIME ALLOT",
      "durationSec": 0,
      "durationMode": "fixed",
      "relayBitmask": 0,
      "intervalBitmask": 0,
      "intervalOnSec": 60,
      "intervalOffSec": 60,
      "sensorBitmask": 0,
      "phaseBitmask": 0,
      "branches": [
        {
          "conditions": [
            {
              "key": "touchPressed",
              "negate": false
            }
          ],
          "isElse": false,
          "remember": [],
          "goto": "INSERT COIN"
        }
      ],
      "displayTokens": "#000000|NP,0,0,320,240,#FFFFFF,18,ALLOCATE HEATING TIME"
    },
    {
      "name": "INSERT COIN",
      "durationSec": 0,
      "durationMode": "fixed",
      "relayBitmask": 0,
      "intervalBitmask": 0,
      "intervalOnSec": 60,
      "intervalOffSec": 60,
      "sensorBitmask": 0,
      "phaseBitmask": 0,
      "branches": [
        {
          "conditions": [
            {
              "key": "coinThreshold",
              "negate": false
            }
          ],
          "isElse": false,
          "remember": [],
          "goto": "__next__"
        },
        {
          "conditions": [
            {
              "key": "btn:INSERT_CANCEL",
              "negate": false
            }
          ],
          "isElse": false,
          "remember": [],
          "goto": "CANCEL"
        }
      ],
      "displayTokens": "#000000|ST,160,60,#FFFFFF,INSERT THE REQUIRED COIN,TC,2|TT,144,120,#FFFFFF,/ {REQUIREDCOIN} Coin,0,ML,2|TT,126,120,#FFFF00,{COINS},500,MR,2|BTN,20,190,90,32,#1C1C20,CANCEL,INSERT_CANCEL"
    },
    {
      "name": "OPEN A",
      "durationSec": 0,
      "durationMode": "fixed",
      "relayBitmask": 1,
      "intervalBitmask": 0,
      "intervalOnSec": 60,
      "intervalOffSec": 60,
      "sensorBitmask": 2,
      "phaseBitmask": 0,
      "branches": [
        {
          "conditions": [
            {
              "key": "doorOpen",
              "negate": false
            }
          ],
          "isElse": false,
          "remember": [],
          "goto": "SENSORS A"
        }
      ],
      "displayTokens": "#000000|ST,160,88,#FFFFFF,Please,MC,2|ST,160,156,#FFFFFF,Door to Proceed,MC,2|TT,152,120,#FFFF00, OPEN,500,MC,4"
    },
    {
      "name": "SENSORS A",
      "durationSec": 0,
      "durationMode": "fixed",
      "relayBitmask": 0,
      "intervalBitmask": 0,
      "intervalOnSec": 60,
      "intervalOffSec": 60,
      "sensorBitmask": 3,
      "phaseBitmask": 0,
      "branches": [
        {
          "conditions": [
            {
              "key": "helmetPresent",
              "negate": false
            }
          ],
          "isElse": false,
          "remember": [],
          "goto": "CLOSE DOOR A"
        },
        {
          "conditions": [
            {
              "key": "doorClosed",
              "negate": false
            },
            {
              "key": "helmetAbsent",
              "negate": false,
              "joiner": "AND"
            }
          ],
          "isElse": false,
          "remember": [],
          "goto": "HELMET NOTICE A"
        }
      ],
      "displayTokens": "#000000|ST,160,92,#FFFFFF,Please,MC,2|ST,160,148,#FFFFFF, Headgear Inside,MC,2|TT,160,120,#FFFF00,PLACE,500,MC,4"
    },
    {
      "name": "CLOSE DOOR A",
      "durationSec": 0,
      "durationMode": "fixed",
      "relayBitmask": 0,
      "intervalBitmask": 0,
      "intervalOnSec": 60,
      "intervalOffSec": 60,
      "sensorBitmask": 3,
      "phaseBitmask": 0,
      "branches": [
        {
          "conditions": [
            {
              "key": "doorClosed",
              "negate": false
            },
            {
              "key": "helmetPresent",
              "negate": false,
              "joiner": "AND"
            }
          ],
          "isElse": false,
          "remember": [],
          "goto": "__next__"
        },
        {
          "conditions": [
            {
              "key": "doorClosed",
              "negate": false
            },
            {
              "key": "helmetPresent",
              "negate": true,
              "joiner": "AND"
            }
          ],
          "isElse": false,
          "remember": [],
          "goto": "HELMET NOTICE A"
        }
      ],
      "displayTokens": "#000000|ST,160,92,#FFFFFF,Please,MC,2|ST,160,148,#FFFFFF,Door to Proceed,MC,2|TT,160,120,#FFFF00,CLOSE,500,MC,4"
    },
    {
      "name": "START HEATING",
      "durationSec": 0,
      "durationMode": "fixed",
      "relayBitmask": 0,
      "intervalBitmask": 0,
      "intervalOnSec": 60,
      "intervalOffSec": 60,
      "sensorBitmask": 3,
      "phaseBitmask": 0,
      "branches": [
        {
          "conditions": [
            {
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
          "conditions": [
            {
              "key": "btn:FREE_YES",
              "negate": false
            }
          ],
          "isElse": false,
          "remember": [
            "retry=used"
          ],
          "goto": "OPEN A"
        },
        {
          "conditions": [
            {
              "key": "btn:FREE_NO",
              "negate": false
            }
          ],
          "isElse": false,
          "remember": [],
          "goto": "FINISH"
        }
      ],
      "displayTokens": "#000000|ST,160,120,#FFFFFF,2 MINUTES,MC,2|ST,160,88,#FFFFFF,FREE TIME,MC,4|BTN,12,154,140,52,#069322,YES,FREE_YES|BTN,168,154,140,52,#A91414,NO,FREE_NO"
    },
    {
      "name": "FINISH",
      "durationSec": 5,
      "durationMode": "fixed",
      "relayBitmask": 0,
      "intervalBitmask": 0,
      "intervalOnSec": 60,
      "intervalOffSec": 60,
      "sensorBitmask": 0,
      "phaseBitmask": 0,
      "branches": [
        {
          "conditions": [
            {
              "key": "timerZero",
              "negate": false
            }
          ],
          "isElse": false,
          "remember": [],
          "goto": "TAPS"
        }
      ],
      "displayTokens": "#000000|ST,160,76,#FFFFFF,Thank you,MC,2|ST,160,102,#FFFFFF,for your patronage!,MC,2|TT,160,144,#FFFF00,We hope to see you again! :D,500,MC,2"
    },
    {
      "name": "ABORT",
      "durationSec": 0,
      "durationMode": "fixed",
      "relayBitmask": 0,
      "intervalBitmask": 0,
      "intervalOnSec": 60,
      "intervalOffSec": 60,
      "sensorBitmask": 0,
      "phaseBitmask": 0,
      "branches": [
        {
          "conditions": [
            {
              "key": "btn:ABORT_YES",
              "negate": false
            }
          ],
          "isElse": false,
          "remember": [],
          "goto": "COOLDOWN"
        },
        {
          "conditions": [
            {
              "key": "btn:ABORT_NO",
              "negate": false
            }
          ],
          "isElse": false,
          "remember": [],
          "goto": "__return__"
        }
      ],
      "displayTokens": "#000000|ST,160,120,#FFFFFF,COIN(s) won't be Refunded.,MC,2|ST,160,88,#FFFFFF,Cancel operation?,MC,2|BTN,12,154,140,52,#A91414,CONFIRM,ABORT_YES|BTN,168,154,140,52,#069322,RESUME,ABORT_NO"
    },
    {
      "name": "CANCEL",
      "durationSec": 0,
      "durationMode": "fixed",
      "relayBitmask": 0,
      "intervalBitmask": 0,
      "intervalOnSec": 60,
      "intervalOffSec": 60,
      "sensorBitmask": 0,
      "phaseBitmask": 0,
      "branches": [
        {
          "conditions": [
            {
              "key": "btn:CANCEL_YES",
              "negate": false
            }
          ],
          "isElse": false,
          "remember": [],
          "goto": "TAPS"
        },
        {
          "conditions": [
            {
              "key": "btn:CANCEL_NO",
              "negate": false
            }
          ],
          "isElse": false,
          "remember": [],
          "goto": "__return__"
        }
      ],
      "displayTokens": "#000000|ST,160,88,#FFFFFF,Cancel operation?,MC,2|ST,160,120,#FFFFFF,COIN(s) won't be Refunded.,MC,2|BTN,12,154,140,52,#3B891A,YES,CANCEL_YES|BTN,168,154,140,52,#991414,NO,CANCEL_NO"
    },
    {
      "name": "MAINTENANCE",
      "durationSec": 0,
      "durationMode": "fixed",
      "relayBitmask": 0,
      "intervalBitmask": 0,
      "intervalOnSec": 60,
      "intervalOffSec": 60,
      "sensorBitmask": 0,
      "phaseBitmask": 0,
      "branches": [],
      "displayTokens": "#000000|ST,160,80,#FFFFFF,IT'S ON,TC,2|TT,160,120,#FFD84E,MAINTENANCE,1000,MC,4"
    },
    {
      "name": "OUT OF ORDER",
      "durationSec": 0,
      "durationMode": "fixed",
      "relayBitmask": 0,
      "intervalBitmask": 0,
      "intervalOnSec": 60,
      "intervalOffSec": 60,
      "sensorBitmask": 0,
      "phaseBitmask": 0,
      "branches": [],
      "displayTokens": "#000000|TT,160,120,#FF0000,OUT OF ORDER,1000,MC,4"
    },
    {
      "name": "HELMET NOTICE A",
      "durationSec": 2,
      "durationMode": "fixed",
      "relayBitmask": 0,
      "intervalBitmask": 0,
      "intervalOnSec": 60,
      "intervalOffSec": 60,
      "sensorBitmask": 0,
      "phaseBitmask": 0,
      "branches": [
        {
          "conditions": [
            {
              "key": "timerZero",
              "negate": false
            }
          ],
          "isElse": false,
          "remember": [],
          "goto": "OPEN A"
        }
      ],
      "displayTokens": "#000000|TT,160,120,#FFFF00,HELMET,500,MC,4|ST,160,92,#FFFFFF,NO,MC,2|ST,160,152,#FFFFFF,DETECTED,MC,2"
    },
    {
      "name": "HELMET NOTICE B",
      "durationSec": 2,
      "durationMode": "fixed",
      "relayBitmask": 0,
      "intervalBitmask": 0,
      "intervalOnSec": 60,
      "intervalOffSec": 60,
      "sensorBitmask": 0,
      "phaseBitmask": 0,
      "branches": [
        {
          "conditions": [
            {
              "key": "timerZero",
              "negate": false
            }
          ],
          "isElse": false,
          "remember": [],
          "goto": "OPEN B"
        }
      ],
      "displayTokens": "#000000|TT,160,120,#FFFF00,HELMET,500,MC,4|ST,160,152,#FFFFFF,DETECTED,MC,2"
    }
  ]
}
