Mejez6603/Jolly-Helmet/ESP32 Project/MANUAL/images/v11/portal_wifi.png

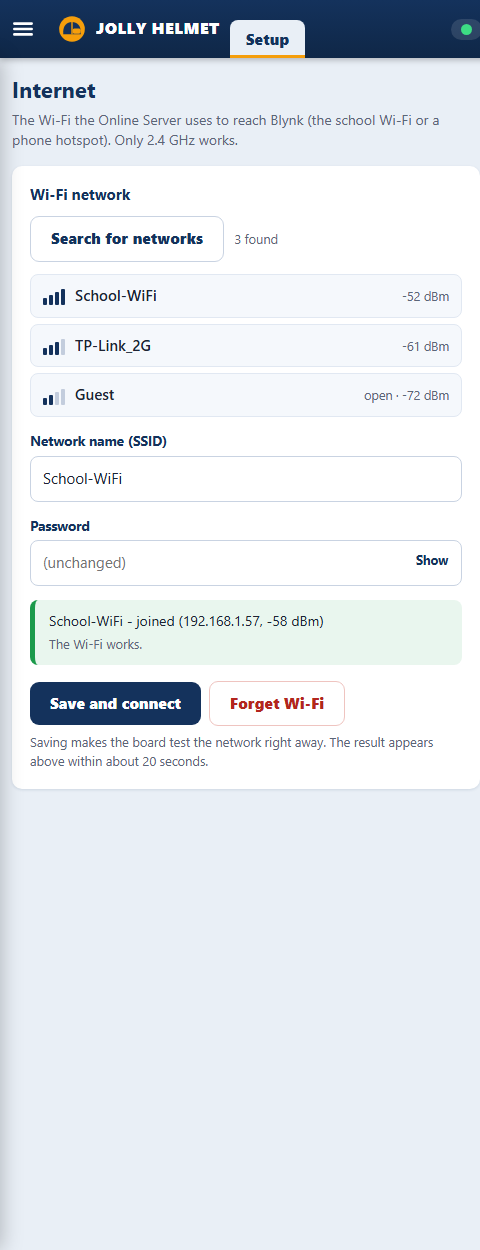
ESP32 Project/MANUAL/images/v11/portal_wifi.png
