Mejez6603/Jolly-Helmet/ESP32 Project/MANUAL/images/web/web_checklist.png

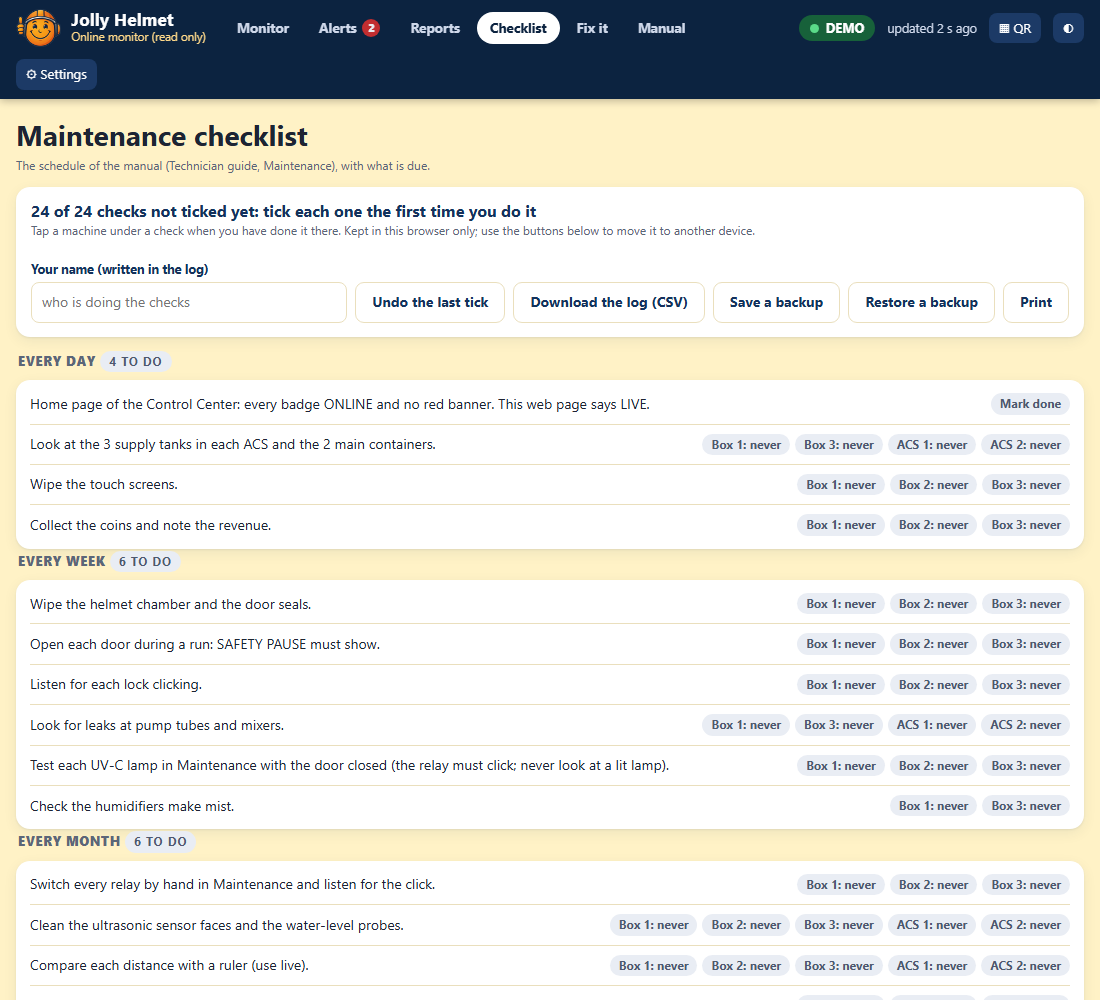
ESP32 Project/MANUAL/images/web/web_checklist.png
