Mejez6603/Jolly-Helmet/ESP32 Project/MANUAL/images/web/web_checklist_c.png

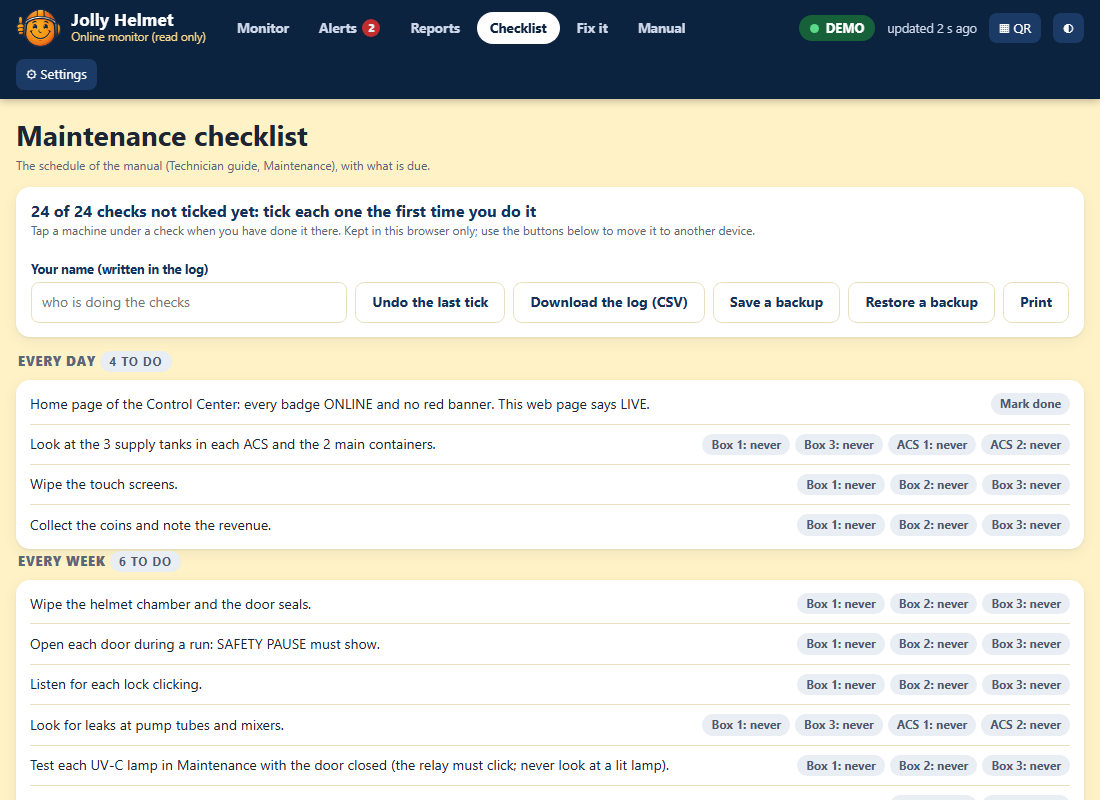
ESP32 Project/MANUAL/images/web/web_checklist_c.png
