Mejez6603/Jolly-Helmet/ESP32 Project/FLOWCHART_SYSTEM/SYSTEM_Flowcharts.pdf

## Jolly Helmet · system flowcharts · 01_system · made 2026-11-07

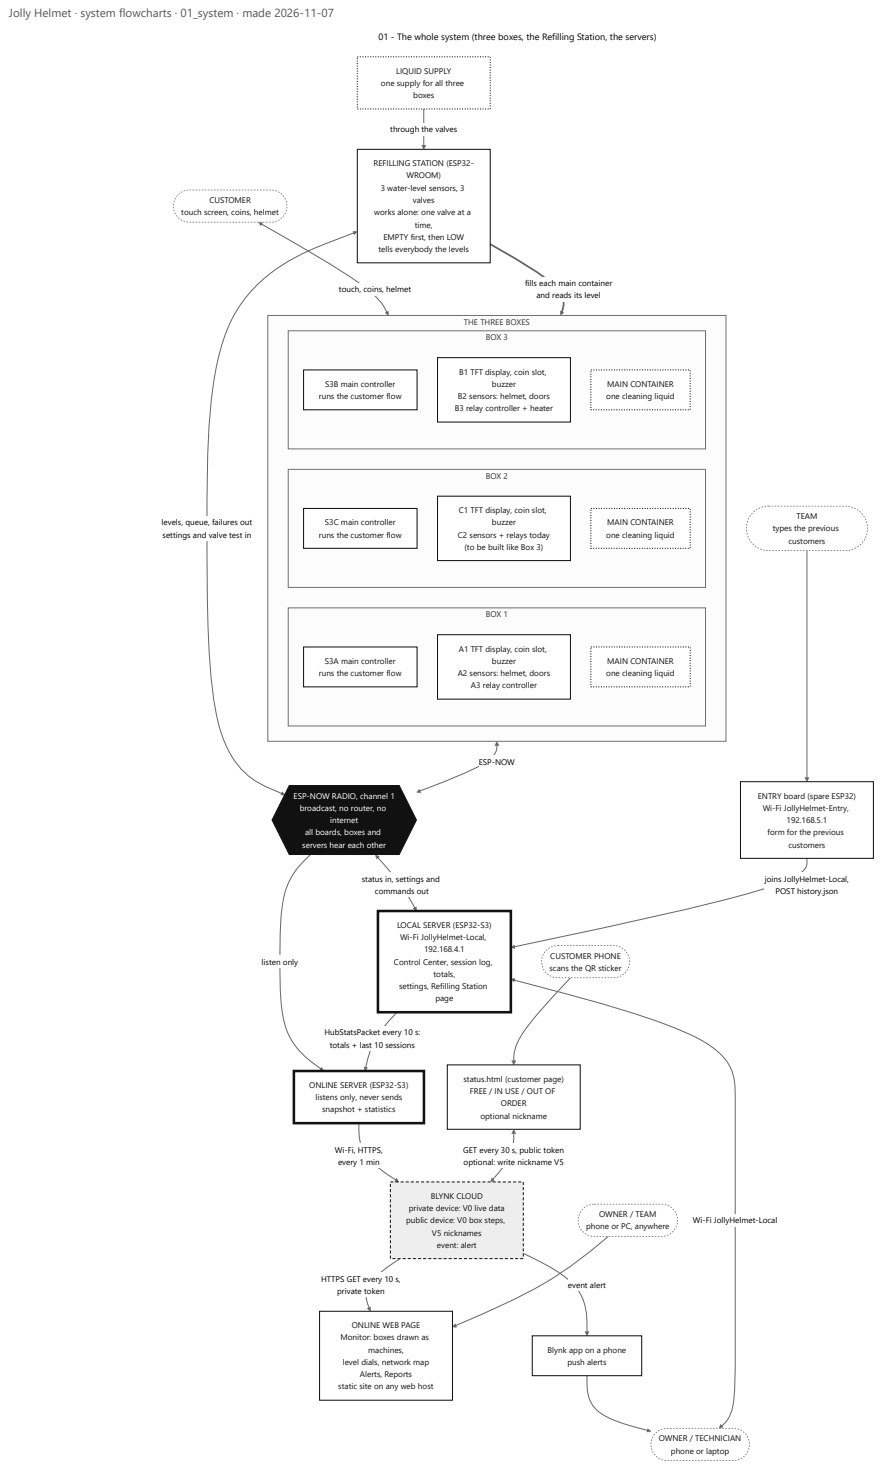
[picture p228: page 1]
listen only; private token; event alert; ESP-NOW; BOX 2; buzzer; BOX 1; totals,; page

01 - The whole system (three boxes, the Refilling Station, the servers)

LIQUID SUPPLY
one supply for all three
boxes

through the valves

REFILLING STATION (ESP32- WROOM)

3 water-level sensors, 3
valves

CUSTOMER
touch screen, coins, helmet

works alone: one valve at a

time,
EMPTY first, then LOW
tells everybody the levels

fills each main container
and reads its level

touch, coins, helmet

THE THREE BOXES
BOX 3

B1 TFT display, coin slot,
buzzer

S3B main controller
runs the customer flow

MAIN CONTAINER
one cleaning liquid

B2 sensors: helmet, doors
B3 relay controller + heater

C1 TFT display, coin slot,

levels, queue, failures out
settings and valve test in

S3C main controller

TEAM
types the previous
customers

C2 sensors + relays today
(to be built like Box 3)

A1 TFT display, coin slot,

S3A main controller

A2 sensors: helmet, doors
A3 relay controller

ESP-NOW RADIO, channel 1
broadcast, no router, no
internet
all boards, boxes and
servers hear each other

ENTRY board (spare ESP32)
Wi-Fi JollyHelmet-Entry,
form for the previous

status in, settings and
commands out

joins JollyHelmet-Local,
POST history.json

LOCAL SERVER (ESP32-S3)
Wi-Fi JollyHelmet-Local,
Control Center, session log,

CUSTOMER PHONE
scans the QR sticker

settings, Refilling Station

HubStatsPacket every 10 s:
totals + last 10 sessions

status.html (customer page)
FREE / IN USE / OUT OF
ORDER
optional nickname

ONLINE SERVER (ESP32-S3)
listens only, never sends
snapshot + statistics

Wi-Fi, HTTPS,
every 1 min

GET every 30 s, public token
optional: write nickname V5

BLYNK CLOUD
private device: V0 live data
public device: V0 box steps,
V5 nicknames
event: alert

OWNER / TEAM
phone or PC, anywhere

Wi-Fi JollyHelmet-Local

HTTPS GET every 10 s,

ONLINE WEB PAGE
Monitor: boxes drawn as
machines,
level dials, network map
Alerts, Reports
static site on any web host

Blynk app on a phone
push alerts

OWNER / TECHNICIAN
phone or laptop

## Jolly Helmet · system flowcharts · 02_customer_flow_part1 · made 2026-11-07

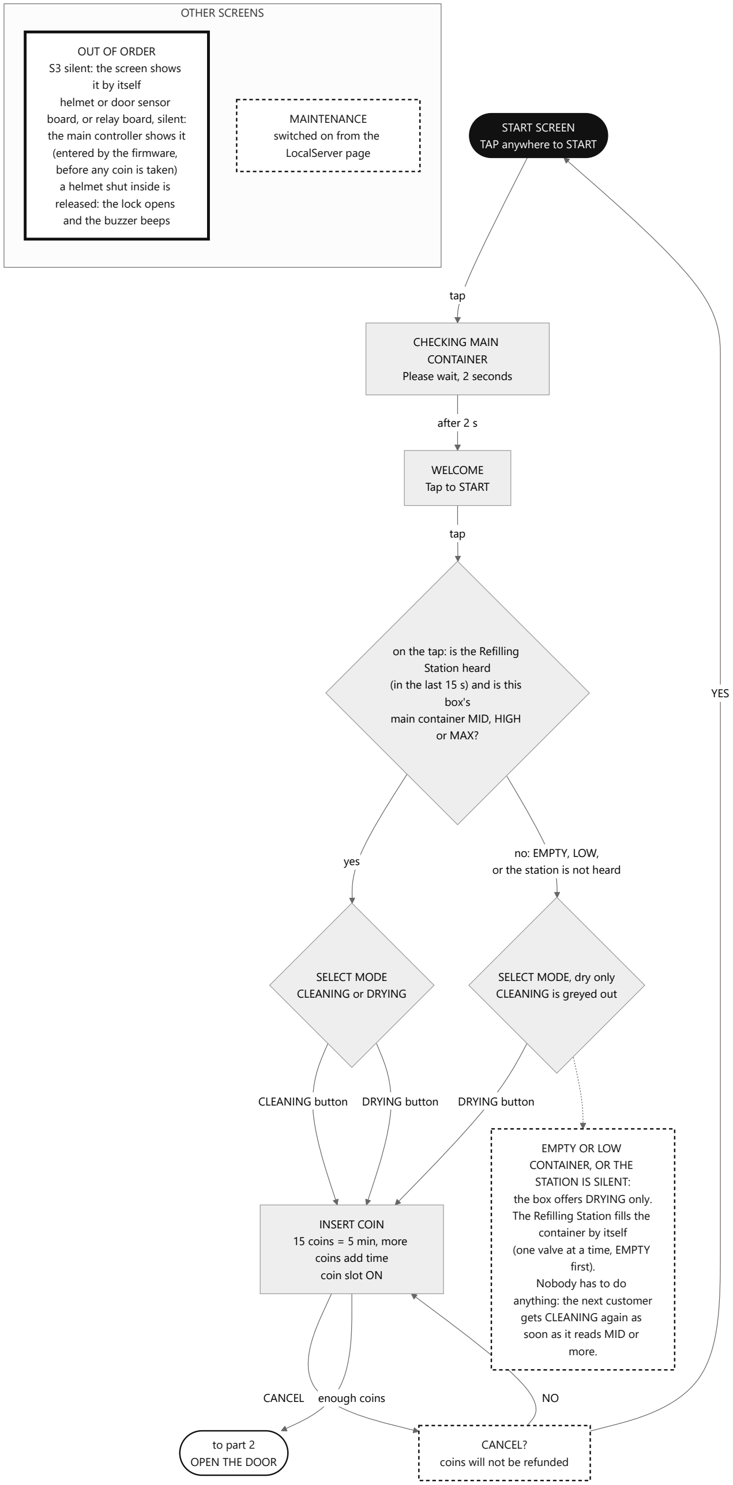
[picture p229: figure]
tap; after 2 s; yes; no: EMPTY, LOW, or the station is not heard; CANCEL; YES; enough coins; OTHER SCREENS; OUT OF ORDER S3 silent: the screen shows it by itself helmet or door sensor board, or relay board, silent: the main controller shows it (entered by the firmware, before any coin is taken) a helmet shut inside is released: the lock opens and the buzzer beeps; MAINTENANCE switched on from the LocalServer page; START SCREEN TAP anywhere to START; CHECKING MAIN CONTAINER Please wait, 2 seconds; WELCOME Tap to START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

CLEANING button | DRYING button | DRYING button

02 - Customer flow of a box, part 1 - start, checking the container, mode, coins (same for Box 1, 2 and 3)

## Jolly Helmet · system flowcharts · 03_customer_flow_part2 · made 2026-11-07

### door opened

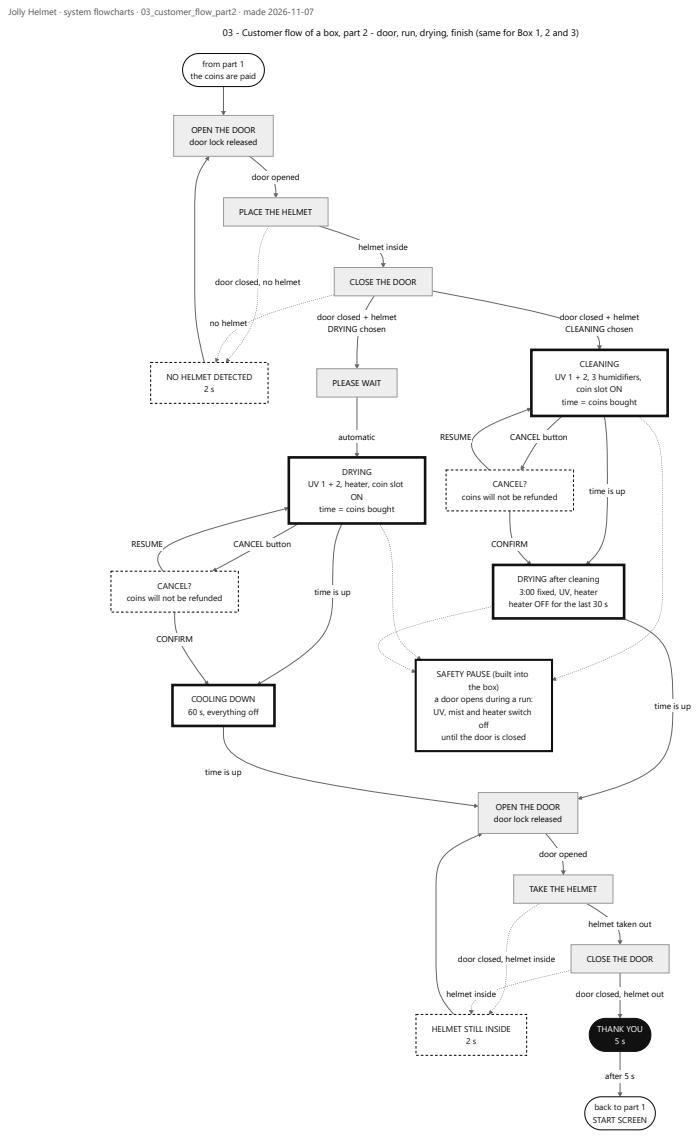
[picture p230: page 3]
helmet inside; no helmet; door closed + helmet; CLEANING chosen; automatic; CANCEL button; CONFIRM; RESUME; door opened; door closed, helmet out; after 5 s; PLEASE WAIT; DRYING; COOLING DOWN 60 s, everything off; THANK YOU 5 s; off

03 - Customer flow of a box, part 2 - door, run, drying, finish (same for Box 1, 2 and 3)

from part 1
the coins are paid

OPEN THE DOOR
door lock released

PLACE THE HELMET

door closed, no helmet

CLOSE THE DOOR

door closed + helmet
DRYING chosen

CLEANING
UV 1 + 2, 3 humidifiers,
coin slot ON
time = coins bought

NO HELMET DETECTED

UV 1 + 2, heater, coin slot

CANCEL?
coins will not be refunded

time is up

DRYING after cleaning
3:00 fixed, UV, heater
heater OFF for the last 30 s

SAFETY PAUSE (built into
the box)

a door opens during a run:
UV, mist and heater switch

until the door is closed

TAKE THE HELMET

helmet taken out

door closed, helmet inside

HELMET STILL INSIDE

back to part 1
START SCREEN

## Jolly Helmet · system flowcharts · 04_inside_one_box · made 2026-11-07

Refilling Station | LocalServer | Online Server

Relay controller
(A3 / B3 / C2)

Sensors
(A2 / B2 / C2)

Main controller
(S3A / S3B / S3C)

TFT display
(A1 / B1 / C1)

everything is sent by ESP-NOW broadcast on channel 1, no router

the box reads only its own container. CHECKING lasts 2 s, then on the tap: station silent for 15 s, or EMPTY or LOW = DRYING only. The box never asks the station for anything

no sign of the main
controller for 15 s: the
relay controller switches
everything off, and
releases the enclosure
lock if the sensors see a
helmet shut inside (it
learns the helmet
distance from the main
controller's settings
broadcast and keeps it
in its own flash)

no sign of the main controller: the TFT display shows OUT OF ORDER by itself (nobody is left to send it a screen), says Your helmet is still inside when the sensors see one shut in, and beeps 100 ms on / 500 ms off

the helmet or door
sensor board, or the
relay board, is silent: the main controller shows
OUT OF ORDER and
takes no coins. A helmet
shut inside is released
after 2 s (lock opens,
buzzer beeps until the
door is opened). After a
power cut (screen,
sensors and relays on a
UPS) the restarted main
controller hands a
trapped helmet back
first

the main controller
keeps its settings in its
own flash and
re-broadcasts them

the station keeps its
settings in its own flash
and re-broadcasts them

a finished or cancelled session: the session counter in the box status goes up, the LocalServer records it

Customer

draw this screen
(CMD_STEP_RENDER)

1
touch a button, insert coins

2
which button
(CMD_TOUCH_ACTION) and the coin pulses

3
doors and helmet distance, about every 1 s and when something
changes

4
every 1 s: the level of the three main containers (EMPTY / LOW / MID / HIGH / MAX), valves, queue, failures

5

the whole relay mask (CMD_SET_RELAY_MASK, repeated every ~2 s)

6
what is really ON, and its watchdog state (about every 1 s)

7

every 1 s: BoxStatusPacket (step, time left, session counter), booked coins, heartbeat

8
the same broadcasts (the Online Server only listens)

9
settings: rules (coin rate, most coins), sensors (helmet distance, station timeout), auto-dry, drying seconds (CMD_SET_CONFIG)

10

settings of each container (levels, waiting times, retry) and the manual valve test

11

maintenance: relays by hand (CMD_SET_RELAY_MASK, 2-second safety)

12
every 10 s: totals, coin value, last 10 sessions (HubStatsPacket)

13
the same level broadcast (the Online Server only listens)

14

04 - Who talks to whom inside one box (messages over ESP-NOW)

## Jolly Helmet · system flowcharts · 05_refilling_station · made 2026-11-07

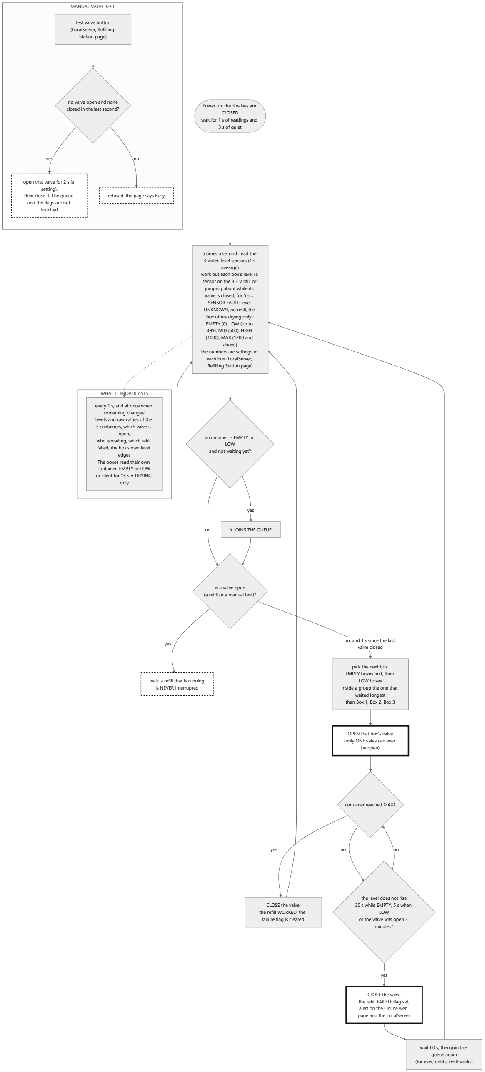
[picture p231: figure]
WHAT IT BROADCASTS; yes; no, and 1 s since the last; valve closed; MANUAL VALVE TEST; Test valve button (LocalServer, Refilling Station page); no valve open and none closed in the last second?; open that valve for 2 s (a setting), then close it. The queue and the flags are not touched; refused: the page says Busy; 3 s of quiet; 5 times a second: read the 3 water-level sensors (1 s average) work out each box's level (a; sensor on the 3.3 V rail, or jumping about while its valve is closed, for 5 s =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

Power on: the 3 valves are CLOSED wait for 1 s of readings and

SENSOR FAULT: level UNKNOWN, no refill, the

05 - The Refilling Station (one valve at a time, it works alone)

## Jolly Helmet · system flowcharts · 06_localserver · made 2026-11-07

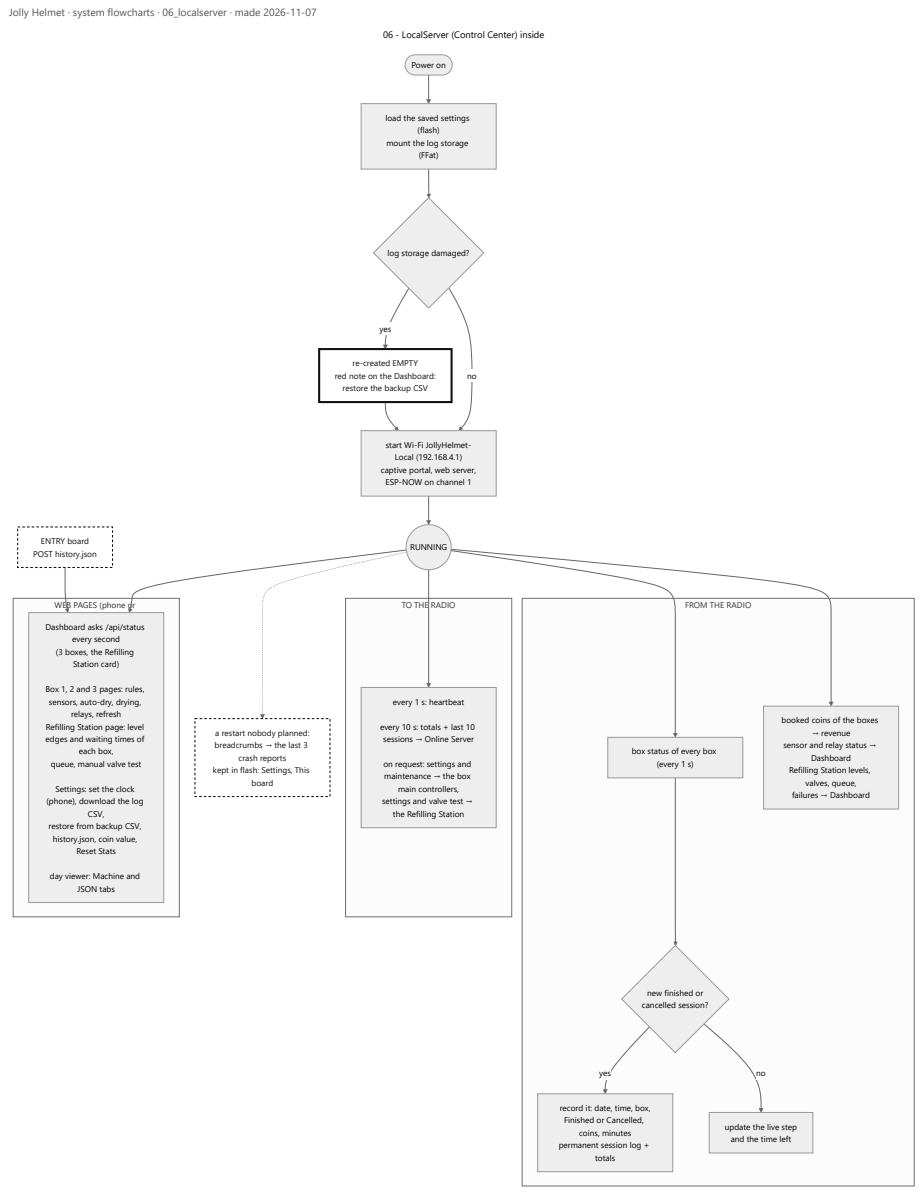
[picture p232: page 6]
TO THE RADIO; FROM THE RADIO; yes; Power on; RUNNING; totals; every 1 s: heartbeat; CSV,; board

06 - LocalServer (Control Center) inside

load the saved settings
(flash)
mount the log storage
(FFat)

log storage damaged?

re-created EMPTY
red note on the Dashboard:
restore the backup CSV

start Wi-Fi JollyHelmet-
Local (192.168.4.1)
captive portal, web server,
ESP-NOW on channel 1

ENTRY board
POST history.json

WEB PAGES (phone or
laptop)

Dashboard asks /api/status
every second
(3 boxes, the Refilling
Station card)

Box 1, 2 and 3 pages: rules,
sensors, auto-dry, drying,
relays, refresh
Refilling Station page: level
edges and waiting times of

every 10 s: totals + last 10
sessions → Online Server

booked coins of the boxes
→ revenue
sensor and relay status →
Dashboard
Refilling Station levels,
valves, queue,
failures → Dashboard

a restart nobody planned:
breadcrumbs → the last 3
crash reports
kept in flash: Settings, This

each box,
queue, manual valve test

box status of every box
(every 1 s)

on request: settings and
maintenance → the box
main controllers,
settings and valve test →
the Refilling Station

Settings: set the clock
(phone), download the log

restore from backup CSV,
history.json, coin value,
Reset Stats

day viewer: Machine and
JSON tabs

new finished or
cancelled session?

record it: date, time, box,
Finished or Cancelled,
coins, minutes
permanent session log +

update the live step
and the time left

## Jolly Helmet · system flowcharts · 07_online_server · made 2026-11-07

### Power on

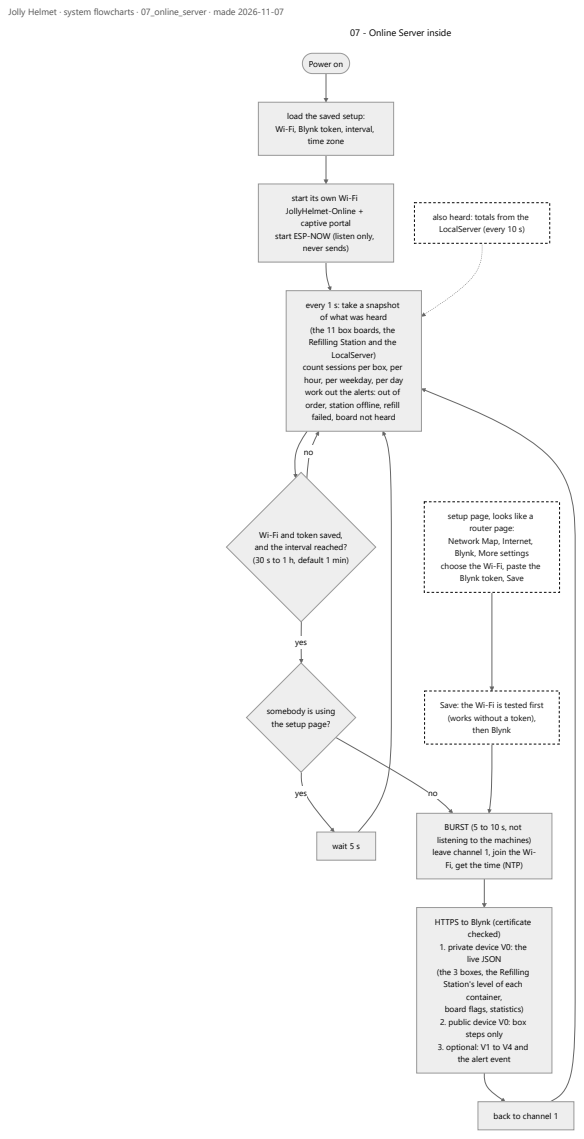
[picture p233: page 7]
yes; wait 5 s

07 - Online Server inside

load the saved setup:
Wi-Fi, Blynk token, interval,
time zone

start its own Wi-Fi
JollyHelmet-Online +
captive portal
start ESP-NOW (listen only,
never sends)

also heard: totals from the
LocalServer (every 10 s)

every 1 s: take a snapshot
of what was heard
(the 11 box boards, the
Refilling Station and the
LocalServer)
count sessions per box, per
hour, per weekday, per day
work out the alerts: out of
order, station offline, refill
failed, board not heard

setup page, looks like a
router page:
Network Map, Internet,
Blynk, More settings
choose the Wi-Fi, paste the
Blynk token, Save

Wi-Fi and token saved,
and the interval reached?
(30 s to 1 h, default 1 min)

somebody is using
the setup page?

Save: the Wi-Fi is tested first
(works without a token),
then Blynk

BURST (5 to 10 s, not
listening to the machines)
leave channel 1, join the Wi-
Fi, get the time (NTP)

HTTPS to Blynk (certificate

checked)
1. private device V0: the
live JSON
(the 3 boxes, the Refilling
Station's level of each
container,
board flags, statistics)
2. public device V0: box
steps only
3. optional: V1 to V4 and
the alert event

back to channel 1

## Jolly Helmet · system flowcharts · 08_blynk_and_web · made 2026-11-07

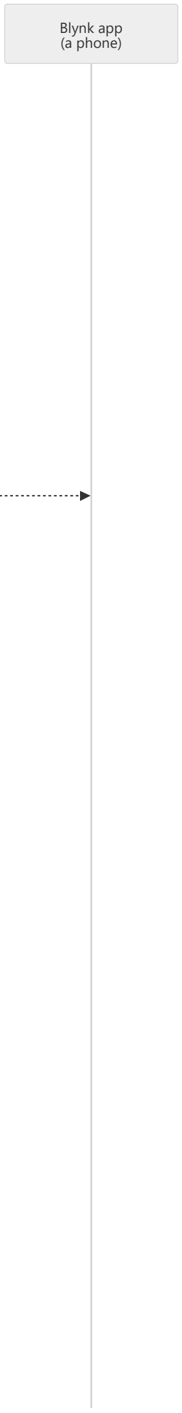
[picture p234: figure]
Blynk app (a phone)

## status.html (customer phone, QR sticker)

## Online web page, Monitor

(owner, technician) Online Server | Blynk cloud
loop | [every 1 min (30 s to 1 h)]

## LIVE / DELAYED / OLD DATA, each box drawn as a little machine, three level dials from the Refilling Station (red EMPTY or LOW, yellow MID, green HIGH and MAX, waiting or

refilling), network map,
Alerts with sounds,

## Reports

## loop [every 10 s, only while the tab is open and visible]

## TAPS = FREE, other steps = IN USE with minutes left, OUT OF ORDER, NO INFORMATION

loop | [every 30 s, only while the page is open and visible]

step and seconds left of each box opt [the customer types a nickname (only after the coins are in)] write V5: name, the box's session counter, time

## V5 is read back and shown on the box card

the nickname disappears when the box's session counter changes (the | cycle ended)

## write the private device V0 (live

JSON: the 3 boxes with step, time,

## coins, doors, helmet and relays, the Refilling Station's level of each main container with valve, waiting and

failed, board flags, statistics,

## revenue)

1

## write the public device V0 (per box: step, seconds left, main controller heard, session counter)

2

## a new alert: event 'alert' (out of order, Refilling Station offline, refill failed, board not heard)

3

## push notification (works with the page closed)

4

## HTTPS GET the private V0 (token typed once, kept in that browser)

5

## the live JSON

6

## HTTPS GET the public V0 (public token, in the QR code)

7

8

9

10

## 08 - Blynk and the web pages

## Jolly Helmet · system flowcharts · 09_complete_system · made 2026-11-07

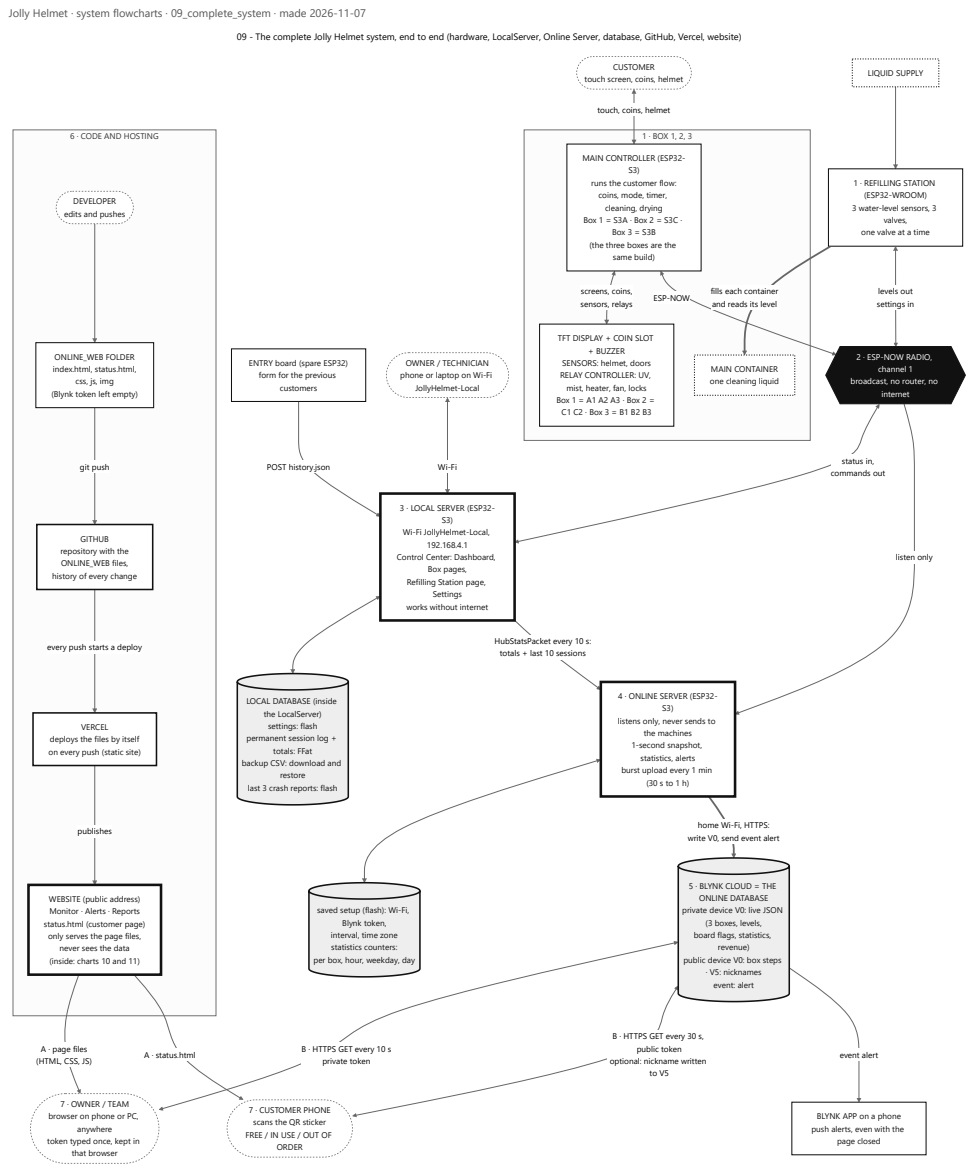
[picture p235: page 9]
6 · CODE AND HOSTING; 1 · BOX 1, 2, 3; screens, coins, sensors, relays; levels out settings in; POST history.json; status in, commands out; listen only; git push; publishes; A · status.html; B · HTTPS GET every 10 s; private token; event alert; MAIN CONTROLLER (ESP32- S3); LIQUID SUPPLY; 3 · LOCAL SERVER (ESP32- S3); 4 · ONLINE SERVER (ESP32- S3)

09 - The complete Jolly Helmet system, end to end (hardware, LocalServer, Online Server, database, GitHub, Vercel, website)

CUSTOMER
touch screen, coins, helmet

touch, coins, helmet

runs the customer flow:
coins, mode, timer,
cleaning, drying
Box 1 = S3A · Box 2 = S3C ·
Box 3 = S3B
(the three boxes are the
same build)

1 · REFILLING STATION
(ESP32-WROOM)
3 water-level sensors, 3
valves,
one valve at a time

DEVELOPER
edits and pushes

and reads its level ESP-NOW

fills each container

TFT DISPLAY + COIN SLOT
+ BUZZER
SENSORS: helmet, doors
RELAY CONTROLLER: UV,
mist, heater, fan, locks
Box 1 = A1 A2 A3 · Box 2 =
C1 C2 · Box 3 = B1 B2 B3

ONLINE_WEB FOLDER
index.html, status.html,
css, js, img
(Blynk token left empty)

2 · ESP-NOW RADIO,
channel 1
broadcast, no router, no
internet

ENTRY board (spare ESP32)
form for the previous
customers

OWNER / TECHNICIAN
phone or laptop on Wi-Fi
JollyHelmet-Local

MAIN CONTAINER
one cleaning liquid

Wi-Fi JollyHelmet-Local,
Control Center: Dashboard,
Box pages,
Refilling Station page,
Settings
works without internet

GITHUB
repository with the
ONLINE_WEB files,
history of every change

HubStatsPacket every 10 s:
totals + last 10 sessions

every push starts a deploy

LOCAL DATABASE (inside
the LocalServer)
settings: flash
permanent session log +
totals: FFat
backup CSV: download and

listens only, never sends to
the machines
1-second snapshot,
statistics, alerts
burst upload every 1 min

VERCEL
deploys the files by itself
on every push (static site)

restore
last 3 crash reports: flash

home Wi-Fi, HTTPS:
write V0, send event alert

5 · BLYNK CLOUD = THE
ONLINE DATABASE
private device V0: live JSON
(3 boxes, levels,
board flags, statistics,
revenue)

WEBSITE (public address)
Monitor · Alerts · Reports
status.html (customer page)
only serves the page files,
never sees the data
(inside: charts 10 and 11)

saved setup (flash): Wi-Fi,
Blynk token,
interval, time zone
statistics counters:
per box, hour, weekday, day

public device V0: box steps
· V5: nicknames
event: alert

B · HTTPS GET every 30 s,
public token
optional: nickname written

A · page files
(HTML, CSS, JS)

7 · OWNER / TEAM
browser on phone or PC,
anywhere
token typed once, kept in
that browser

7 · CUSTOMER PHONE
scans the QR sticker
FREE / IN USE / OUT OF
ORDER

BLYNK APP on a phone
push alerts, even with the
page closed

## Jolly Helmet · system flowcharts · 10_website_monitor · made 2026-11-07

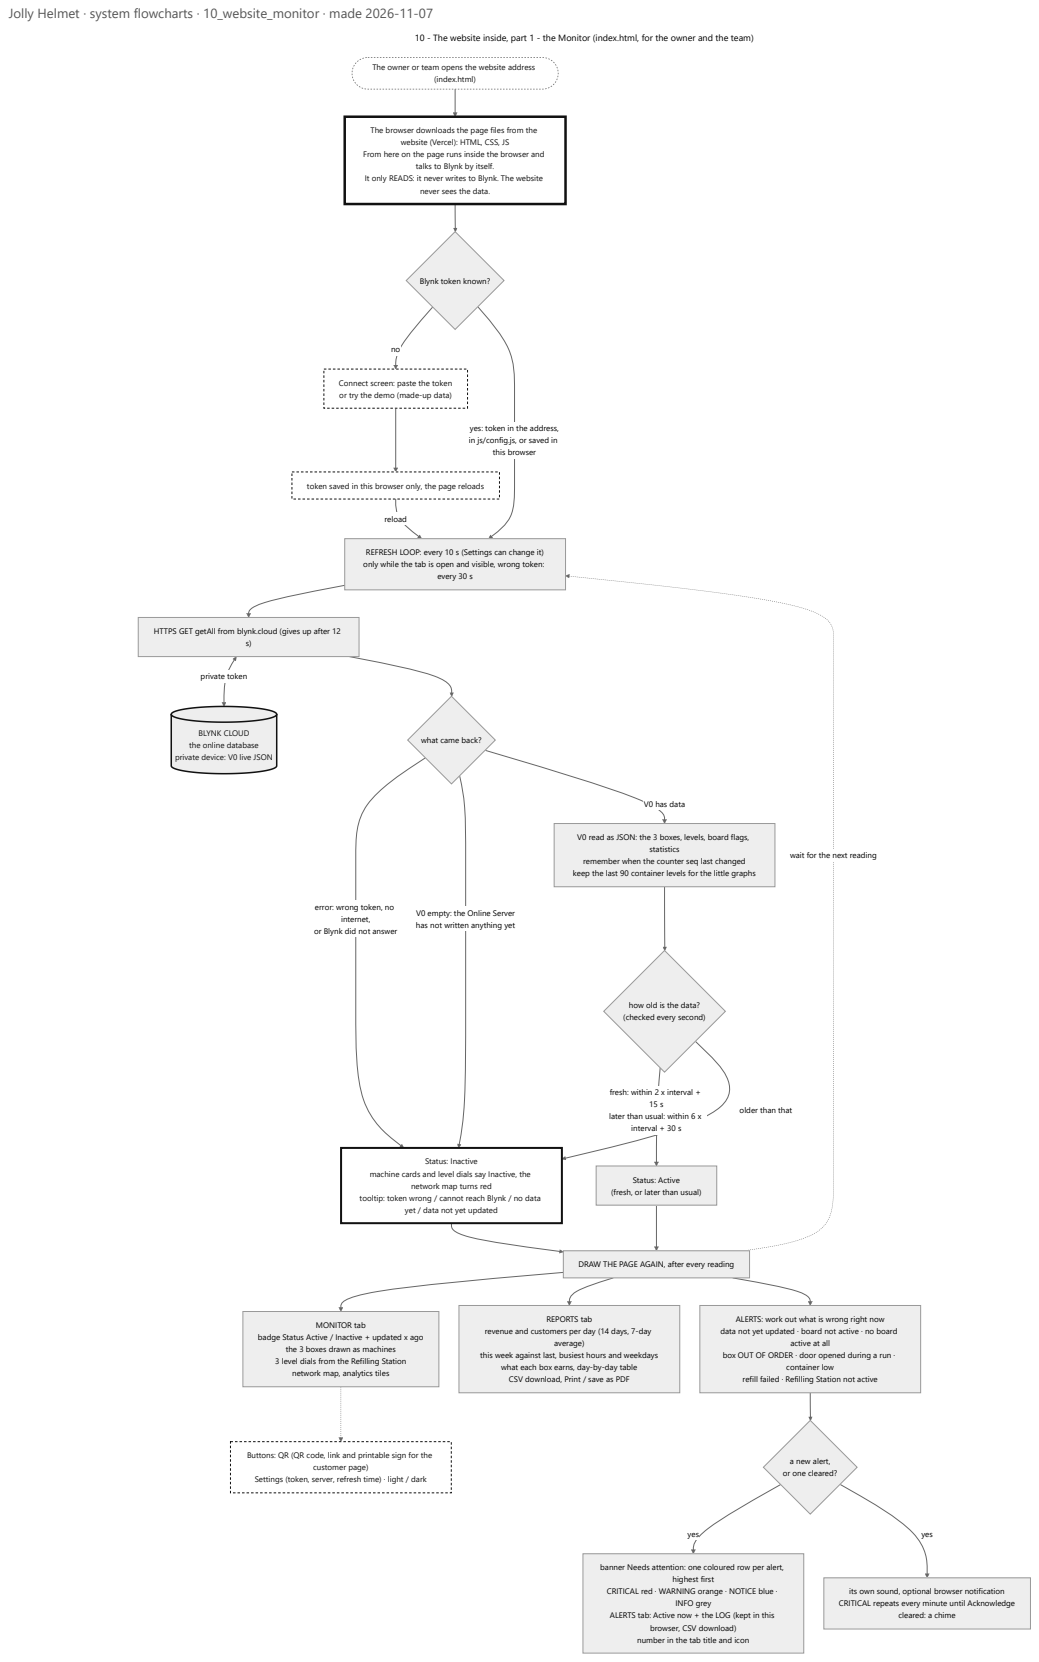
[picture p236: page 10]
reload; private token; V0 has data; yes; (index.html); every 30 s; statistics; MONITOR tab; REPORTS tab; average); container low; customer page); highest first; INFO grey; cleared: a chime

10 - The website inside, part 1 - the Monitor (index.html, for the owner and the team)

The owner or team opens the website address

The browser downloads the page files from the
website (Vercel): HTML, CSS, JS

From here on the page runs inside the browser and

talks to Blynk by itself.

It only READS: it never writes to Blynk. The website

never sees the data.

Blynk token known?

Connect screen: paste the token
or try the demo (made-up data)

yes: token in the address,
in js/config.js, or saved in
this browser

token saved in this browser only, the page reloads

REFRESH LOOP: every 10 s (Settings can change it)
only while the tab is open and visible, wrong token:

HTTPS GET getAll from blynk.cloud (gives up after 12

BLYNK CLOUD
the online database
private device: V0 live JSON

what came back?

V0 read as JSON: the 3 boxes, levels, board flags,

wait for the next reading

remember when the counter seq last changed
keep the last 90 container levels for the little graphs

error: wrong token, no
internet,
or Blynk did not answer

V0 empty: the Online Server
has not written anything yet

how old is the data?
(checked every second)

fresh: within 2 x interval +

later than usual: within 6 x
interval + 30 s

older than that

Status: Inactive machine cards and level dials say Inactive, the

network map turns red

Status: Active
(fresh, or later than usual)

tooltip: token wrong / cannot reach Blynk / no data

yet / data not yet updated

DRAW THE PAGE AGAIN, after every reading

ALERTS: work out what is wrong right now
data not yet updated · board not active · no board

badge Status Active / Inactive + updated x ago
the 3 boxes drawn as machines
3 level dials from the Refilling Station
network map, analytics tiles

revenue and customers per day (14 days, 7-day

active at all

this week against last, busiest hours and weekdays
what each box earns, day-by-day table
CSV download, Print / save as PDF

box OUT OF ORDER · door opened during a run ·

refill failed · Refilling Station not active

Buttons: QR (QR code, link and printable sign for the

a new alert,
or one cleared?

Settings (token, server, refresh time) · light / dark

banner Needs attention: one coloured row per alert,

CRITICAL red · WARNING orange · NOTICE blue ·

its own sound, optional browser notification
CRITICAL repeats every minute until Acknowledge

ALERTS tab: Active now + the LOG (kept in this

browser, CSV download)
number in the tab title and icon

## Jolly Helmet · system flowcharts · 11_website_customer · made 2026-11-07

no

yes: QR address,

### js/config.js, saved in the

phone,

### or a staff phone that has the private token

### public token

### no: an error, or the data is older than 4 min or 4 x interval + 1 min

### yes

### yes (only on a box that is running a cycle)

### write V5

### wait 30 s, then ask again

### A customer scans the QR sticker on the machine the address is status.html with the PUBLIC token in it

### The phone downloads the page files from the website (Vercel): HTML, CSS, JS From here on the page runs inside the phone and

talks to Blynk by itself.
The website never sees the data.

### public token known?

message: there is no information,

### please look at the machine itself

### BLYNK CLOUD the online database public device: V0 box steps, V5 nicknames holds only: free, busy or out of order

### every 30 s, only while the page is open and visible HTTPS GET the PUBLIC device: V0 (box steps) and V5 (nicknames)

### data usable?

every card: the information is not up to date,

### please look at the machine itself

### each box is classed from its step name board silent: NO INFORMATION · step OUT OF ORDER · step MAINTENANCE IDLE or TAPS: FREE · SELECT DRY ONLY: drying only SAFETY PAUSE: IN USE, paused · any other step: IN USE with minutes left

### three cards: Box 1, Box 2, Box 3 English / Filipino button, prices and the something-wrong line from js/config.js redrawn every second (updated x ago, minutes left)

### customer taps Add your name?

### the page writes ONE value, the only write of the whole website: V5 = the name + the box session counter + time (public token)

### everybody sees the name on that card, for example Maria's helmet it clears when the session counter changes (the cycle

ended),

### or after 45 minutes if there is no counter the customer's own phone says: your helmet is done

## 11 - The website inside, part 2 - the customer page (status.html, from the QR sticker)
