Mejez6603/Jolly-Helmet/ESP32 Project/FLOWCHART_SYSTEM/CLEANING_CYCLE_PART2/Customer_Cleaning_Cycle_Part2.pdf

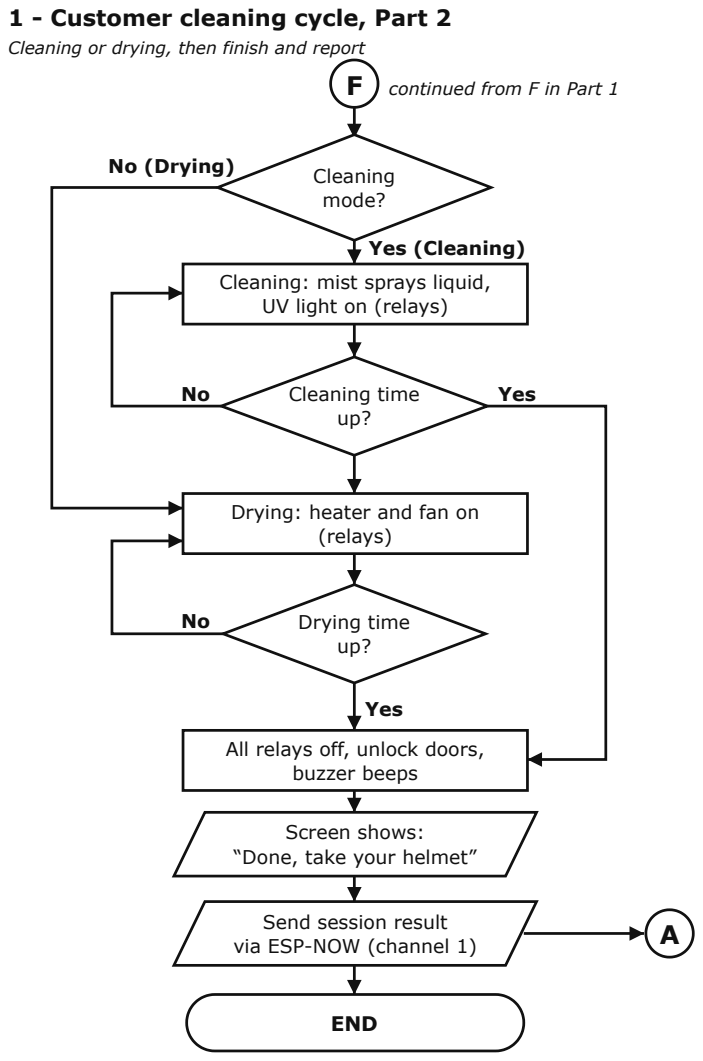
[picture p237: page 1]
Cleaning mode?; No (Drying); Yes (Cleaning); Cleaning time up?; Yes; (relays); Drying time up?; via ESP-NOW (channel 1); END

1 - Customer cleaning cycle, Part 2
Cleaning or drying, then finish and report

F continued from F in Part 1

Cleaning: mist sprays liquid,
UV light on (relays)

Drying: heater and fan on

All relays off, unlock doors,
buzzer beeps

Screen shows:
“Done, take your helmet”

Send session result
