Mejez6603/Jolly-Helmet/ESP32 Project/FLOWCHART_SYSTEM/DFD_LEVEL1/JollyHelmet_DFD_Level1.pdf

# JOLLY HELMET

### Data flow diagram (Level 1)

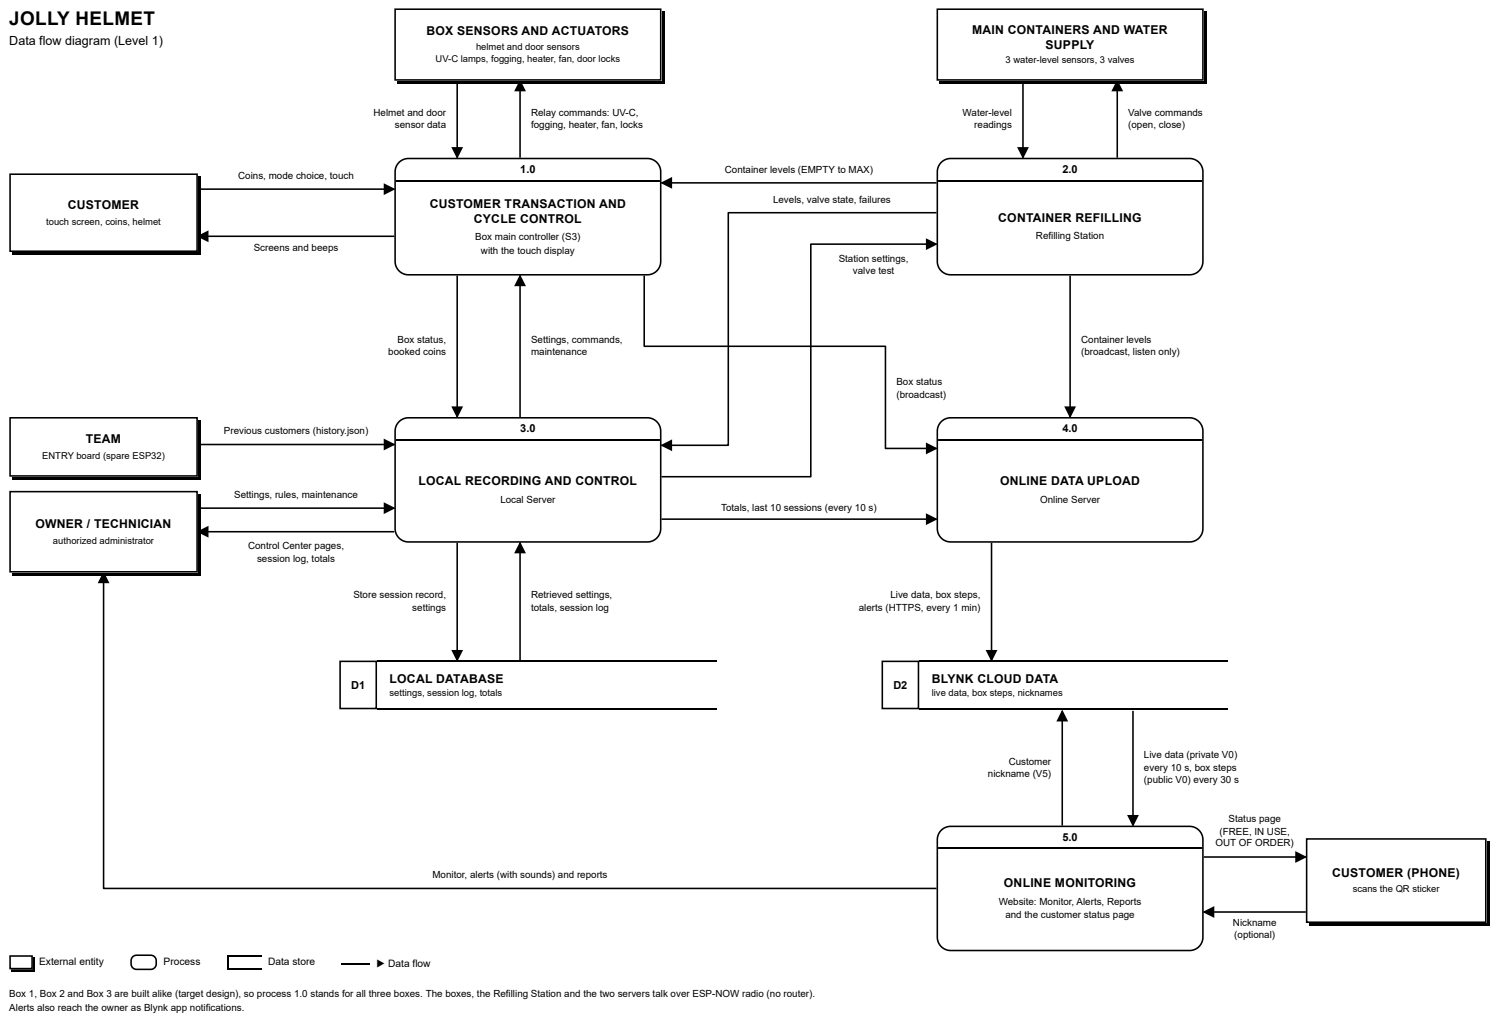
[picture p239: page 1]
SUPPLY; TEAM; OWNER / TECHNICIAN; authorized administrator; CONTAINER REFILLING; Refilling Station; Local Server; Online Server; LOCAL DATABASE; BLYNK CLOUD DATA; Water-level readings; Valve commands (open, close); Station settings, valve test; Box status (broadcast); Box status, booked coins; Settings, commands, maintenance; settings; Customer nickname (V5); Nickname (optional); External entity; Process; Data store; ▶ Data flow

MAIN CONTAINERS AND WATER

BOX SENSORS AND ACTUATORS

helmet and door sensors

UV-C lamps, fogging, heater, fan, door locks

3 water-level sensors, 3 valves

Helmet and door
sensor data

Relay commands: UV-C,
fogging, heater, fan, locks

Container levels (EMPTY to MAX)

Coins, mode choice, touch

CUSTOMER
touch screen, coins, helmet

CUSTOMER TRANSACTION AND

Levels, valve state, failures

CYCLE CONTROL
Box main controller (S3)
with the touch display

Screens and beeps

Container levels
(broadcast, listen only)

Previous customers (history.json)

ENTRY board (spare ESP32)

LOCAL RECORDING AND CONTROL

ONLINE DATA UPLOAD

Settings, rules, maintenance

Totals, last 10 sessions (every 10 s)

Control Center pages,
session log, totals

Store session record,

Retrieved settings,
totals, session log

Live data, box steps,
alerts (HTTPS, every 1 min)

settings, session log, totals

live data, box steps, nicknames

Live data (private V0)
every 10 s, box steps
(public V0) every 30 s

Status page
(FREE, IN USE,
OUT OF ORDER)

Monitor, alerts (with sounds) and reports

CUSTOMER (PHONE)
scans the QR sticker

ONLINE MONITORING
Website: Monitor, Alerts, Reports
and the customer status page

Box 1, Box 2 and Box 3 are built alike (target design), so process 1.0 stands for all three boxes. The boxes, the Refilling Station and the two servers talk over ESP-NOW radio (no router).
Alerts also reach the owner as Blynk app notifications.
