Mejez6603/Jolly-Helmet/ESP32 Project/FLOWCHART_SYSTEM/IPO_FRAMEWORK_ICONS/JollyHelmet_Framework_Icons.pdf

## Figure 2 Conceptual Framework of the study

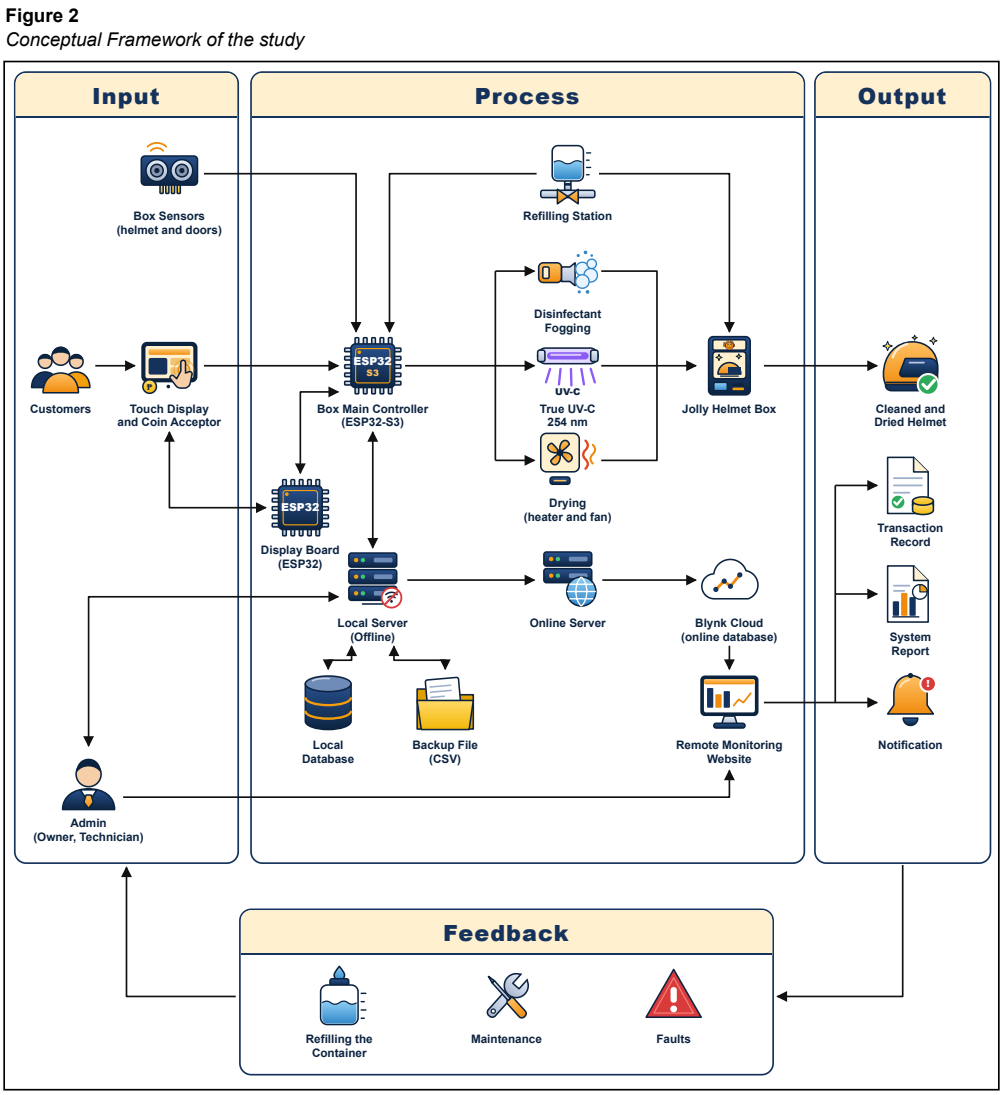
[picture p240: page 1]
Input; Process; Output; Feedback; Customers; Admin (Owner, Technician); ESP32 S3; ESP32; Display Board (ESP32); Refilling Station; Disinfectant Fogging; UV-C True UV-C 254 nm; Local Server (Offline); Local Database; CSV; Backup File (CSV); Online Server; Blynk Cloud; (online database); Remote Monitoring Website; Cleaned and Dried Helmet; Transaction Record; System Report; Notification; Refilling the Container; Maintenance; Faults

Box Sensors
(helmet and doors)

Touch Display
and Coin Acceptor

Box Main Controller
(ESP32-S3)

Jolly Helmet Box

Drying
(heater and fan)
