Mejez6603/Jolly-Helmet/ESP32 Project/FLOWCHART_SYSTEM/REFILLING_STATION_CHART/Refilling_Station_Chart.pdf

## 3 - Refilling station

C

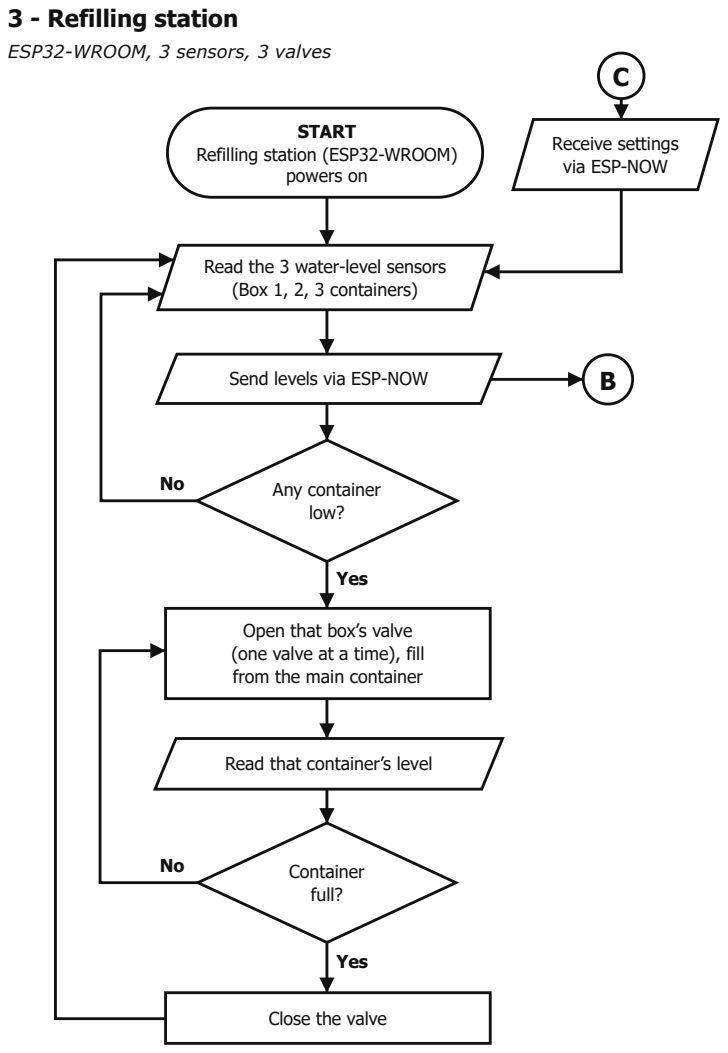
[picture p241: page 1]
START; powers on; Send levels via ESP-NOW; Any container low?; Yes; Container full?

ESP32-WROOM, 3 sensors, 3 valves

Receive settings
via ESP-NOW

Refilling station (ESP32-WROOM)

Read the 3 water-level sensors
(Box 1, 2, 3 containers)

Open that box’s valve
(one valve at a time), fill
from the main container

Read that container’s level

Close the valve
