Mejez6603/Jolly-Helmet/ESP32 Project/ESP32_A3/ESP32_A3.ino

// =====================================================================
//  NODE A3 - BOX 1 RELAY CONTROLLER                       (ESP32, core 3.3.7)
//  Created 2026-10-02.  NOT YET COMPILED OR FLASHED - written without a compiler, bench-test first
//  (ESP32_A3_BENCH_TEST fakes S3A and A2 so this board can be exercised on its own).
//
//  What it is: the one board that owns EVERY relay-driven output of Box 1 (12 channels). It has no
//  sensors and no screen. S3A (the brain) sends it the whole 12-bit relay mask with
//  CMD_SET_RELAY_MASK; A3 just applies it. A2 is sensing only once A3 exists.
//
//  What it adds on top of "just apply the mask":
//   1. BOOT-SAFE: every relay pin is driven to its inactive level (HIGH) before it becomes an
//      output, and everything stays OFF until S3A has said otherwise.
//   2. SOFT SWITCHING: relays turning OFF switch at once; relays turning ON are staggered
//      (RELAY_ON_STAGGER_MS apart) so six loads never start in the same millisecond (the same inrush
//      that makes the TFT go white when a lock engages).
//   3. S3A-LOSS WATCHDOG (moved here from A2): no sign of S3A for 15 s -> everything is forced OFF
//      (humidifiers, UV, coin power, drain pumps, panel/back/ACS locks). The one exception: if a
//      helmet is trapped in a closed enclosure, the ENCLOSURE lock is released (see below).
//      Because A3 has no sensors, it listens to A2's broadcast telemetry for the door and helmet.
//   4. STATUS: broadcasts an A3StatusPacket once a second (applied mask + watchdog state).
//
//  "Proof of life" from S3A = CMD_HEARTBEAT with subIndex DEVICE_S3A, or any command addressed to
//  DEVICE_A3 (S3A re-sends the mask every ~2 s, so one lost heartbeat is harmless).
//
//  Trapped-helmet release (only while orphaned):
//   - A2 telemetry fresh, door CLOSED for 2 ticks and helmet inside (0 < dist < 15 cm)
//         -> enclosure lock unlocked; released again once the door is confirmed OPEN (2 ticks).
//   - A2 telemetry missing (we cannot see the door at all) -> ONE short unlock window of
//         UNLOCK_BLIND_WINDOW_MS (15 s - nobody is watching the coil), if UNLOCK_WHEN_A2_UNKNOWN is true.
//   - A solenoid is never held energized forever: UNLOCK_WINDOW_MS on, UNLOCK_REST_MS off, and at
//     most UNLOCK_MAX_WINDOWS windows until the door has been seen open or S3A comes back.
//
//  DEPENDS ON: the sensors-only A2 (ESP32_A2.ino, Phase 3) broadcasting A2SensorPacket with doorEnclosure
//  (true = OPEN) and usHelmetCm. The legacy relay-carrying A2 (TelemetryPacket) is NOT understood here.
//  A2 also sends an extra packet the moment the door changes, so the 2-tick confirm is "2 reports".
//  NOTE: pins 16/17 are unusable on ESP32-WROVER (PSRAM) - this board is a plain WROOM DevKit.
//
//  LEGACY BRIDGE (LEGACY_S3A_BRIDGE, below): lets the CURRENT S3A / LocalServer drive this board as if it
//  were the old relay A2, so A2 + A3 can replace the old A2 in the customer's box before the new S3A exists.
// =====================================================================
#include <WiFi.h>
#include <esp_wifi.h>
#include <esp_now.h>
#include "Shared_Common.h"

// ---------------------------------------------------------------------
// TEMPORARY LEGACY BRIDGE (added 2026-10-02 so A2+A3 can go straight into the customer's box)
// The S3A flashed on the box today does not know A3: it sends the OLD per-relay command
// CMD_SET_RELAY to DEVICE_A2 (index 0 enclosure lock, 1 panel lock, 2 backdoor lock, 3 humidifier,
// 4 UV light). With the bridge ON, A3 obeys those and translates them to its own relays:
//   0,1,2 -> enclosure / panel / backdoor lock (same bit numbers)
//   3     -> LEGACY_MIST_MASK  (all three humidifiers = the new design's BALANCED set; the old mist was
//                           the mixed product, which is the closest thing to "everything")
//   4     -> LEGACY_UV_MASK    (UV 1 + UV 2 together)
// COIN POWER: the old S3A knows nothing about the coin-acceptor relay, but it broadcasts its current
// state (BoxStatusPacket) once a second. In bridge mode the acceptor is powered ONLY while S3A is in
// STATE_INSERT_COIN or STATE_CLEANING (the two places the designed steps turn Coin ON - cleaning lets the
// customer add time) and only while that status is fresh; in every other state, and if the status goes
// silent, it is OFF. The moment a CMD_SET_RELAY_MASK arrives (the new S3A, Phase 5) the bridge switches
// itself off. Set LEGACY_S3A_BRIDGE to 0 to remove it entirely.
// ---------------------------------------------------------------------
#define LEGACY_S3A_BRIDGE 1
#define LEGACY_MIST_MASK  (A3_MASK_MIST)
#define LEGACY_UV_MASK    (A3_MASK_UV)
const uint32_t LEGACY_STATUS_STALE_MS = 3500; // S3A broadcasts its state every 1 s; older than this = unknown = coin OFF

// ---------------------------------------------------------------------
// Relay pins - index = A3RelayIndex = bit position in the mask. Active-LOW: LOW = ON/energized.
// GPIO0/1/2/3/5/12/14/15 are deliberately NOT used (they pulse or strap at boot).
// ---------------------------------------------------------------------
#define RELAY_ACTIVE   LOW
#define RELAY_INACTIVE HIGH

const uint8_t A3_PINS[A3_RELAY_COUNT] = {
    4,   // 0  ENCLOSURE LOCK
    16,  // 1  PANEL LOCK
    17,  // 2  BACKDOOR LOCK
    18,  // 3  HUMIDIFIER 1 (Alcohol)
    27,  // 4  UV 1
    19,  // 5  HUMIDIFIER 2 (Scented)
    25,  // 6  HUMIDIFIER 3 (Both)
    21,  // 7  UV 2
    33,  // 8  DRAIN PUMP 1 (Alcohol)  - was GPIO13 until 2026-10-02 (it stayed ON with no command)
    32,  // 9  DRAIN PUMP 2 (Scented)
    23,  // 10 ACS DOOR LOCK
    22   // 11 COIN POWER
};

const char* const A3_NAMES[A3_RELAY_COUNT] = {
    "ENCLOSURE LOCK", "PANEL LOCK", "BACKDOOR LOCK", "HUMIDIFIER 1 (ALC)",
    "UV 1", "HUMIDIFIER 2 (SCN)", "HUMIDIFIER 3 (BOTH)", "UV 2",
    "DRAIN PUMP 1", "DRAIN PUMP 2", "ACS DOOR LOCK", "COIN POWER"
};

// ---------------------------------------------------------------------
// Tunables
// ---------------------------------------------------------------------
const uint32_t ORPHANED_TIMEOUT_MS    = 15000; // no S3A for this long -> watchdog takes over (same 15 s as A1/A2)
const uint32_t A2_STALE_MS            = 5000;  // A2 telemetry older than this = A2 unknown
const float    HELMET_PRESENT_CM      = 15.0f; // A2's own "helmet inside" cutoff (0 = no echo = not present)
const uint32_t UNLOCK_WINDOW_MS       = 60000; // max time the enclosure solenoid stays energized per window (A2 sees door shut + helmet inside)
const uint32_t UNLOCK_BLIND_WINDOW_MS = 15000; // same, but when A2 is silent too and A3 cannot see the door at all
const uint32_t UNLOCK_REST_MS         = 5000;  // pause between windows
const uint8_t  UNLOCK_MAX_WINDOWS     = 3;     // windows per episode while the door is known to be shut
const uint8_t  CONFIRM_TICKS          = 2;     // A2 reports once a second; 2 in a row = not reed-switch bounce
const uint32_t RELAY_ON_STAGGER_MS    = 25;    // gap between two relays turning ON
const uint32_t STATUS_INTERVAL_MS     = 1000;
const uint32_t SERIAL_SUMMARY_MS      = 5000;
#define UNLOCK_WHEN_A2_UNKNOWN true            // true = if A2 is silent, still give one unlock window

// ---------------------------------------------------------------------
// State shared between the ESP-NOW receive callback (WiFi task) and loop() - guarded by rxMux.
// The callback only RECORDS; loop() is the only place that touches the relay pins.
// ---------------------------------------------------------------------
static portMUX_TYPE rxMux = portMUX_INITIALIZER_UNLOCKED;
volatile uint32_t lastSeenS3A = 0;     // millis() of the last proof of life from S3A
volatile uint16_t cmdMask     = 0;     // the relay mask S3A last asked for
volatile bool     legacyMode  = false; // true once the OLD S3A has spoken to us (see LEGACY_S3A_BRIDGE)
volatile uint8_t  s3aState    = 255;   // S3A's MachineState from its BoxStatusPacket (255 = never heard) - bridge only
volatile uint32_t s3aStateMs  = 0;     // millis() when that state was received
volatile uint32_t a2Seq       = 0;     // counts A2 telemetry packets (0 = never heard)
volatile uint32_t a2LastMs    = 0;     // millis() of the last A2 telemetry
volatile bool     a2DoorOpen  = false; // A2: enclosure door OPEN (true) / CLOSED (false)
volatile float    a2Helmet    = 0.0f;  // A2: helmet distance in cm

// loop()-only state
uint16_t appliedMask      = 0;         // what the pins are doing right now
uint32_t lastRelayOnMs    = 0;
bool     orphaned         = false;
uint32_t lastA2SeqSeen    = 0;
uint8_t  doorClosedTicks  = 0;
uint8_t  doorOpenTicks    = 0;
bool     wdLockOn         = false;     // watchdog is holding the enclosure unlocked
uint32_t wdLockSinceMs    = 0;
uint32_t wdWindowMs       = UNLOCK_WINDOW_MS; // length of the window in progress (normal or blind)
uint32_t wdRestUntilMs    = 0;
uint8_t  wdWindows        = 0;
uint32_t lastStatusMs     = 0;
uint32_t lastSummaryMs    = 0;

// ---------------------------------------------------------------------
// ESP-NOW (core 3.3.7 callback signatures, same as A2)
// ---------------------------------------------------------------------
void onDataSent(const wifi_tx_info_t *tx_info, esp_now_send_status_t status) {
    if (!tx_info) return;
}

void onDataRecv(const esp_now_recv_info_t *info, const uint8_t *incomingData, int len) {
    if (!info || !info->src_addr || !incomingData || len <= 0) return;

    if (len == (int)sizeof(CommandPacket)) {
        CommandPacket cmd;
        memcpy(&cmd, incomingData, sizeof(CommandPacket));

        // Broadcast heartbeat (targetDeviceID 0) - meant for every node, checked before the filter.
        if (cmd.commandID == CMD_HEARTBEAT) {
            if (cmd.subIndex == DEVICE_S3A) {
                portENTER_CRITICAL(&rxMux);
                lastSeenS3A = millis();
                portEXIT_CRITICAL(&rxMux);
            }
            return;
        }

#if LEGACY_S3A_BRIDGE
        // The old S3A (and the old LocalServer dashboard) address relays to A2 with CMD_SET_RELAY.
        if (cmd.targetDeviceID == DEVICE_A2 && cmd.commandID == CMD_SET_RELAY) {
            if (cmd.subIndex < 5) {
                uint16_t bits = 0;
                switch (cmd.subIndex) {
                    case 0: bits = A3_BIT(A3_RELAY_ENCLOSURE_LOCK); break;
                    case 1: bits = A3_BIT(A3_RELAY_PANEL_LOCK);     break;
                    case 2: bits = A3_BIT(A3_RELAY_BACKDOOR_LOCK);  break;
                    case 3: bits = LEGACY_MIST_MASK;                break;
                    default: bits = LEGACY_UV_MASK;                 break;
                }
                portENTER_CRITICAL(&rxMux);
                if (cmd.state == 1) cmdMask = (uint16_t)(cmdMask | bits);
                else                cmdMask = (uint16_t)(cmdMask & (uint16_t)(~bits));
                legacyMode  = true;
                lastSeenS3A = millis();
                portEXIT_CRITICAL(&rxMux);
            }
            return;
        }
#endif

        if (cmd.targetDeviceID != DEVICE_A3) return; // traffic for another node

        if (cmd.commandID == CMD_SET_RELAY_MASK) {
            portENTER_CRITICAL(&rxMux);
            cmdMask     = (uint16_t)(cmd.param16 & A3_MASK_ALL);
            legacyMode  = false;             // the new S3A is talking - the bridge steps aside
            lastSeenS3A = millis();
            portEXIT_CRITICAL(&rxMux);
        } else if (cmd.commandID == CMD_SET_RELAY) {
            // Single-relay command (bench / manual use). Edits S3A's mask in place.
            if (cmd.subIndex < A3_RELAY_COUNT) {
                portENTER_CRITICAL(&rxMux);
                uint16_t m = cmdMask;
                if (cmd.state == 1) m = (uint16_t)(m | A3_BIT(cmd.subIndex));
                else                m = (uint16_t)(m & (uint16_t)(~A3_BIT(cmd.subIndex)));
                cmdMask     = m;
                lastSeenS3A = millis();
                portEXIT_CRITICAL(&rxMux);
            }
        }
        return;
    }

#if LEGACY_S3A_BRIDGE
    if (len == (int)sizeof(BoxStatusPacket)) {
        BoxStatusPacket b;
        memcpy(&b, incomingData, sizeof(BoxStatusPacket));
        if (b.deviceID != DEVICE_S3A) return;   // Box 2's S3C sends the same packet - ignore it
        portENTER_CRITICAL(&rxMux);
        s3aState   = b.machineState;
        s3aStateMs = millis();
        portEXIT_CRITICAL(&rxMux);
        return;
    }
#endif

    if (len == (int)sizeof(A2SensorPacket)) {
        A2SensorPacket t;
        memcpy(&t, incomingData, sizeof(A2SensorPacket));
        if (t.deviceID != DEVICE_A2) return;
        portENTER_CRITICAL(&rxMux);
        a2DoorOpen = t.doorEnclosure;
        a2Helmet   = t.usHelmetCm;
        a2LastMs   = millis();
        a2Seq      = a2Seq + 1;
        portEXIT_CRITICAL(&rxMux);
    }
}

// ---------------------------------------------------------------------
// Relay driving
// ---------------------------------------------------------------------
void driveRelay(uint8_t index, bool on) {
    if (index >= A3_RELAY_COUNT) return;
    digitalWrite(A3_PINS[index], on ? RELAY_ACTIVE : RELAY_INACTIVE);
    if (on) appliedMask = (uint16_t)(appliedMask | A3_BIT(index));
    else    appliedMask = (uint16_t)(appliedMask & (uint16_t)(~A3_BIT(index)));
    Serial.printf("[A3] %-20s (GPIO %2d) -> %s\n", A3_NAMES[index], A3_PINS[index], on ? "ON" : "OFF");
}

// Turn-offs happen immediately; turn-ons one at a time, RELAY_ON_STAGGER_MS apart, lowest bit first
// (locks first, coin power last).
void applyRelays(uint16_t target) {
    target = (uint16_t)(target & A3_MASK_ALL);

    uint16_t offs = (uint16_t)(appliedMask & (uint16_t)(~target));
    for (uint8_t i = 0; i < A3_RELAY_COUNT; i++) {
        if (offs & A3_BIT(i)) driveRelay(i, false);
    }

    uint16_t ons = (uint16_t)(target & (uint16_t)(~appliedMask));
    if (ons && (millis() - lastRelayOnMs >= RELAY_ON_STAGGER_MS)) {
        for (uint8_t i = 0; i < A3_RELAY_COUNT; i++) {
            if (ons & A3_BIT(i)) {
                driveRelay(i, true);
                lastRelayOnMs = millis();
                break;
            }
        }
    }
}

void resetWatchdogLock() {
    wdLockOn      = false;
    wdWindows     = 0;
    wdRestUntilMs = 0;
}

void setup() {
    // 1. FIRST THING: every relay pin to its inactive level, before it becomes an output, so the
    //    relays never see a LOW pulse while the pin is being configured.
    for (uint8_t i = 0; i < A3_RELAY_COUNT; i++) {
        digitalWrite(A3_PINS[i], RELAY_INACTIVE);
        pinMode(A3_PINS[i], OUTPUT);
        digitalWrite(A3_PINS[i], RELAY_INACTIVE);
    }

    Serial.begin(115200);
    delay(100);
    Serial.println("\n=======================================================");
    Serial.println("   NODE A3: BOX 1 RELAY CONTROLLER (CORE 3.3.7)");
    Serial.println("=======================================================");
    Serial.println("[A3] RELAYS: all 12 outputs forced HIGH (OFF / locked) before anything else.");

    // 2. Wi-Fi channel 1 + ESP-NOW broadcast peer - identical to A2 / the other nodes.
    WiFi.mode(WIFI_STA);
    WiFi.setSleep(false); // modem sleep makes ESP-NOW reception drop out for seconds at a time
    WiFi.disconnect();
    esp_wifi_set_channel(ESPNOW_WIFI_CHANNEL, WIFI_SECOND_CHAN_NONE);

    if (esp_now_init() != ESP_OK) {
        Serial.println("[A3] ESP-NOW: init failed - restarting in 3 s (relays stay OFF).");
        delay(3000);
        ESP.restart();
    }
    esp_now_register_send_cb(onDataSent);
    esp_now_register_recv_cb(onDataRecv);

    esp_now_peer_info_t peerInfo;
    memset(&peerInfo, 0, sizeof(esp_now_peer_info_t));
    memcpy(peerInfo.peer_addr, BROADCAST_MAC, 6);
    peerInfo.channel = ESPNOW_WIFI_CHANNEL;
    peerInfo.encrypt = false;
    esp_now_add_peer(&peerInfo);
    Serial.println("[A3] ESP-NOW: channel 1 broadcast peer registered.");

    // S3A gets the full 15 s from power-up to introduce itself before the watchdog may fire.
    portENTER_CRITICAL(&rxMux);
    lastSeenS3A = millis();
    portEXIT_CRITICAL(&rxMux);
    Serial.println("[A3] READY - waiting for S3A (CMD_SET_RELAY_MASK / heartbeat).");
}

void loop() {
    // ---- 1. Snapshot everything the callback may have changed ----
    uint32_t lastS3A, a2Last, seq;
    uint16_t wantMask;
    bool     doorOpen;
    bool     legacy;
    uint8_t  sState;
    uint32_t sStateMs;
    float    helmet;
    portENTER_CRITICAL(&rxMux);
    lastS3A  = lastSeenS3A;
    wantMask = cmdMask;
    legacy   = legacyMode;
    sState   = s3aState;
    sStateMs = s3aStateMs;
    seq      = a2Seq;
    a2Last   = a2LastMs;
    doorOpen = a2DoorOpen;
    helmet   = a2Helmet;
    portEXIT_CRITICAL(&rxMux);
    // millis() is read AFTER the snapshot on purpose: every timestamp above is then <= now, so the
    // unsigned subtractions below can never wrap into a huge "age" (the race A1/A2 had to fix).
    uint32_t now = millis();

    // ---- 2. Orphan state (S3A silent for ORPHANED_TIMEOUT_MS) ----
    bool orphanedNow = (now - lastS3A) > ORPHANED_TIMEOUT_MS;
    if (orphanedNow && !orphaned) {
        orphaned = true;
        resetWatchdogLock();
        // Forget the old mask: when S3A comes back it must send a fresh one; a stale "UV ON" must
        // never be re-applied just because the heartbeat returned.
        portENTER_CRITICAL(&rxMux);
        cmdMask = 0;
        portEXIT_CRITICAL(&rxMux);
        Serial.println("[A3] WATCHDOG: no sign of S3A for 15 s -> forcing all outputs OFF.");
    } else if (!orphanedNow && orphaned) {
        orphaned = false;
        resetWatchdogLock();
        Serial.println("[A3] WATCHDOG: S3A is back - normal operation (waiting for a fresh relay mask).");
    }

    // ---- 3. A2 door/helmet ticks (A2 reports once a second) ----
    if (seq != lastA2SeqSeen) {
        lastA2SeqSeen = seq;
        if (doorOpen) {
            if (doorOpenTicks < 100) doorOpenTicks++;
            doorClosedTicks = 0;
        } else {
            if (doorClosedTicks < 100) doorClosedTicks++;
            doorOpenTicks = 0;
        }
    }
    bool a2Known       = (seq != 0) && ((now - a2Last) <= A2_STALE_MS);
    bool helmetInside  = a2Known && (helmet > 0.0f) && (helmet < HELMET_PRESENT_CM);
    bool doorShut      = a2Known && !doorOpen && (doorClosedTicks >= CONFIRM_TICKS);
    bool doorSeenOpen  = a2Known && doorOpen && (doorOpenTicks >= CONFIRM_TICKS);

    // ---- 4. Enclosure hold-open while orphaned ----
    if (orphaned) {
        if (wdLockOn) {
            if (doorSeenOpen) {
                wdLockOn      = false;       // door confirmed open - stop energizing the solenoid
                wdWindows     = 0;           // a later re-closed door with the helmet still in = new episode
                wdRestUntilMs = now;
                Serial.println("[A3] WATCHDOG: door confirmed open - releasing the enclosure lock.");
            } else if (now - wdLockSinceMs >= wdWindowMs) {
                wdLockOn      = false;       // cap reached - let the coil rest
                wdRestUntilMs = now + UNLOCK_REST_MS;
                Serial.println("[A3] WATCHDOG: unlock window used up - resting the solenoid.");
            }
        } else if (now >= wdRestUntilMs) {
            bool want = false;
            uint8_t maxWindows = UNLOCK_MAX_WINDOWS;
            if (a2Known) {
                want = doorShut && helmetInside;
            } else if (UNLOCK_WHEN_A2_UNKNOWN) {
                want = true;     // blind: cannot see the door, give the customer one chance
                maxWindows = 1;
            }
            if (want && wdWindows < maxWindows) {
                wdLockOn       = true;
                wdLockSinceMs  = now;
                wdWindowMs     = a2Known ? UNLOCK_WINDOW_MS : UNLOCK_BLIND_WINDOW_MS;
                wdWindows++;
                Serial.printf("[A3] WATCHDOG: enclosure UNLOCKED for a possibly trapped helmet (window %u, A2 %s).\n",
                              (unsigned)wdWindows, a2Known ? "sees door shut + helmet inside" : "unknown");
            }
        }
    }

    // ---- 5. Decide and apply the relay pattern ----
    uint16_t target;
    if (!orphaned) {
        target = (uint16_t)(wantMask & A3_MASK_ALL);
        // The old S3A cannot switch the coin-acceptor power relay, so the bridge does it from S3A's
        // broadcast state: powered only while coins are actually asked for, and only on fresh info.
        if (legacy) {
            bool statusFresh = (sStateMs != 0) && ((now - sStateMs) <= LEGACY_STATUS_STALE_MS);
            bool coinsAsked  = (sState == STATE_INSERT_COIN) || (sState == STATE_CLEANING);
            if (statusFresh && coinsAsked) target = (uint16_t)(target | A3_BIT(A3_RELAY_COIN_POWER));
            else                           target = (uint16_t)(target & (uint16_t)(~A3_BIT(A3_RELAY_COIN_POWER)));
        }
    } else {
        target = wdLockOn ? (uint16_t)A3_BIT(A3_RELAY_ENCLOSURE_LOCK) : (uint16_t)0;
    }
    applyRelays(target);

    // ---- 6. Status broadcast + occasional serial summary ----
    if (now - lastStatusMs >= STATUS_INTERVAL_MS) {
        lastStatusMs = now;
        A3StatusPacket st;
        memset(&st, 0, sizeof(st));
        st.deviceID      = DEVICE_A3;
        st.relayMask     = appliedMask;
        st.orphaned      = orphaned;
        st.watchdogState = !orphaned ? 0 : (wdLockOn ? 2 : 1);
        esp_now_send(BROADCAST_MAC, (uint8_t*)&st, sizeof(A3StatusPacket));
    }
    if (now - lastSummaryMs >= SERIAL_SUMMARY_MS) {
        lastSummaryMs = now;
        char legacyTxt[40] = "";
        if (legacy) snprintf(legacyTxt, sizeof(legacyTxt), " (LEGACY S3A, state %u)", (unsigned)sState);
        Serial.printf("[A3] mask applied=0x%03X wanted=0x%03X | S3A age %lu ms%s%s | A2 %s door=%s helmet=%.1f cm\n",
                      (unsigned)appliedMask, (unsigned)wantMask, (unsigned long)(now - lastS3A),
                      legacyTxt, orphaned ? " (ORPHANED)" : "",
                      a2Known ? "ok" : "silent", doorOpen ? "OPEN" : "CLOSED", (double)helmet);
    }

    delay(2); // yield; the loop is tiny and timing here is millisecond-level at most
}
